openpowerquality/opq/README.md

Welcome to the master repository for OPQ technology. 

For details on OPQ, please see [http://openpowerquality.org](http://openpowerquality.org).
