openpowerquality/opq/box/Software/Readme.md

## Raspberry Pi firmware for opqbox2.
Directory listing:

- Triggering : Main data acquisition and local processing. C++
- kernel : Kernel driver for the OPQBOX2. C
- DSPutill : Utilities for flashing and reseting the DSP. Python
- proto : Google Protobuf implementation of data serialization. Protobuf
- test : Tests for DSP firmware and software. Python/C/C++
