openpowerquality/opq/box/Schematics/v3/README.md

# OPQBox V3

Redesing of OPQBox v2 to utilize CHIP pro SBC designed in KiCAD.
