openpowerquality/opq/uh-metering-bridge/doc/summary.md

### Available meters to features

| Meter | Available Features |
|---|---|
|AG_ENGINEERING_MAIN_MTR|AVG_CURRENT_THD, AVG_VOLTAGE_THD, Amps, AmpsA, AmpsB, AmpsC, Frequency, PHASE_A_CF, PHASE_A_TX_THDF, PHASE_B_CF, PHASE_B_TX_THDF, PHASE_C_CF, PHASE_C_TX_THDF, PowerFactor, VAB, VAN, VBC, VBN, VCA, VCN, kVA, kVARS, kVARh, kVAh, kW, kWh|
|AG_ENGINEERING_MCC_MTR|AVG_CURRENT_THD, AVG_VOLTAGE_THD, Amps, AmpsA, AmpsB, AmpsC, COMM_ALARM, Frequency, PHASE_A_CF, PHASE_A_TX_THDF, PHASE_B_CF, PHASE_B_TX_THDF, PHASE_C_CF, PHASE_C_TX_THDF, PowerFactor, VAB, VAN, VBC, VBN, VCA, VCN, kVA, kVARS, kVARh, kVAh, kW, kWh|
|AGRICULTURAL_ENGINEERING_INST_BLDG_KEY_PERF_IND|WATTS_PER_SQ_FT, kW|
|AGRICULTURAL_SCIENCE_CUP|AG_SCIENCE_CH_1_STATUS, AG_SCIENCE_CH_2_STATUS, CHWP_1_Amps, CHWP_2_Amps, CHWR_Temp, CHWS_Temp, CHW_Flow, CT_1_Amps, CT_2_Amps, CWP_1_Amps, CWP_2_Amps, btu_hr|
|AG_SCIENCE_MCC_MTR|AVG_CURRENT_THD, AVG_VOLTAGE_THD, Amps, AmpsA, AmpsB, AmpsC, COMM_ALARM, Frequency, PHASE_A_CF, PHASE_A_TX_THDF, PHASE_B_CF, PHASE_B_TX_THDF, PHASE_C_CF, PHASE_C_TX_THDF, PowerFactor, VAB, VAN, VBC, VBN, VCA, VCN, kVA, kVARS, kVARh, kVAh, kW, kWh|
|ARCHITECTURE_BLDG_KEY_PERF_IND|WATTS_PER_SQ_FT, kW|
|AGRICULTURAL_SCIENCE_BLDG_KEY_PERF_IND|WATTS_PER_SQ_FT, kW|
|ATHLETICS_COMPLEX_CUP|CHWR_TEMP, CHWS_TEMP, CHW_FLOW, TOTAL_HEAT|
|ARCHITECTURE_MAIN_MTR|AmpsA, AmpsB, AmpsC, CURRENT_A_THD, CURRENT_B_THD, CURRENT_C_THD, Frequency, PowerFactor, SERIAL_NO, VAB, VAN, VBC, VBN, VCA, VCN, VOLAGE_CN_THD, VOLTAGE_AN_THD, VOLTAGE_BN_THD, VOLTAGE_CN_THD, kVA, kVARS, kVARh, kVAh, kW, kWh|
|BACHMAN_HALL_BLDG_KEY_PERF_IND|WATTS_PER_SQ_FT, kW|
|BACHMAN_HALL_MAIN_MTR|AmpsA, AmpsB, AmpsC, CURRENT_A_THD, CURRENT_B_THD, CURRENT_C_THD, Frequency, PowerFactor, VAB, VAN, VBC, VBN, VCA, VCN, VOLAGE_CN_THD, VOLTAGE_AN_THD, VOLTAGE_BN_THD, VOLTAGE_CN_THD, kVA, kVARS, kVARh, kVAh, kW, kWh|
|BILGER_ADD_HALL_CUP|BILGER_ADD_HALL_CHWP_1_STATUS, BILGER_ADD_HALL_CHWP_2_STATUS, BILGER_ADD_HALL_CH_1_STATUS, BILGER_ADD_HALL_CT_1_STATUS, BILGER_ADD_HALL_CT_2_STATUS, BILGER_ADD_HALL_CWP_1_STATUS, BILGER_ADD_HALL_CWP_2_STATUS, CHWR_Temp, CHWS_Temp, CHW_Flow, TOTAL_HEAT|
|BILGER_ADDITION_HALL_BLDG_KEY_PERF_IND|WATTS_PER_SQ_FT, kW|
|BIOMEDICAL_SCIENCE_CUP|CHWR_TEMP, CHWS_TEMP, CHW_FLOW, TOTAL_HEAT|
|BIOMEDICAL_SCIENCE_BLDG_KEY_PERF_IND|WATTS_PER_SQ_FT, kW|
|BIOMEDICAL_SCIENCE_CH_1_MTR|AVG_CURRENT_THD, AVG_VOLTAGE_THD, Amps, AmpsA, AmpsB, AmpsC, Frequency, PHASE_A_CF, PHASE_A_TX_THDF, PHASE_B_CF, PHASE_B_TX_THDF, PHASE_C_CF, PHASE_C_TX_THDF, PowerFactor, VAB, VAN, VBC, VBN, VCA, VCN, kVA, kVARS, kVARh, kVAh, kW, kWh|
|BIOMEDICAL_SCIENCE_CH_2_MTR|AVG_CURRENT_THD, AVG_VOLTAGE_THD, Amps, AmpsA, AmpsB, AmpsC, Frequency, PHASE_A_CF, PHASE_A_TX_THDF, PHASE_B_CF, PHASE_B_TX_THDF, PHASE_C_CF, PHASE_C_TX_THDF, PowerFactor, VAB, VAN, VBC, VBN, VCA, VCN, kVA, kVARS, kVARh, kVAh, kW, kWh|
|BIOMEDICAL_SCIENCE_MAIN_A_MTR|AVG_CURRENT_THD, AVG_VOLTAGE_THD, Amps, AmpsA, AmpsB, AmpsC, Frequency, PHASE_A_CF, PHASE_A_TX_THDF, PHASE_B_CF, PHASE_B_TX_THDF, PHASE_C_CF, PHASE_C_TX_THDF, PowerFactor, VAB, VAN, VBC, VBN, VCA, VCN, kVA, kVARS, kVARh, kVAh, kW, kWh|
|BIOMEDICAL_SCIENCE_MAIN_B_MTR|AVG_CURRENT_THD, AVG_VOLTAGE_THD, Amps, AmpsA, AmpsB, AmpsC, Frequency, PHASE_A_CF, PHASE_A_TX_THDF, PHASE_B_CF, PHASE_B_TX_THDF, PHASE_C_CF, PHASE_C_TX_THDF, PowerFactor, VAB, VAN, VBC, VBN, VCA, VCN, kVA, kVARS, kVARh, kVAh, kW, kWh|
|BIOMEDICAL_SCIENCE_MCC_A_MTR|AVG_CURRENT_THD, AVG_VOLTAGE_THD, Amps, AmpsA, AmpsB, AmpsC, Frequency, PHASE_A_CF, PHASE_A_TX_THDF, PHASE_B_CF, PHASE_B_TX_THDF, PHASE_C_CF, PHASE_C_TX_THDF, PowerFactor, VAB, VAN, VBC, VBN, VCA, VCN, kVA, kVARS, kVARh, kVAh, kW, kWh|
|SHIDLER_COBA_CUP|CHWR_TEMP, CHWS_TEMP, CHW_FLOW, TOTAL_HEAT|
|BUS_AD_SHIDLER_MAIN_MTR|AmpsA, AmpsB, AmpsC, CURRENT_A_THD, CURRENT_B_THD, CURRENT_C_THD, Frequency, PowerFactor, VAB, VAN, VBC, VBN, VCA, VCN, VOLAGE_CN_THD, VOLTAGE_AN_THD, VOLTAGE_BN_THD, kVA, kVARS, kVARh, kVAh, kW, kWh|
|BUSINESS_ADMINISTRATION_BLDG_KEY_PERF_IND|WATTS_PER_SQ_FT, kW|
|CENTER_FOR_KOREAN_STUDIES_BLDG_KEY_PERF_IND|WATTS_PER_SQ_FT, kW|
|KOREAN_STUDIES_MAIN_MTR|AmpsA, AmpsB, AmpsC, CURRENT_A_THD, CURRENT_B_THD, CURRENT_C_THD, Frequency, PowerFactor, VAB, VAN, VBC, VBN, VCA, VCN, VOLTAGE_AN_THD, VOLTAGE_BN_THD, VOLTAGE_CN_THD, kVA, kVARS, kVARh, kVAh, kW, kWh|
|CRAWFORD_LAW_BLDG_KEY_PERF_IND|WATTS_PER_SQ_FT, kW|
|CRAWFORD_HALL_MAIN_MTR|AmpsA, AmpsB, AmpsC, CURRENT_A_THD, CURRENT_B_THD, CURRENT_C_THD, Frequency, PowerFactor, VAB, VAN, VBC, VBN, VCA, VCN, VOLAGE_CN_THD, VOLTAGE_AN_THD, VOLTAGE_BN_THD, VOLTAGE_CN_THD, kVA, kVARS, kVARh, kVAh, kW, kWh|
|DEAN_HALL_BLDG_KEY_PERF_IND|WATTS_PER_SQ_FT, kW|
|DEAN_HALL_MAIN_MTR|AVG_CURRENT_THD, AVG_VOLTAGE_THD, Amps, AmpsA, AmpsB, AmpsC, Frequency, PHASE_A_CF, PHASE_A_TX_THDF, PHASE_B_CF, PHASE_B_TX_THDF, PHASE_C_CF, PHASE_C_TX_THDF, PowerFactor, VAB, VAN, VBC, VBN, VCA, VCN, kVA, kVARS, kVARh, kVAh, kW, kWh|
|DKAC_BLDG_KEY_PERF_IND|WATTS_PER_SQ_FT, kW|
|DKAC_POOL_MAIN_MTR|AmpsA, AmpsB, AmpsC, CURRENT_A_THD, CURRENT_B_THD, CURRENT_C_THD, Frequency, PowerFactor, VAB, VAN, VBC, VBN, VCA, VCN, VOLAGE_CN_THD, VOLTAGE_AN_THD, VOLTAGE_BN_THD, VOLTAGE_CN_THD, kVA, kVARS, kVARh, kVAh, kW, kWh|
|EDMONSON_HALL_CUP|CHWR_TEMP, CHWS_TEMP, CHW_FLOW, TOTAL_HEAT|
|EDMONSON_HALL_BLDG_KEY_PERF_IND|WATTS_PER_SQ_FT, kW|
|ENV_PROTECTION_FACILITY_BLDG_KEY_PERF_IND|WATTS_PER_SQ_FT, kW|
|ENV_PROTECTION_MAIN_MTR|AmpsA, AmpsB, AmpsC, CURRENT_A_THD, CURRENT_B_THD, CURRENT_C_THD, Frequency, PowerFactor, VAB, VAN, VBC, VBN, VCA, VCN, VOLAGE_CN_THD, VOLTAGE_AN_THD, VOLTAGE_BN_THD, VOLTAGE_CN_THD, kVA, kVARS, kVARh, kVAh, kW, kWh|
|EVERLY_HALL_BLDG_KEY_PERF_IND|WATTS_PER_SQ_FT, kW|
|EVERLY_HALL_MAIN_MTR|AVG_CURRENT_THD, AVG_VOLTAGE_THD, Amps, AmpsA, AmpsB, AmpsC, Frequency, PHASE_A_CF, PHASE_A_TX_THDF, PHASE_B_CF, PHASE_B_TX_THDF, PHASE_C_CF, PHASE_C_TX_THDF, PowerFactor, VAB, VAN, VBC, VBN, VCA, VCN, kVA, kVARS, kVARh, kVAh, kW, kWh|
|FROG_1_AHU|DUCT_RETURN_HUMIDITY, DUCT_RETURN_TEMP, DUCT_SUPPLY_HUMIDITY, DUCT_SUPPLY_TEMP, KWH, KW_AVERAGE, kW|
|FROG_1_BLDG_SERVICES|KWH, KW_AVERAGE, kW|
|FROG_1_CEILING_FANS|KWH, KW_AVERAGE, kW|
|FROG_1_CHILLER|KWH, KW_AVERAGE, kW|
|FROG_1_EXTERIOR_LIGHTS|KWH, KW_AVERAGE, kW|
|FROG_1_FIRE_ALARM|KWH, KW_AVERAGE, kW|
|FROG_1_LUTRON_LIGHTS|KWH, KW_AVERAGE, kW|
|FROG_1_SERVICE_LIGHTS|KWH, KW_AVERAGE, kW|
|FROG_1_SOLAR_1|KWH, KW_AVERAGE, kW|
|FROG_1_SOLAR_2|KWH, KW_AVERAGE, kW|
|FROG_1_SPACE_ENVIRONMENT|CO2, WALL_TEMP_1, WALL_TEMP_2, WALL_TEMP_3, ZONE_1_HUMIDITY, ZONE_1_TEMP, ZONE_2_HUMIDITY, ZONE_2_TEMP|
|FROG_1_WHOLE_BLDG|KWH, KW_AVERAGE, kW|
|FROG_1_WINDOW_ACTUATORS|KWH, KW_AVERAGE, kW|
|FROG_1_WEATHER_STATION|BAROMETRIC_PRESSURE, DEWPOINT, HUMIDITY, SOLAR_RADIATION, TEMP_DRY_BULB, WIND_DIRECTION, WIND_SPEED|
|FROG_2_AHU|DUCT_RETURN_HUMIDITY, DUCT_RETURN_TEMP, DUCT_SUPPLY_HUMIDITY, DUCT_SUPPLY_TEMP, KWH, KW_AVERAGE, kW|
|FROG_2_BLDG_SERVICES|KWH, KW_AVERAGE, kW|
|FROG_2_CEILING_FANS|KWH, KW_AVERAGE, kW|
|FROG_2_CHILLER|KWH, KW_AVERAGE, kW|
|FROG_2_EXTERIOR_LIGHTS|KWH, KW_AVERAGE, kW|
|FROG_2_FIRE_ALARM|KWH, KW_AVERAGE, kW|
|FROG_2_LUTRON_LIGHTS|KWH, KW_AVERAGE, kW|
|FROG_2_SERVICE_LIGHTS|KWH, KW_AVERAGE, kW|
|FROG_2_SOLAR_1|KWH, KW_AVERAGE, kW|
|FROG_2_SOLAR_2|KWH, KW_AVERAGE, kW|
|FROG_2_SPACE_ENVIRONMENT|CO2, WALL_TEMP_1, WALL_TEMP_2, WALL_TEMP_3, ZONE_1_HUMIDITY, ZONE_1_TEMP, ZONE_2_HUMIDITY, ZONE_2_TEMP|
|FROG_2_WHOLE_BLDG|KWH, KW_AVERAGE, kW|
|FROG_2_WINDOW_ACTUATORS|KWH, KW_AVERAGE, kW|
|GEORGE_HALL_BLDG_KEY_PERF_IND|WATTS_PER_SQ_FT, kW|
|GEORGE_HALL_MAIN_MTR|AVG_CURRENT_THD, AVG_VOLTAGE_THD, AmpsA, AmpsB, AmpsC, CURRENT_A_THD, CURRENT_B_THD, CURRENT_C_THD, Frequency, PowerFactor, VAB, VAN, VBC, VBN, VCA, VCN, VOLTAGE_AN_THD, VOLTAGE_BN_THD, VOLTAGE_CN_THD, kVA, kVARS, kVARh, kVAh, kW, kWh|
|GILMORE_HALL_CUP|CHWR_Temp, CHWS_Temp, CHW_Flow, GILMORE_HALL_CHWP_1_STATUS, GILMORE_HALL_CHWP_2_STATUS, GILMORE_HALL_CH_1_STATUS, GILMORE_HALL_CH_2_STATUS, GILMORE_HALL_CT_1_STATUS, GILMORE_HALL_CT_2_STATUS, GILMORE_HALL_CWP_1_STATUS, GILMORE_HALL_CWP_2_STATUS, TOTAL_HEAT|
|GILMORE_HALL_BLDG_KEY_PERF_IND|WATTS_PER_SQ_FT, kW|
|GILMORE_HALL_MAIN_A_MTR|AVG_CURRENT_THD, AVG_VOLTAGE_THD, Amps, AmpsA, AmpsB, AmpsC, Frequency, PHASE_A_CF, PHASE_A_TX_THDF, PHASE_B_CF, PHASE_B_TX_THDF, PHASE_C_CF, PHASE_C_TX_THDF, PowerFactor, VAB, VAN, VBC, VBN, VCA, VCN, kVA, kVARS, kVARh, kVAh, kW, kWh|
|GILMORE_HALL_MAIN_B_MTR|AVG_CURRENT_THD, AVG_VOLTAGE_THD, Amps, AmpsA, AmpsB, AmpsC, Frequency, PHASE_A_CF, PHASE_A_TX_THDF, PHASE_B_CF, PHASE_B_TX_THDF, PHASE_C_CF, PHASE_C_TX_THDF, PowerFactor, VAB, VAN, VBC, VBN, VCA, VCN, kVA, kVARS, kVARh, kVAh, kW, kWh|
|GILMORE_HALL_MCC_MTR|AVG_CURRENT_THD, AVG_VOLTAGE_THD, Amps, AmpsA, AmpsB, AmpsC, Frequency, PHASE_A_CF, PHASE_A_TX_THDF, PHASE_B_CF, PHASE_B_TX_THDF, PHASE_C_CF, PHASE_C_TX_THDF, PowerFactor, VAB, VAN, VBC, VBN, VCA, VCN, kVA, kVARS, kVARh, kVAh, kW, kWh|
|HAMILTON_LIBRARY_PH_III_CUP|CHWR_TEMP, CHWS_TEMP, CHW_FLOW, TOTAL_HEAT|
|HAMILTON_LIBRARY_PH_III_BLDG_KEY_PERF_IND|WATTS_PER_SQ_FT, kW|
|HAMILTON_LIB_PH_III_CH_1_MTR|AVG_CURRENT_THD, AVG_VOLTAGE_THD, Amps, AmpsA, AmpsB, AmpsC, Frequency, PHASE_A_CF, PHASE_A_TX_THDF, PHASE_B_CF, PHASE_B_TX_THDF, PHASE_C_CF, PHASE_C_TX_THDF, PowerFactor, VAB, VAN, VBC, VBN, VCA, VCN, kVA, kVARS, kVARh, kVAh, kW, kWh|
|HAMILTON_LIB_PH_III_CH_2_MTR|AVG_CURRENT_THD, AVG_VOLTAGE_THD, Amps, AmpsA, AmpsB, AmpsC, Frequency, PHASE_A_CF, PHASE_A_TX_THDF, PHASE_B_CF, PHASE_B_TX_THDF, PHASE_C_CF, PHASE_C_TX_THDF, PowerFactor, VAB, VAN, VBC, VBN, VCA, VCN, kVA, kVARS, kVARh, kVAh, kW, kWh|
|HAMILTON_LIB_PH_III_CH_3_MTR|AVG_CURRENT_THD, AVG_VOLTAGE_THD, Amps, AmpsA, AmpsB, AmpsC, Frequency, PHASE_A_CF, PHASE_A_TX_THDF, PHASE_B_CF, PHASE_B_TX_THDF, PHASE_C_CF, PHASE_C_TX_THDF, PowerFactor, VAB, VAN, VBC, VBN, VCA, VCN, kVA, kVARS, kVARh, kVAh, kW, kWh|
|HAMILTON_LIB_PH_III_MAIN_1_MTR|AVG_CURRENT_THD, AVG_VOLTAGE_THD, AmpsA, AmpsB, AmpsC, Frequency, PHASE_A_CF, PHASE_A_TX_THDF, PHASE_B_CF, PHASE_B_TX_THDF, PHASE_C_CF, PHASE_C_TX_THDF, PowerFactor, VAB, VAN, VBC, VBN, VCA, VCN, kVA, kVARS, kVARh, kVAh, kW, kWh|
|HAMILTON_LIB_PH_III_MAIN_2_MTR|AVG_CURRENT_THD, AVG_VOLTAGE_THD, Amps, AmpsA, AmpsB, AmpsC, Frequency, PHASE_A_CF, PHASE_A_TX_THDF, PHASE_B_CF, PHASE_B_TX_THDF, PHASE_C_CF, PHASE_C_TX_THDF, PowerFactor, VAB, VAN, VBC, VBN, VCA, VCN, kVA, kVARS, kVARh, kVAh, kW, kWh|
|HAMILTON_LIB_PH_III_MCC_AC1_MTR|AVG_CURRENT_THD, AVG_VOLTAGE_THD, Amps, AmpsA, AmpsB, AmpsC, Frequency, PHASE_A_CF, PHASE_A_TX_THDF, PHASE_B_CF, PHASE_B_TX_THDF, PHASE_C_CF, PHASE_C_TX_THDF, PowerFactor, VAB, VAN, VBC, VBN, VCA, VCN, kVA, kVARS, kVARh, kVAh, kW, kWh|
|HAMILTON_LIB_PH_III_MCC_AC2_MTR|AVG_CURRENT_THD, AVG_VOLTAGE_THD, Amps, AmpsA, AmpsB, AmpsC, Frequency, PHASE_A_CF, PHASE_A_TX_THDF, PHASE_B_CF, PHASE_B_TX_THDF, PHASE_C_CF, PHASE_C_TX_THDF, PowerFactor, VAB, VAN, VBC, VBN, VCA, VCN, kVA, kVARS, kVARh, kVAh, kW, kWh|
|HAWAII_HALL_BLDG_KEY_PERF_IND|WATTS_PER_SQ_FT, kW|
|HAWAII_HALL_MAIN_MTR|AmpsA, AmpsB, AmpsC, CURRENT_A_THD, CURRENT_B_THD, CURRENT_C_THD, Frequency, PowerFactor, VAB, VAN, VBC, VBN, VCA, VCN, VOLAGE_CN_THD, VOLTAGE_AN_THD, VOLTAGE_BN_THD, VOLTAGE_CN_THD, kVA, kVARS, kVARh, kVAh, kW, kWh|
|HIG_BLDG_KEY_PERF_IND|WATTS_PER_SQ_FT, kW|
|HIG_NOAA_MTR|AVG_CURRENT_THD, AVG_VOLTAGE_THD, Amps, AmpsA, AmpsB, AmpsC, Frequency, PHASE_A_CF, PHASE_A_TX_THDF, PHASE_B_CF, PHASE_B_TX_THDF, PHASE_C_CF, PHASE_C_TX_THDF, PowerFactor, VAB, VAN, VBC, VBN, VCA, VCN, kVA, kVARS, kVARh, kVAh, kW, kWh|
|HIG_PANEL_PB_MTR|Amps, AmpsA, AmpsB, AmpsC, Frequency, PHASE_A_CF, PHASE_A_TX_THDF, PHASE_B_CF, PHASE_B_TX_THDF, PHASE_C_CF, PHASE_C_TX_THDF, PowerFactor, VAB, VAN, VBC, VBN, VCA, VCN, kVA, kVARS, kVARh, kVAh, kW, kWh|
|HIG_PANEL_PBA_MTR|Amps, AmpsA, AmpsB, AmpsC, Frequency, PHASE_A_CF, PHASE_A_TX_THDF, PHASE_B_CF, PHASE_B_TX_THDF, PHASE_C_CF, PHASE_C_TX_THDF, PowerFactor, VAB, VAN, VBC, VBN, VCA, VCN, kVA, kVARS, kVARh, kVAh, kW, kWh|
|HIG_SUBSTATION_1_MAIN_MTR|Amps, AmpsA, AmpsB, AmpsC, EVENT_NUMBER, FLAG_1_ALARM_STATUS, FLAG_2_ALARM_STATUS, Frequency, GENERAL_ALARM_STATUS, PHASE_A_CF, PHASE_A_TX_THDF, PHASE_B_CF, PHASE_B_TX_THDF, PHASE_C_CF, PHASE_C_TX_THDF, PowerFactor, VAB, VAN, VBC, VBN, VCA, VCN, kVA, kVARS, kVARh, kVAh, kW, kWh|
|HIG_SUBSTATION_2_MAIN_MTR|Amps, AmpsA, AmpsB, AmpsC, Frequency, PHASE_A_CF, PHASE_A_TX_THDF, PHASE_B_CF, PHASE_B_TX_THDF, PHASE_C_CF, PHASE_C_TX_THDF, PowerFactor, VAB, VAN, VBC, VBN, VCA, VCN, kVA, kVARS, kVARh, kVAh, kW, kWh|
|HIG_SUBSTATION_3_MAIN_MTR|Amps, AmpsA, AmpsB, AmpsC, Frequency, PHASE_A_CF, PHASE_A_TX_THDF, PHASE_B_CF, PHASE_B_TX_THDF, PHASE_C_CF, PHASE_C_TX_THDF, PowerFactor, VAB, VAN, VBC, VBN, VCA, VCN, kVA, kVARS, kVARh, kVAh, kW, kWh|
|HPER_BLDG_KEY_PERF_IND|WATTS_PER_SQ_FT, kW|
|HPER_KLUM_GYM_MTR|AmpsA, AmpsB, AmpsC, CURRENT_A_THD, CURRENT_B_THD, CURRENT_C_THD, Frequency, PowerFactor, VAB, VAN, VBC, VBN, VCA, VCN, VOLTAGE_AN_THD, VOLTAGE_BN_THD, VOLTAGE_CN_THD, kVA, kVARS, kVARh, kVAh, kW, kWh|
|HPER_MAIN_MTR|Amps, AmpsA, AmpsB, AmpsC, CURRENT_A_THD, CURRENT_B_THD, CURRENT_C_THD, Frequency, PowerFactor, VAB, VAN, VBC, VBN, VCA, VCN, VOLTAGE_AN_THD, VOLTAGE_BN_THD, VOLTAGE_CN_THD, kVA, kVARS, kVARh, kVAh, kW, kWh|
|INSTITUTE_FOR_ASTRONOMY_CUP|CHWR_TEMP, CHWS_TEMP, CHW_FLOW, TOTAL_HEAT|
|INSITITUTE_FOR_ASTRONOMY_BLDG_KEY_PERF_IND|WATTS_PER_SQ_FT, kW|
|IT_CENTER_CUP|CHWR_TEMP, CHWS_TEMP, CHW_FLOW, TOTAL_HEAT|
|IT_CENTER_BLDG_KEY_PERF_IND|WATTS_PER_SQ_FT, kW|
|KELLER_HALL_BLDG_KEY_PERF_IND|WATTS_PER_SQ_FT, kW|
|KELLER_HALL_MAIN_MTR|AmpsA, AmpsB, AmpsC, CURRENT_A_THD, CURRENT_B_THD, CURRENT_C_THD, Frequency, PowerFactor, VAB, VAN, VBC, VBN, VCA, VCN, VOLAGE_CN_THD, VOLTAGE_AN_THD, VOLTAGE_BN_THD, VOLTAGE_CN_THD, kVA, kVARS, kVARh, kVAh, kW, kWh|
|PHYSICAL_SCIENCE_KELLER_COMP_MTR|AmpsA, AmpsB, AmpsC, CURRENT_A_THD, CURRENT_B_THD, CURRENT_C_THD, Frequency, PowerFactor, VAB, VAN, VBC, VBN, VCA, VCN, VOLAGE_CN_THD, VOLTAGE_AN_THD, VOLTAGE_BN_THD, VOLTAGE_CN_THD, kVA, kVARS, kVARh, kVAh, kW, kWh|
|KENNEDY_THEATRE_BLDG_KEY_PERF_IND|WATTS_PER_SQ_FT, kW|
|KENNEDY_THEATRE_MAIN_MTR|AmpsA, AmpsB, AmpsC, CURRENT_A_THD, CURRENT_B_THD, CURRENT_C_THD, Frequency, PowerFactor, VAB, VAN, VBC, VBN, VCA, VCN, VOLTAGE_AN_THD, VOLTAGE_BN_THD, VOLTAGE_CN_THD, kVA, kVARS, kVARh, kVAh, kW, kWh|
|KRAUSS_HALL_MAIN_MTR|AmpsA, AmpsB, AmpsC, CURRENT_A_THD, CURRENT_B_THD, CURRENT_C_THD, Frequency, PowerFactor, VAB, VAN, VBC, VBN, VCA, VCN, VOLTAGE_AN_THD, VOLTAGE_BN_THD, VOLTAGE_CN_THD, kVA, kVARS, kVARh, kVAh, kW, kWh|
|KRAUSS_PRI_BLDG_KEY_PERF_IND|WATTS_PER_SQ_FT, kW|
|KUYKENDALL_HALL_CUP|CHWR_TEMP, CHWS_TEMP|
|KUYKENDALL_HALL_BLDG_KEY_PERF_IND|WATTS_PER_SQ_FT, kW|
|LAW_LIB_MAIN_MTR|AmpsA, AmpsB, AmpsC, CURRENT_A_THD, CURRENT_B_THD, CURRENT_C_THD, Frequency, PowerFactor, VAB, VAN, VBC, VBN, VCA, VCN, VOLTAGE_AN_THD, VOLTAGE_BN_THD, VOLTAGE_CN_THD, kVA, kVARS, kVARh, kVAh, kW, kWh|
|LAW_LIBRARY_BLDG_KEY_PERF_IND|WATTS_PER_SQ_FT, kW|
|LAW_SCHOOL_BLDG_KEY_PERF_IND|WATTS_PER_SQ_FT, kW|
|LAW_SCHOOL_MAIN_MTR|AmpsA, AmpsB, AmpsC, CURRENT_A_THD, CURRENT_B_THD, CURRENT_C_THD, Frequency, PowerFactor, VAB, VAN, VBC, VBN, VCA, VCN, VOLTAGE_AN_THD, VOLTAGE_BN_THD, VOLTAGE_CN_THD, kVA, kVARS, kVARh, kVAh, kW, kWh|
|LES_MURAKAMI_STADIUM_BLDG_KEY_PERF_IND|WATTS_PER_SQ_FT, kW|
|LES_MURAKAMI_STADIUM_CONSESS_MTR|AmpsA, AmpsB, AmpsC, CURRENT_A_THD, CURRENT_B_THD, CURRENT_C_THD, Frequency, PowerFactor, VAB, VAN, VBC, VBN, VCA, VCN, VOLTAGE_AN_THD, VOLTAGE_BN_THD, VOLTAGE_CN_THD, kVA, kVARS, kVARh, kVAh, kW, kWh|
|LES_MURAKAMI_STADIUM_MAIN_MTR|AmpsA, AmpsB, AmpsC, CURRENT_A_THD, CURRENT_B_THD, CURRENT_C_THD, Frequency, PowerFactor, VAB, VAN, VBC, VBN, VCA, VCN, VOLTAGE_AN_THD, VOLTAGE_BN_THD, VOLTAGE_CN_THD, kVA, kVARS, kVARh, kVAh, kW, kWh|
|MARINE_SCIENCE_CUP|CHWR_Temp, CHWS_Temp, CHW_Flow, CT_1_Amps, CT_2_Status_Amps, CWP_1_Amps, CWP_2_Amps, MARINE_SCIENCE_CHWP_1_STATUS, MARINE_SCIENCE_CHWP_2_STATUS, MARINE_SCIENCE_CH_1_STATUS, MARINE_SCIENCE_CH_2_STATUS, TOTAL_HEAT|
|MARINE_SCIENCE_BLDG_KEY_PERF_IND|WATTS_PER_SQ_FT, kW|
|MARINE_SCIENCE_MAIN_A_MTR|AVG_CURRENT_THD, AVG_VOLTAGE_THD, Amps, AmpsA, AmpsB, AmpsC, Frequency, PHASE_A_CF, PHASE_A_TX_THDF, PHASE_B_CF, PHASE_B_TX_THDF, PHASE_C_CF, PHASE_C_TX_THDF, PowerFactor, VAB, VAN, VBC, VBN, VCA, VCN, kVA, kVARS, kVARh, kVAh, kW, kWh|
|MARINE_SCIENCE_MAIN_B_MTR|AVG_CURRENT_THD, AVG_VOLTAGE_THD, Amps, AmpsA, AmpsB, AmpsC, Frequency, PHASE_A_CF, PHASE_A_TX_THDF, PHASE_B_CF, PHASE_B_TX_THDF, PHASE_C_CF, PHASE_C_TX_THDF, PowerFactor, VAB, VAN, VBC, VBN, VCA, VCN, kVA, kVARS, kVARh, kVAh, kW, kWh|
|MARINE_SCIENCE_MCC_MTR|AVG_CURRENT_THD, AVG_VOLTAGE_THD, Amps, AmpsA, AmpsB, AmpsC, Frequency, PHASE_A_CF, PHASE_A_TX_THDF, PHASE_B_CF, PHASE_B_TX_THDF, PHASE_C_CF, PHASE_C_TX_THDF, PowerFactor, VAB, VAN, VBC, VBN, VCA, VCN, kVA, kVARS, kVARh, kVAh, kW, kWh|
|MILLER_HALL_BLDG_KEY_PERF_IND|WATTS_PER_SQ_FT, kW|
|MILLER_HALL_MAIN_MTR|AVG_CURRENT_THD, AVG_VOLTAGE_THD, Amps, AmpsA, AmpsB, AmpsC, Frequency, PHASE_A_CF, PHASE_A_TX_THDF, PHASE_B_CF, PHASE_B_TX_THDF, PHASE_C_CF, PHASE_C_TX_THDF, PowerFactor, VAB, VAN, VBC, VBN, VCA, VCN, kVA, kVARS, kVARh, kVAh, kW, kWh|
|MOORE_HALL_CUP|RISER_1_CHWR_TEMP, RISER_1_CHWS_TEMP, RISER_1_CHW_FLOW, RISER_2_CHWR_TEMP, RISER_2_CHWS_TEMP, RISER_2_CHW_FLOW, TOTAL_HEAT|
|MOORE_HALL_BLDG_KEY_PERF_IND|WATTS_PER_SQ_FT, kW|
|MOORE_HALL_MAIN_MTR|AmpsA, AmpsB, AmpsC, CURRENT_A_THD, CURRENT_B_THD, CURRENT_C_THD, Frequency, PowerFactor, VAB, VAN, VBC, VBN, VCA, VCN, VOLTAGE_AN_THD, VOLTAGE_BN_THD, VOLTAGE_CN_THD, kVA, kVARS, kVARh, kVAh, kW, kWh|
|MUSIC_COMPLEX_CUP|CHWR_TEMP, CHWS_TEMP, CHW_FLOW, TOTAL_HEAT|
|MUSIC_COMPLEX_MAIN_MTR|AmpsA, AmpsB, AmpsC, CURRENT_A_THD, CURRENT_B_THD, CURRENT_C_THD, Frequency, PowerFactor, VAB, VAN, VBC, VBN, VCA, VCN, VOLTAGE_AN_THD, VOLTAGE_BN_THD, VOLTAGE_CN_THD, kVA, kVARS, kVARh, kVAh, kW, kWh|
|MUSIC_COMPLEX_PH_I_BLDG_KEY_PERF_IND|WATTS_PER_SQ_FT, kW|
|PBRC_BLDG_KEY_PERF_IND|WATTS_PER_SQ_FT, kW|
|PBRC_MAIN_A_MTR|AmpsA, AmpsB, AmpsC, CURRENT_A_THD, CURRENT_B_THD, CURRENT_C_THD, Frequency, PowerFactor, VAB, VAN, VBC, VBN, VCA, VCN, VOLTAGE_AN_THD, VOLTAGE_BN_THD, VOLTAGE_CN_THD, kVA, kVARS, kVARh, kVAh, kW, kWh|
|PBRC_MAIN_B_MTR|AmpsA, AmpsB, AmpsC, CURRENT_A_THD, CURRENT_B_THD, CURRENT_C_THD, Frequency, PowerFactor, VAB, VAN, VBC, VBN, VCA, VCN, VOLTAGE_AN_THD, VOLTAGE_BN_THD, VOLTAGE_CN_THD, kVA, kVARS, kVARh, kVAh, kW, kWh|
|PBRC_SATCON_GEN_2|KWH, kW|
|PHYSICAL_SCIENCE_BLDG_KEY_PERF_IND|WATTS_PER_SQ_FT, kW|
|PHYSICAL_SCIENCE_MAIN_MTR|AVG_CURRENT_THD, AVG_VOLTAGE_THD, Amps, AmpsA, AmpsB, AmpsC, Frequency, PHASE_A_CF, PHASE_A_TX_THDF, PHASE_B_CF, PHASE_B_TX_THDF, PHASE_C_CF, PHASE_C_TX_THDF, PowerFactor, VAB, VAN, VBC, VBN, VCA, VCN, kVA, kVARS, kVARh, kVAh, kW, kWh|
|POST_CUP|PCHWR_Temp, PCHWS_Temp, POST_CHWP_1_STATUS, POST_CHWP_2_STATUS, POST_CHWP_3_STATUS, POST_CH_1_STATUS, POST_CH_2_STATUS, POST_CT_1_STATUS, POST_CT_2_STATUS, POST_CT_3_STATUS, POST_CWP_1_STATUS, POST_CWP_2_STATUS, POST_CWP_3_STATUS, POST_SCHWP_1_STATUS, POST_SCHWP_2_STATUS, POST_SCHWP_3_STATUS|
|POST_BLDG_KEY_PERF_IND|WATTS_PER_SQ_FT, kW|
|POST_CHILLER_PLANT_MAIN|AVG_CURRENT_THD, AVG_VOLTAGE_THD, Amps, AmpsA, AmpsB, AmpsC, Frequency, PHASE_A_CF, PHASE_A_TX_THDF, PHASE_B_CF, PHASE_B_TX_THDF, PHASE_C_CF, PHASE_C_TX_THDF, PowerFactor, VAB, VAN, VBC, VBN, VCA, VCN, kVA, kVARS, kVARh, kVAh, kW, kWh|
|POST_MAIN_1|AVG_CURRENT_THD, AVG_VOLTAGE_THD, Amps, AmpsA, AmpsB, AmpsC, Frequency, PHASE_A_CF, PHASE_A_TX_THDF, PHASE_B_CF, PHASE_B_TX_THDF, PHASE_C_CF, PHASE_C_TX_THDF, PowerFactor, VAB, VAN, VBC, VBN, VCA, VCN, kVA, kVARS, kVARh, kVAh, kW, kWh|
|POST_MAIN_2|AVG_CURRENT_THD, AVG_VOLTAGE_THD, Amps, AmpsA, AmpsB, AmpsC, Frequency, PHASE_A_CF, PHASE_A_TX_THDF, PHASE_B_CF, PHASE_B_TX_THDF, PHASE_C_CF, PHASE_C_TX_THDF, PowerFactor, VAB, VAN, VBC, VBN, VCA, VCN, kVA, kVARS, kVARh, kVAh, kW, kWh|
|QLC_CUP|CHWR_TEMP, CHWS_TEMP, CHW_FLOW, TOTAL_HEAT|
|QLCSS_BLDG_KEY_PERF_IND|WATTS_PER_SQ_FT, kW|
|QLCSS_MAIN_MTR|AmpsA, AmpsB, AmpsC, CURRENT_A_THD, CURRENT_B_THD, CURRENT_C_THD, Frequency, PowerFactor, VAB, VAN, VBC, VBN, VCA, VCN, VOLTAGE_AN_THD, VOLTAGE_BN_THD, VOLTAGE_CN_THD, kVA, kVARS, kVARh, kVAh, kW, kWh|
|QUAD_CHILLER_PLANT_MAIN_MTR|AVG_CURRENT_THD, AVG_VOLTAGE_THD, Amps, AmpsA, AmpsB, AmpsC, Frequency, PHASE_A_CF, PHASE_A_TX_THDF, PHASE_B_CF, PHASE_B_TX_THDF, PHASE_C_CF, PHASE_C_TX_THDF, PowerFactor, VAB, VAN, VBC, VBN, VCA, VCN, kVA, kVARS, kVARh, kVAh, kW, kWh|
|QUADRANGLE_LOOP_BLDG_KEY_PERF_IND|WATTS_PER_SQ_FT, kW|
|SAKAMAKI_HALL_AC_EQPT_MTR|AVG_CURRENT_THD, AVG_VOLTAGE_THD, Amps, AmpsA, AmpsB, AmpsC, Frequency, PHASE_A_CF, PHASE_A_TX_THDF, PHASE_B_CF, PHASE_B_TX_THDF, PHASE_C_CF, PHASE_C_TX_THDF, PowerFactor, VAB, VAN, VBC, VBN, VCA, VCN, kVA, kVARS, kVARh, kVAh, kW, kWh|
|SAKAMAKI_HALL_BLDG_KEY_PERF_IND|WATTS_PER_SQ_FT, kW|
|SAKAMAKI_HALL_MAIN_MTR|AVG_CURRENT_THD, AVG_VOLTAGE_THD, Amps, AmpsA, AmpsB, AmpsC, Frequency, PHASE_A_CF, PHASE_A_TX_THDF, PHASE_B_CF, PHASE_B_TX_THDF, PHASE_C_CF, PHASE_C_TX_THDF, PowerFactor, VAB, VAN, VBC, VBN, VCA, VCN, kVA, kVARS, kVARh, kVAh, kW, kWh|
|SAUNDERS_HALL_CUP|CHWP_1_AMPS, CHWP_2_AMPS, CHWR_TEMP, CHWS_TEMP, CHW_FLOW, CT_1_AMPS, CT_2_AMPS, CWP_1_AMPS, CWP_2_AMPS, SAUNDERS_HALL_CH_1_STATUS, SAUNDERS_HALL_CH_2_STATUS, TOTAL_HEAT|
|SAUNDERS_HALL_BLDG_KEY_PERF_IND|WATTS_PER_SQ_FT, kW|
|SAUNDERS_HALL_MAIN_A_MTR|AVG_CURRENT_THD, AVG_VOLTAGE_THD, Amps, AmpsA, AmpsB, AmpsC, Frequency, PHASE_A_CF, PHASE_A_TX_THDF, PHASE_B_CF, PHASE_B_TX_THDF, PHASE_C_CF, PHASE_C_TX_THDF, PowerFactor, VAB, VAN, VBC, VBN, VCA, VCN, kVA, kVARS, kVARh, kVAh, kW, kWh|
|SAUNDERS_HALL_MAIN_B_MTR|AVG_CURRENT_THD, AVG_VOLTAGE_THD, Amps, AmpsA, AmpsB, AmpsC, Frequency, PHASE_A_CF, PHASE_A_TX_THDF, PHASE_B_CF, PHASE_B_TX_THDF, PHASE_C_CF, PHASE_C_TX_THDF, PowerFactor, VAB, VAN, VBC, VBN, VCA, VCN, kVA, kVARS, kVARh, kVAh, kW, kWh|
|SHERMAN_LAB_CUP|CHWR_Temp, CHWS_Temp, CHW_Flow_Vel|
|SHERMAN_LAB_BLDG_KEY_PERF_IND|WATTS_PER_SQ_FT, kW|
|SHERMAN_MAIN_1_MTR|AVG_CURRENT_THD, AVG_VOLTAGE_THD, Amps, AmpsA, AmpsB, AmpsC, Frequency, PHASE_A_CF, PHASE_A_TX_THDF, PHASE_B_CF, PHASE_B_TX_THDF, PHASE_C_CF, PHASE_C_TX_THDF, PowerFactor, VAB, VAN, VBC, VBN, VCA, VCN, kVA, kVARS, kVARh, kVAh, kW, kWh|
|SHERMAN_MAIN_2_MTR|AVG_CURRENT_THD, AVG_VOLTAGE_THD, Amps, AmpsA, AmpsB, AmpsC, Frequency, PHASE_A_CF, PHASE_A_TX_THDF, PHASE_B_CF, PHASE_B_TX_THDF, PHASE_C_CF, PHASE_C_TX_THDF, PowerFactor, VAB, VAN, VBC, VBN, VCA, VCN, kVA, kVARS, kVARh, kVAh, kW, kWh|
|SPALDING_HALL_BLDG_KEY_PERF_IND|WATTS_PER_SQ_FT, kW|
|SPALDING_HALL_MAIN_MTR|AmpsA, AmpsB, AmpsC, CURRENT_A_THD, CURRENT_B_THD, CURRENT_C_THD, Frequency, PowerFactor, VAB, VAN, VBC, VBN, VCA, VCN, VOLTAGE_AN_THD, VOLTAGE_BN_THD, VOLTAGE_CN_THD, kVA, kVARS, kVARh, kVAh, kW, kWh|
|ST_JOHN_CUP|CHWR_Temp, CHWS_Temp, CHW_Flow, TOTAL_HEAT|
|ST_JOHN_BLDG_KEY_PERF_IND|WATTS_PER_SQ_FT, kW|
|ST_JOHN_PLANT_SCIENCE_MAIN_MTR|AVG_CURRENT_THD, AVG_VOLTAGE_THD, Amps, AmpsA, AmpsB, AmpsC, Frequency, PHASE_A_CF, PHASE_A_TX_THDF, PHASE_B_CF, PHASE_B_TX_THDF, PHASE_C_CF, PHASE_C_TX_THDF, PowerFactor, VAB, VAN, VBC, VBN, VCA, VCN, kVA, kVARS, kVARh, kVAh, kW, kWh|
|STAN_SHERRIFF_CUP|CHWR_TEMP, CHWS_TEMP, CHW_FLOW, TOTAL_HEAT|
|STAN_SHERIFF_CENTER_BLDG_KEY_PERF_IND|WATTS_PER_SQ_FT, kW|
|STAN_SHERIFF_CTR_MAIN_1_MTR|AVG_CURRENT_THD, AVG_VOLTAGE_THD, Amps, AmpsA, AmpsB, AmpsC, Frequency, PHASE_A_CF, PHASE_A_TX_THDF, PHASE_B_CF, PHASE_B_TX_THDF, PHASE_C_CF, PHASE_C_TX_THDF, PowerFactor, VAB, VAN, VBC, VBN, VCA, VCN, kVA, kVARS, kVARh, kVAh, kW, kWh|
|STAN_SHERIFF_CTR_MAIN_2_MTR|AVG_CURRENT_THD, AVG_VOLTAGE_THD, Amps, AmpsA, AmpsB, AmpsC, Frequency, PHASE_A_CF, PHASE_A_TX_THDF, PHASE_B_CF, PHASE_B_TX_THDF, PHASE_C_CF, PHASE_C_TX_THDF, PowerFactor, VAB, VAN, VBC, VBN, VCA, VCN, kVA, kVARS, kVARh, kVAh, kW, kWh|
|SUBSTATION_L_BLDG_KEY_PERF_IND|KWH, WATTS_PER_SQ_FT, kW|
|SUBSTATION_L_Q1_MTR|COMM_ALARM, KWH|
|SUBSTATION_L_Q2_MTR|COMM_ALARM, KWH|
|SUBSTATION_L_Q3_MTR|COMM_ALARM, KWH|
|MULTIPURPOSE_BLDG_MAIN_MTR|AmpsA, AmpsB, AmpsC, CURRENT_A_THD, CURRENT_B_THD, CURRENT_C_THD, Frequency, PowerFactor, VAB, VAN, VBC, VBN, VCA, VCN, VOLTAGE_AN_THD, VOLTAGE_BN_THD, VOLTAGE_CN_THD, kVA, kVARS, kVARh, kVAh, kW, kWh|
|UNIV_LAB_SCHOOL_MULTIPURPOSE_BLDG_KEY_PERF_IND|WATTS_PER_SQ_FT, kW|
|WARRIOR_CENTER_BLDG_KEY_PERF_IND|WATTS_PER_SQ_FT, kW|
|WARRIOR_CENTER_INV0|AC_CURRENT, AC_VOLTS, Frequency, KWH, kW|
|WARRIOR_CENTER_INV1|AC_CURRENT, AC_VOLTS, Frequency, KWH, kW|
|WARRIOR_CENTER_INV2|AC_CURRENT, AC_VOLTS, KWH, kW|
|WARRIOR_CENTER_INV3|AC_CURRENT, AC_VOLTS, KWH, kW|
|WEBSTER_HALL_BLDG_KEY_PERF_IND|WATTS_PER_SQ_FT, kW|
|WEBSTER_HALL_MAIN_MTR|AVG_CURRENT_THD, AVG_VOLTAGE_THD, Amps, AmpsA, AmpsB, AmpsC, Frequency, PHASE_A_CF, PHASE_A_TX_THDF, PHASE_B_CF, PHASE_B_TX_THDF, PHASE_C_CF, PHASE_C_TX_THDF, PowerFactor, VAB, VAN, VBC, VBN, VCA, VCN, kVA, kVARS, kVARh, kVAh, kW, kWh|
|WIST_HALL_EVERLY_HALL_CUP|CHWR_TEMP, CHWS_TEMP, EVERLY_HALL_FLOW, TOTAL_HEAT, WIST_HALL_EVERLY_HALL_CHWP_1_STATUS, WIST_HALL_EVERLY_HALL_CHWP_2_STATUS, WIST_HALL_EVERLY_HALL_CH_1_STATUS, WIST_HALL_EVERLY_HALL_CH_2_STATUS, WIST_HALL_EVERLY_HALL_CT_1_STATUS, WIST_HALL_EVERLY_HALL_CT_2_STATUS, WIST_HALL_EVERLY_HALL_CWP_1_STATUS, WIST_HALL_EVERLY_HALL_CWP_2_STATUS, WIST_HALL_FLOW|
|WIST_HALL_BLDG_KEY_PERF_IND|WATTS_PER_SQ_FT, kW|
|WIST_HALL_MAIN_MTR|AVG_CURRENT_THD, AVG_VOLTAGE_THD, Amps, AmpsA, AmpsB, AmpsC, Frequency, PHASE_A_CF, PHASE_A_TX_THDF, PHASE_B_CF, PHASE_B_TX_THDF, PHASE_C_CF, PHASE_C_TX_THDF, PowerFactor, VAB, VAN, VBC, VBN, VCA, VCN, kVA, kVARS, kVARh, kVAh, kW, kWh|

### Available features to meters
| Feature | Available Meters |
|---|---|
|AC_CURRENT|WARRIOR_CENTER_INV0, WARRIOR_CENTER_INV1, WARRIOR_CENTER_INV2, WARRIOR_CENTER_INV3|
|AC_VOLTS|WARRIOR_CENTER_INV0, WARRIOR_CENTER_INV1, WARRIOR_CENTER_INV2, WARRIOR_CENTER_INV3|
|AG_SCIENCE_CH_1_STATUS|AGRICULTURAL_SCIENCE_CUP|
|AG_SCIENCE_CH_2_STATUS|AGRICULTURAL_SCIENCE_CUP|
|AVG_CURRENT_THD|AG_ENGINEERING_MAIN_MTR, AG_ENGINEERING_MCC_MTR, AG_SCIENCE_MCC_MTR, BIOMEDICAL_SCIENCE_CH_1_MTR, BIOMEDICAL_SCIENCE_CH_2_MTR, BIOMEDICAL_SCIENCE_MAIN_A_MTR, BIOMEDICAL_SCIENCE_MAIN_B_MTR, BIOMEDICAL_SCIENCE_MCC_A_MTR, DEAN_HALL_MAIN_MTR, EVERLY_HALL_MAIN_MTR, GEORGE_HALL_MAIN_MTR, GILMORE_HALL_MAIN_A_MTR, GILMORE_HALL_MAIN_B_MTR, GILMORE_HALL_MCC_MTR, HAMILTON_LIB_PH_III_CH_1_MTR, HAMILTON_LIB_PH_III_CH_2_MTR, HAMILTON_LIB_PH_III_CH_3_MTR, HAMILTON_LIB_PH_III_MAIN_1_MTR, HAMILTON_LIB_PH_III_MAIN_2_MTR, HAMILTON_LIB_PH_III_MCC_AC1_MTR, HAMILTON_LIB_PH_III_MCC_AC2_MTR, HIG_NOAA_MTR, MARINE_SCIENCE_MAIN_A_MTR, MARINE_SCIENCE_MAIN_B_MTR, MARINE_SCIENCE_MCC_MTR, MILLER_HALL_MAIN_MTR, PHYSICAL_SCIENCE_MAIN_MTR, POST_CHILLER_PLANT_MAIN, POST_MAIN_1, POST_MAIN_2, QUAD_CHILLER_PLANT_MAIN_MTR, SAKAMAKI_HALL_AC_EQPT_MTR, SAKAMAKI_HALL_MAIN_MTR, SAUNDERS_HALL_MAIN_A_MTR, SAUNDERS_HALL_MAIN_B_MTR, SHERMAN_MAIN_1_MTR, SHERMAN_MAIN_2_MTR, ST_JOHN_PLANT_SCIENCE_MAIN_MTR, STAN_SHERIFF_CTR_MAIN_1_MTR, STAN_SHERIFF_CTR_MAIN_2_MTR, WEBSTER_HALL_MAIN_MTR, WIST_HALL_MAIN_MTR|
|AVG_VOLTAGE_THD|AG_ENGINEERING_MAIN_MTR, AG_ENGINEERING_MCC_MTR, AG_SCIENCE_MCC_MTR, BIOMEDICAL_SCIENCE_CH_1_MTR, BIOMEDICAL_SCIENCE_CH_2_MTR, BIOMEDICAL_SCIENCE_MAIN_A_MTR, BIOMEDICAL_SCIENCE_MAIN_B_MTR, BIOMEDICAL_SCIENCE_MCC_A_MTR, DEAN_HALL_MAIN_MTR, EVERLY_HALL_MAIN_MTR, GEORGE_HALL_MAIN_MTR, GILMORE_HALL_MAIN_A_MTR, GILMORE_HALL_MAIN_B_MTR, GILMORE_HALL_MCC_MTR, HAMILTON_LIB_PH_III_CH_1_MTR, HAMILTON_LIB_PH_III_CH_2_MTR, HAMILTON_LIB_PH_III_CH_3_MTR, HAMILTON_LIB_PH_III_MAIN_1_MTR, HAMILTON_LIB_PH_III_MAIN_2_MTR, HAMILTON_LIB_PH_III_MCC_AC1_MTR, HAMILTON_LIB_PH_III_MCC_AC2_MTR, HIG_NOAA_MTR, MARINE_SCIENCE_MAIN_A_MTR, MARINE_SCIENCE_MAIN_B_MTR, MARINE_SCIENCE_MCC_MTR, MILLER_HALL_MAIN_MTR, PHYSICAL_SCIENCE_MAIN_MTR, POST_CHILLER_PLANT_MAIN, POST_MAIN_1, POST_MAIN_2, QUAD_CHILLER_PLANT_MAIN_MTR, SAKAMAKI_HALL_AC_EQPT_MTR, SAKAMAKI_HALL_MAIN_MTR, SAUNDERS_HALL_MAIN_A_MTR, SAUNDERS_HALL_MAIN_B_MTR, SHERMAN_MAIN_1_MTR, SHERMAN_MAIN_2_MTR, ST_JOHN_PLANT_SCIENCE_MAIN_MTR, STAN_SHERIFF_CTR_MAIN_1_MTR, STAN_SHERIFF_CTR_MAIN_2_MTR, WEBSTER_HALL_MAIN_MTR, WIST_HALL_MAIN_MTR|
|Amps|AG_ENGINEERING_MAIN_MTR, AG_ENGINEERING_MCC_MTR, AG_SCIENCE_MCC_MTR, BIOMEDICAL_SCIENCE_CH_1_MTR, BIOMEDICAL_SCIENCE_CH_2_MTR, BIOMEDICAL_SCIENCE_MAIN_A_MTR, BIOMEDICAL_SCIENCE_MAIN_B_MTR, BIOMEDICAL_SCIENCE_MCC_A_MTR, DEAN_HALL_MAIN_MTR, EVERLY_HALL_MAIN_MTR, GILMORE_HALL_MAIN_A_MTR, GILMORE_HALL_MAIN_B_MTR, GILMORE_HALL_MCC_MTR, HAMILTON_LIB_PH_III_CH_1_MTR, HAMILTON_LIB_PH_III_CH_2_MTR, HAMILTON_LIB_PH_III_CH_3_MTR, HAMILTON_LIB_PH_III_MAIN_2_MTR, HAMILTON_LIB_PH_III_MCC_AC1_MTR, HAMILTON_LIB_PH_III_MCC_AC2_MTR, HIG_NOAA_MTR, HIG_PANEL_PB_MTR, HIG_PANEL_PBA_MTR, HIG_SUBSTATION_1_MAIN_MTR, HIG_SUBSTATION_2_MAIN_MTR, HIG_SUBSTATION_3_MAIN_MTR, HPER_MAIN_MTR, MARINE_SCIENCE_MAIN_A_MTR, MARINE_SCIENCE_MAIN_B_MTR, MARINE_SCIENCE_MCC_MTR, MILLER_HALL_MAIN_MTR, PHYSICAL_SCIENCE_MAIN_MTR, POST_CHILLER_PLANT_MAIN, POST_MAIN_1, POST_MAIN_2, QUAD_CHILLER_PLANT_MAIN_MTR, SAKAMAKI_HALL_AC_EQPT_MTR, SAKAMAKI_HALL_MAIN_MTR, SAUNDERS_HALL_MAIN_A_MTR, SAUNDERS_HALL_MAIN_B_MTR, SHERMAN_MAIN_1_MTR, SHERMAN_MAIN_2_MTR, ST_JOHN_PLANT_SCIENCE_MAIN_MTR, STAN_SHERIFF_CTR_MAIN_1_MTR, STAN_SHERIFF_CTR_MAIN_2_MTR, WEBSTER_HALL_MAIN_MTR, WIST_HALL_MAIN_MTR|
|AmpsA|AG_ENGINEERING_MAIN_MTR, AG_ENGINEERING_MCC_MTR, AG_SCIENCE_MCC_MTR, ARCHITECTURE_MAIN_MTR, BACHMAN_HALL_MAIN_MTR, BIOMEDICAL_SCIENCE_CH_1_MTR, BIOMEDICAL_SCIENCE_CH_2_MTR, BIOMEDICAL_SCIENCE_MAIN_A_MTR, BIOMEDICAL_SCIENCE_MAIN_B_MTR, BIOMEDICAL_SCIENCE_MCC_A_MTR, BUS_AD_SHIDLER_MAIN_MTR, KOREAN_STUDIES_MAIN_MTR, CRAWFORD_HALL_MAIN_MTR, DEAN_HALL_MAIN_MTR, DKAC_POOL_MAIN_MTR, ENV_PROTECTION_MAIN_MTR, EVERLY_HALL_MAIN_MTR, GEORGE_HALL_MAIN_MTR, GILMORE_HALL_MAIN_A_MTR, GILMORE_HALL_MAIN_B_MTR, GILMORE_HALL_MCC_MTR, HAMILTON_LIB_PH_III_CH_1_MTR, HAMILTON_LIB_PH_III_CH_2_MTR, HAMILTON_LIB_PH_III_CH_3_MTR, HAMILTON_LIB_PH_III_MAIN_1_MTR, HAMILTON_LIB_PH_III_MAIN_2_MTR, HAMILTON_LIB_PH_III_MCC_AC1_MTR, HAMILTON_LIB_PH_III_MCC_AC2_MTR, HAWAII_HALL_MAIN_MTR, HIG_NOAA_MTR, HIG_PANEL_PB_MTR, HIG_PANEL_PBA_MTR, HIG_SUBSTATION_1_MAIN_MTR, HIG_SUBSTATION_2_MAIN_MTR, HIG_SUBSTATION_3_MAIN_MTR, HPER_KLUM_GYM_MTR, HPER_MAIN_MTR, KELLER_HALL_MAIN_MTR, PHYSICAL_SCIENCE_KELLER_COMP_MTR, KENNEDY_THEATRE_MAIN_MTR, KRAUSS_HALL_MAIN_MTR, LAW_LIB_MAIN_MTR, LAW_SCHOOL_MAIN_MTR, LES_MURAKAMI_STADIUM_CONSESS_MTR, LES_MURAKAMI_STADIUM_MAIN_MTR, MARINE_SCIENCE_MAIN_A_MTR, MARINE_SCIENCE_MAIN_B_MTR, MARINE_SCIENCE_MCC_MTR, MILLER_HALL_MAIN_MTR, MOORE_HALL_MAIN_MTR, MUSIC_COMPLEX_MAIN_MTR, PBRC_MAIN_A_MTR, PBRC_MAIN_B_MTR, PHYSICAL_SCIENCE_MAIN_MTR, POST_CHILLER_PLANT_MAIN, POST_MAIN_1, POST_MAIN_2, QLCSS_MAIN_MTR, QUAD_CHILLER_PLANT_MAIN_MTR, SAKAMAKI_HALL_AC_EQPT_MTR, SAKAMAKI_HALL_MAIN_MTR, SAUNDERS_HALL_MAIN_A_MTR, SAUNDERS_HALL_MAIN_B_MTR, SHERMAN_MAIN_1_MTR, SHERMAN_MAIN_2_MTR, SPALDING_HALL_MAIN_MTR, ST_JOHN_PLANT_SCIENCE_MAIN_MTR, STAN_SHERIFF_CTR_MAIN_1_MTR, STAN_SHERIFF_CTR_MAIN_2_MTR, MULTIPURPOSE_BLDG_MAIN_MTR, WEBSTER_HALL_MAIN_MTR, WIST_HALL_MAIN_MTR|
|AmpsB|AG_ENGINEERING_MAIN_MTR, AG_ENGINEERING_MCC_MTR, AG_SCIENCE_MCC_MTR, ARCHITECTURE_MAIN_MTR, BACHMAN_HALL_MAIN_MTR, BIOMEDICAL_SCIENCE_CH_1_MTR, BIOMEDICAL_SCIENCE_CH_2_MTR, BIOMEDICAL_SCIENCE_MAIN_A_MTR, BIOMEDICAL_SCIENCE_MAIN_B_MTR, BIOMEDICAL_SCIENCE_MCC_A_MTR, BUS_AD_SHIDLER_MAIN_MTR, KOREAN_STUDIES_MAIN_MTR, CRAWFORD_HALL_MAIN_MTR, DEAN_HALL_MAIN_MTR, DKAC_POOL_MAIN_MTR, ENV_PROTECTION_MAIN_MTR, EVERLY_HALL_MAIN_MTR, GEORGE_HALL_MAIN_MTR, GILMORE_HALL_MAIN_A_MTR, GILMORE_HALL_MAIN_B_MTR, GILMORE_HALL_MCC_MTR, HAMILTON_LIB_PH_III_CH_1_MTR, HAMILTON_LIB_PH_III_CH_2_MTR, HAMILTON_LIB_PH_III_CH_3_MTR, HAMILTON_LIB_PH_III_MAIN_1_MTR, HAMILTON_LIB_PH_III_MAIN_2_MTR, HAMILTON_LIB_PH_III_MCC_AC1_MTR, HAMILTON_LIB_PH_III_MCC_AC2_MTR, HAWAII_HALL_MAIN_MTR, HIG_NOAA_MTR, HIG_PANEL_PB_MTR, HIG_PANEL_PBA_MTR, HIG_SUBSTATION_1_MAIN_MTR, HIG_SUBSTATION_2_MAIN_MTR, HIG_SUBSTATION_3_MAIN_MTR, HPER_KLUM_GYM_MTR, HPER_MAIN_MTR, KELLER_HALL_MAIN_MTR, PHYSICAL_SCIENCE_KELLER_COMP_MTR, KENNEDY_THEATRE_MAIN_MTR, KRAUSS_HALL_MAIN_MTR, LAW_LIB_MAIN_MTR, LAW_SCHOOL_MAIN_MTR, LES_MURAKAMI_STADIUM_CONSESS_MTR, LES_MURAKAMI_STADIUM_MAIN_MTR, MARINE_SCIENCE_MAIN_A_MTR, MARINE_SCIENCE_MAIN_B_MTR, MARINE_SCIENCE_MCC_MTR, MILLER_HALL_MAIN_MTR, MOORE_HALL_MAIN_MTR, MUSIC_COMPLEX_MAIN_MTR, PBRC_MAIN_A_MTR, PBRC_MAIN_B_MTR, PHYSICAL_SCIENCE_MAIN_MTR, POST_CHILLER_PLANT_MAIN, POST_MAIN_1, POST_MAIN_2, QLCSS_MAIN_MTR, QUAD_CHILLER_PLANT_MAIN_MTR, SAKAMAKI_HALL_AC_EQPT_MTR, SAKAMAKI_HALL_MAIN_MTR, SAUNDERS_HALL_MAIN_A_MTR, SAUNDERS_HALL_MAIN_B_MTR, SHERMAN_MAIN_1_MTR, SHERMAN_MAIN_2_MTR, SPALDING_HALL_MAIN_MTR, ST_JOHN_PLANT_SCIENCE_MAIN_MTR, STAN_SHERIFF_CTR_MAIN_1_MTR, STAN_SHERIFF_CTR_MAIN_2_MTR, MULTIPURPOSE_BLDG_MAIN_MTR, WEBSTER_HALL_MAIN_MTR, WIST_HALL_MAIN_MTR|
|AmpsC|AG_ENGINEERING_MAIN_MTR, AG_ENGINEERING_MCC_MTR, AG_SCIENCE_MCC_MTR, ARCHITECTURE_MAIN_MTR, BACHMAN_HALL_MAIN_MTR, BIOMEDICAL_SCIENCE_CH_1_MTR, BIOMEDICAL_SCIENCE_CH_2_MTR, BIOMEDICAL_SCIENCE_MAIN_A_MTR, BIOMEDICAL_SCIENCE_MAIN_B_MTR, BIOMEDICAL_SCIENCE_MCC_A_MTR, BUS_AD_SHIDLER_MAIN_MTR, KOREAN_STUDIES_MAIN_MTR, CRAWFORD_HALL_MAIN_MTR, DEAN_HALL_MAIN_MTR, DKAC_POOL_MAIN_MTR, ENV_PROTECTION_MAIN_MTR, EVERLY_HALL_MAIN_MTR, GEORGE_HALL_MAIN_MTR, GILMORE_HALL_MAIN_A_MTR, GILMORE_HALL_MAIN_B_MTR, GILMORE_HALL_MCC_MTR, HAMILTON_LIB_PH_III_CH_1_MTR, HAMILTON_LIB_PH_III_CH_2_MTR, HAMILTON_LIB_PH_III_CH_3_MTR, HAMILTON_LIB_PH_III_MAIN_1_MTR, HAMILTON_LIB_PH_III_MAIN_2_MTR, HAMILTON_LIB_PH_III_MCC_AC1_MTR, HAMILTON_LIB_PH_III_MCC_AC2_MTR, HAWAII_HALL_MAIN_MTR, HIG_NOAA_MTR, HIG_PANEL_PB_MTR, HIG_PANEL_PBA_MTR, HIG_SUBSTATION_1_MAIN_MTR, HIG_SUBSTATION_2_MAIN_MTR, HIG_SUBSTATION_3_MAIN_MTR, HPER_KLUM_GYM_MTR, HPER_MAIN_MTR, KELLER_HALL_MAIN_MTR, PHYSICAL_SCIENCE_KELLER_COMP_MTR, KENNEDY_THEATRE_MAIN_MTR, KRAUSS_HALL_MAIN_MTR, LAW_LIB_MAIN_MTR, LAW_SCHOOL_MAIN_MTR, LES_MURAKAMI_STADIUM_CONSESS_MTR, LES_MURAKAMI_STADIUM_MAIN_MTR, MARINE_SCIENCE_MAIN_A_MTR, MARINE_SCIENCE_MAIN_B_MTR, MARINE_SCIENCE_MCC_MTR, MILLER_HALL_MAIN_MTR, MOORE_HALL_MAIN_MTR, MUSIC_COMPLEX_MAIN_MTR, PBRC_MAIN_A_MTR, PBRC_MAIN_B_MTR, PHYSICAL_SCIENCE_MAIN_MTR, POST_CHILLER_PLANT_MAIN, POST_MAIN_1, POST_MAIN_2, QLCSS_MAIN_MTR, QUAD_CHILLER_PLANT_MAIN_MTR, SAKAMAKI_HALL_AC_EQPT_MTR, SAKAMAKI_HALL_MAIN_MTR, SAUNDERS_HALL_MAIN_A_MTR, SAUNDERS_HALL_MAIN_B_MTR, SHERMAN_MAIN_1_MTR, SHERMAN_MAIN_2_MTR, SPALDING_HALL_MAIN_MTR, ST_JOHN_PLANT_SCIENCE_MAIN_MTR, STAN_SHERIFF_CTR_MAIN_1_MTR, STAN_SHERIFF_CTR_MAIN_2_MTR, MULTIPURPOSE_BLDG_MAIN_MTR, WEBSTER_HALL_MAIN_MTR, WIST_HALL_MAIN_MTR|
|BAROMETRIC_PRESSURE|FROG_1_WEATHER_STATION|
|BILGER_ADD_HALL_CHWP_1_STATUS|BILGER_ADD_HALL_CUP|
|BILGER_ADD_HALL_CHWP_2_STATUS|BILGER_ADD_HALL_CUP|
|BILGER_ADD_HALL_CH_1_STATUS|BILGER_ADD_HALL_CUP|
|BILGER_ADD_HALL_CT_1_STATUS|BILGER_ADD_HALL_CUP|
|BILGER_ADD_HALL_CT_2_STATUS|BILGER_ADD_HALL_CUP|
|BILGER_ADD_HALL_CWP_1_STATUS|BILGER_ADD_HALL_CUP|
|BILGER_ADD_HALL_CWP_2_STATUS|BILGER_ADD_HALL_CUP|
|CHWP_1_AMPS|SAUNDERS_HALL_CUP|
|CHWP_1_Amps|AGRICULTURAL_SCIENCE_CUP|
|CHWP_2_AMPS|SAUNDERS_HALL_CUP|
|CHWP_2_Amps|AGRICULTURAL_SCIENCE_CUP|
|CHWR_TEMP|ATHLETICS_COMPLEX_CUP, BIOMEDICAL_SCIENCE_CUP, SHIDLER_COBA_CUP, EDMONSON_HALL_CUP, HAMILTON_LIBRARY_PH_III_CUP, INSTITUTE_FOR_ASTRONOMY_CUP, IT_CENTER_CUP, KUYKENDALL_HALL_CUP, MUSIC_COMPLEX_CUP, QLC_CUP, SAUNDERS_HALL_CUP, STAN_SHERRIFF_CUP, WIST_HALL_EVERLY_HALL_CUP|
|CHWR_Temp|AGRICULTURAL_SCIENCE_CUP, BILGER_ADD_HALL_CUP, GILMORE_HALL_CUP, MARINE_SCIENCE_CUP, SHERMAN_LAB_CUP, ST_JOHN_CUP|
|CHWS_TEMP|ATHLETICS_COMPLEX_CUP, BIOMEDICAL_SCIENCE_CUP, SHIDLER_COBA_CUP, EDMONSON_HALL_CUP, HAMILTON_LIBRARY_PH_III_CUP, INSTITUTE_FOR_ASTRONOMY_CUP, IT_CENTER_CUP, KUYKENDALL_HALL_CUP, MUSIC_COMPLEX_CUP, QLC_CUP, SAUNDERS_HALL_CUP, STAN_SHERRIFF_CUP, WIST_HALL_EVERLY_HALL_CUP|
|CHWS_Temp|AGRICULTURAL_SCIENCE_CUP, BILGER_ADD_HALL_CUP, GILMORE_HALL_CUP, MARINE_SCIENCE_CUP, SHERMAN_LAB_CUP, ST_JOHN_CUP|
|CHW_FLOW|ATHLETICS_COMPLEX_CUP, BIOMEDICAL_SCIENCE_CUP, SHIDLER_COBA_CUP, EDMONSON_HALL_CUP, HAMILTON_LIBRARY_PH_III_CUP, INSTITUTE_FOR_ASTRONOMY_CUP, IT_CENTER_CUP, MUSIC_COMPLEX_CUP, QLC_CUP, SAUNDERS_HALL_CUP, STAN_SHERRIFF_CUP|
|CHW_Flow|AGRICULTURAL_SCIENCE_CUP, BILGER_ADD_HALL_CUP, GILMORE_HALL_CUP, MARINE_SCIENCE_CUP, ST_JOHN_CUP|
|CHW_Flow_Vel|SHERMAN_LAB_CUP|
|CO2|FROG_1_SPACE_ENVIRONMENT, FROG_2_SPACE_ENVIRONMENT|
|COMM_ALARM|AG_ENGINEERING_MCC_MTR, AG_SCIENCE_MCC_MTR, SUBSTATION_L_Q1_MTR, SUBSTATION_L_Q2_MTR, SUBSTATION_L_Q3_MTR|
|CT_1_AMPS|SAUNDERS_HALL_CUP|
|CT_1_Amps|AGRICULTURAL_SCIENCE_CUP, MARINE_SCIENCE_CUP|
|CT_2_AMPS|SAUNDERS_HALL_CUP|
|CT_2_Amps|AGRICULTURAL_SCIENCE_CUP|
|CT_2_Status_Amps|MARINE_SCIENCE_CUP|
|CURRENT_A_THD|ARCHITECTURE_MAIN_MTR, BACHMAN_HALL_MAIN_MTR, BUS_AD_SHIDLER_MAIN_MTR, KOREAN_STUDIES_MAIN_MTR, CRAWFORD_HALL_MAIN_MTR, DKAC_POOL_MAIN_MTR, ENV_PROTECTION_MAIN_MTR, GEORGE_HALL_MAIN_MTR, HAWAII_HALL_MAIN_MTR, HPER_KLUM_GYM_MTR, HPER_MAIN_MTR, KELLER_HALL_MAIN_MTR, PHYSICAL_SCIENCE_KELLER_COMP_MTR, KENNEDY_THEATRE_MAIN_MTR, KRAUSS_HALL_MAIN_MTR, LAW_LIB_MAIN_MTR, LAW_SCHOOL_MAIN_MTR, LES_MURAKAMI_STADIUM_CONSESS_MTR, LES_MURAKAMI_STADIUM_MAIN_MTR, MOORE_HALL_MAIN_MTR, MUSIC_COMPLEX_MAIN_MTR, PBRC_MAIN_A_MTR, PBRC_MAIN_B_MTR, QLCSS_MAIN_MTR, SPALDING_HALL_MAIN_MTR, MULTIPURPOSE_BLDG_MAIN_MTR|
|CURRENT_B_THD|ARCHITECTURE_MAIN_MTR, BACHMAN_HALL_MAIN_MTR, BUS_AD_SHIDLER_MAIN_MTR, KOREAN_STUDIES_MAIN_MTR, CRAWFORD_HALL_MAIN_MTR, DKAC_POOL_MAIN_MTR, ENV_PROTECTION_MAIN_MTR, GEORGE_HALL_MAIN_MTR, HAWAII_HALL_MAIN_MTR, HPER_KLUM_GYM_MTR, HPER_MAIN_MTR, KELLER_HALL_MAIN_MTR, PHYSICAL_SCIENCE_KELLER_COMP_MTR, KENNEDY_THEATRE_MAIN_MTR, KRAUSS_HALL_MAIN_MTR, LAW_LIB_MAIN_MTR, LAW_SCHOOL_MAIN_MTR, LES_MURAKAMI_STADIUM_CONSESS_MTR, LES_MURAKAMI_STADIUM_MAIN_MTR, MOORE_HALL_MAIN_MTR, MUSIC_COMPLEX_MAIN_MTR, PBRC_MAIN_A_MTR, PBRC_MAIN_B_MTR, QLCSS_MAIN_MTR, SPALDING_HALL_MAIN_MTR, MULTIPURPOSE_BLDG_MAIN_MTR|
|CURRENT_C_THD|ARCHITECTURE_MAIN_MTR, BACHMAN_HALL_MAIN_MTR, BUS_AD_SHIDLER_MAIN_MTR, KOREAN_STUDIES_MAIN_MTR, CRAWFORD_HALL_MAIN_MTR, DKAC_POOL_MAIN_MTR, ENV_PROTECTION_MAIN_MTR, GEORGE_HALL_MAIN_MTR, HAWAII_HALL_MAIN_MTR, HPER_KLUM_GYM_MTR, HPER_MAIN_MTR, KELLER_HALL_MAIN_MTR, PHYSICAL_SCIENCE_KELLER_COMP_MTR, KENNEDY_THEATRE_MAIN_MTR, KRAUSS_HALL_MAIN_MTR, LAW_LIB_MAIN_MTR, LAW_SCHOOL_MAIN_MTR, LES_MURAKAMI_STADIUM_CONSESS_MTR, LES_MURAKAMI_STADIUM_MAIN_MTR, MOORE_HALL_MAIN_MTR, MUSIC_COMPLEX_MAIN_MTR, PBRC_MAIN_A_MTR, PBRC_MAIN_B_MTR, QLCSS_MAIN_MTR, SPALDING_HALL_MAIN_MTR, MULTIPURPOSE_BLDG_MAIN_MTR|
|CWP_1_AMPS|SAUNDERS_HALL_CUP|
|CWP_1_Amps|AGRICULTURAL_SCIENCE_CUP, MARINE_SCIENCE_CUP|
|CWP_2_AMPS|SAUNDERS_HALL_CUP|
|CWP_2_Amps|AGRICULTURAL_SCIENCE_CUP, MARINE_SCIENCE_CUP|
|DEWPOINT|FROG_1_WEATHER_STATION|
|DUCT_RETURN_HUMIDITY|FROG_1_AHU, FROG_2_AHU|
|DUCT_RETURN_TEMP|FROG_1_AHU, FROG_2_AHU|
|DUCT_SUPPLY_HUMIDITY|FROG_1_AHU, FROG_2_AHU|
|DUCT_SUPPLY_TEMP|FROG_1_AHU, FROG_2_AHU|
|EVENT_NUMBER|HIG_SUBSTATION_1_MAIN_MTR|
|EVERLY_HALL_FLOW|WIST_HALL_EVERLY_HALL_CUP|
|FLAG_1_ALARM_STATUS|HIG_SUBSTATION_1_MAIN_MTR|
|FLAG_2_ALARM_STATUS|HIG_SUBSTATION_1_MAIN_MTR|
|Frequency|AG_ENGINEERING_MAIN_MTR, AG_ENGINEERING_MCC_MTR, AG_SCIENCE_MCC_MTR, ARCHITECTURE_MAIN_MTR, BACHMAN_HALL_MAIN_MTR, BIOMEDICAL_SCIENCE_CH_1_MTR, BIOMEDICAL_SCIENCE_CH_2_MTR, BIOMEDICAL_SCIENCE_MAIN_A_MTR, BIOMEDICAL_SCIENCE_MAIN_B_MTR, BIOMEDICAL_SCIENCE_MCC_A_MTR, BUS_AD_SHIDLER_MAIN_MTR, KOREAN_STUDIES_MAIN_MTR, CRAWFORD_HALL_MAIN_MTR, DEAN_HALL_MAIN_MTR, DKAC_POOL_MAIN_MTR, ENV_PROTECTION_MAIN_MTR, EVERLY_HALL_MAIN_MTR, GEORGE_HALL_MAIN_MTR, GILMORE_HALL_MAIN_A_MTR, GILMORE_HALL_MAIN_B_MTR, GILMORE_HALL_MCC_MTR, HAMILTON_LIB_PH_III_CH_1_MTR, HAMILTON_LIB_PH_III_CH_2_MTR, HAMILTON_LIB_PH_III_CH_3_MTR, HAMILTON_LIB_PH_III_MAIN_1_MTR, HAMILTON_LIB_PH_III_MAIN_2_MTR, HAMILTON_LIB_PH_III_MCC_AC1_MTR, HAMILTON_LIB_PH_III_MCC_AC2_MTR, HAWAII_HALL_MAIN_MTR, HIG_NOAA_MTR, HIG_PANEL_PB_MTR, HIG_PANEL_PBA_MTR, HIG_SUBSTATION_1_MAIN_MTR, HIG_SUBSTATION_2_MAIN_MTR, HIG_SUBSTATION_3_MAIN_MTR, HPER_KLUM_GYM_MTR, HPER_MAIN_MTR, KELLER_HALL_MAIN_MTR, PHYSICAL_SCIENCE_KELLER_COMP_MTR, KENNEDY_THEATRE_MAIN_MTR, KRAUSS_HALL_MAIN_MTR, LAW_LIB_MAIN_MTR, LAW_SCHOOL_MAIN_MTR, LES_MURAKAMI_STADIUM_CONSESS_MTR, LES_MURAKAMI_STADIUM_MAIN_MTR, MARINE_SCIENCE_MAIN_A_MTR, MARINE_SCIENCE_MAIN_B_MTR, MARINE_SCIENCE_MCC_MTR, MILLER_HALL_MAIN_MTR, MOORE_HALL_MAIN_MTR, MUSIC_COMPLEX_MAIN_MTR, PBRC_MAIN_A_MTR, PBRC_MAIN_B_MTR, PHYSICAL_SCIENCE_MAIN_MTR, POST_CHILLER_PLANT_MAIN, POST_MAIN_1, POST_MAIN_2, QLCSS_MAIN_MTR, QUAD_CHILLER_PLANT_MAIN_MTR, SAKAMAKI_HALL_AC_EQPT_MTR, SAKAMAKI_HALL_MAIN_MTR, SAUNDERS_HALL_MAIN_A_MTR, SAUNDERS_HALL_MAIN_B_MTR, SHERMAN_MAIN_1_MTR, SHERMAN_MAIN_2_MTR, SPALDING_HALL_MAIN_MTR, ST_JOHN_PLANT_SCIENCE_MAIN_MTR, STAN_SHERIFF_CTR_MAIN_1_MTR, STAN_SHERIFF_CTR_MAIN_2_MTR, MULTIPURPOSE_BLDG_MAIN_MTR, WARRIOR_CENTER_INV0, WARRIOR_CENTER_INV1, WEBSTER_HALL_MAIN_MTR, WIST_HALL_MAIN_MTR|
|GENERAL_ALARM_STATUS|HIG_SUBSTATION_1_MAIN_MTR|
|GILMORE_HALL_CHWP_1_STATUS|GILMORE_HALL_CUP|
|GILMORE_HALL_CHWP_2_STATUS|GILMORE_HALL_CUP|
|GILMORE_HALL_CH_1_STATUS|GILMORE_HALL_CUP|
|GILMORE_HALL_CH_2_STATUS|GILMORE_HALL_CUP|
|GILMORE_HALL_CT_1_STATUS|GILMORE_HALL_CUP|
|GILMORE_HALL_CT_2_STATUS|GILMORE_HALL_CUP|
|GILMORE_HALL_CWP_1_STATUS|GILMORE_HALL_CUP|
|GILMORE_HALL_CWP_2_STATUS|GILMORE_HALL_CUP|
|HUMIDITY|FROG_1_WEATHER_STATION|
|KWH|FROG_1_AHU, FROG_1_BLDG_SERVICES, FROG_1_CEILING_FANS, FROG_1_CHILLER, FROG_1_EXTERIOR_LIGHTS, FROG_1_FIRE_ALARM, FROG_1_LUTRON_LIGHTS, FROG_1_SERVICE_LIGHTS, FROG_1_SOLAR_1, FROG_1_SOLAR_2, FROG_1_WHOLE_BLDG, FROG_1_WINDOW_ACTUATORS, FROG_2_AHU, FROG_2_BLDG_SERVICES, FROG_2_CEILING_FANS, FROG_2_CHILLER, FROG_2_EXTERIOR_LIGHTS, FROG_2_FIRE_ALARM, FROG_2_LUTRON_LIGHTS, FROG_2_SERVICE_LIGHTS, FROG_2_SOLAR_1, FROG_2_SOLAR_2, FROG_2_WHOLE_BLDG, FROG_2_WINDOW_ACTUATORS, PBRC_SATCON_GEN_2, SUBSTATION_L_BLDG_KEY_PERF_IND, SUBSTATION_L_Q1_MTR, SUBSTATION_L_Q2_MTR, SUBSTATION_L_Q3_MTR, WARRIOR_CENTER_INV0, WARRIOR_CENTER_INV1, WARRIOR_CENTER_INV2, WARRIOR_CENTER_INV3|
|KW_AVERAGE|FROG_1_AHU, FROG_1_BLDG_SERVICES, FROG_1_CEILING_FANS, FROG_1_CHILLER, FROG_1_EXTERIOR_LIGHTS, FROG_1_FIRE_ALARM, FROG_1_LUTRON_LIGHTS, FROG_1_SERVICE_LIGHTS, FROG_1_SOLAR_1, FROG_1_SOLAR_2, FROG_1_WHOLE_BLDG, FROG_1_WINDOW_ACTUATORS, FROG_2_AHU, FROG_2_BLDG_SERVICES, FROG_2_CEILING_FANS, FROG_2_CHILLER, FROG_2_EXTERIOR_LIGHTS, FROG_2_FIRE_ALARM, FROG_2_LUTRON_LIGHTS, FROG_2_SERVICE_LIGHTS, FROG_2_SOLAR_1, FROG_2_SOLAR_2, FROG_2_WHOLE_BLDG, FROG_2_WINDOW_ACTUATORS|
|MARINE_SCIENCE_CHWP_1_STATUS|MARINE_SCIENCE_CUP|
|MARINE_SCIENCE_CHWP_2_STATUS|MARINE_SCIENCE_CUP|
|MARINE_SCIENCE_CH_1_STATUS|MARINE_SCIENCE_CUP|
|MARINE_SCIENCE_CH_2_STATUS|MARINE_SCIENCE_CUP|
|PCHWR_Temp|POST_CUP|
|PCHWS_Temp|POST_CUP|
|PHASE_A_CF|AG_ENGINEERING_MAIN_MTR, AG_ENGINEERING_MCC_MTR, AG_SCIENCE_MCC_MTR, BIOMEDICAL_SCIENCE_CH_1_MTR, BIOMEDICAL_SCIENCE_CH_2_MTR, BIOMEDICAL_SCIENCE_MAIN_A_MTR, BIOMEDICAL_SCIENCE_MAIN_B_MTR, BIOMEDICAL_SCIENCE_MCC_A_MTR, DEAN_HALL_MAIN_MTR, EVERLY_HALL_MAIN_MTR, GILMORE_HALL_MAIN_A_MTR, GILMORE_HALL_MAIN_B_MTR, GILMORE_HALL_MCC_MTR, HAMILTON_LIB_PH_III_CH_1_MTR, HAMILTON_LIB_PH_III_CH_2_MTR, HAMILTON_LIB_PH_III_CH_3_MTR, HAMILTON_LIB_PH_III_MAIN_1_MTR, HAMILTON_LIB_PH_III_MAIN_2_MTR, HAMILTON_LIB_PH_III_MCC_AC1_MTR, HAMILTON_LIB_PH_III_MCC_AC2_MTR, HIG_NOAA_MTR, HIG_PANEL_PB_MTR, HIG_PANEL_PBA_MTR, HIG_SUBSTATION_1_MAIN_MTR, HIG_SUBSTATION_2_MAIN_MTR, HIG_SUBSTATION_3_MAIN_MTR, MARINE_SCIENCE_MAIN_A_MTR, MARINE_SCIENCE_MAIN_B_MTR, MARINE_SCIENCE_MCC_MTR, MILLER_HALL_MAIN_MTR, PHYSICAL_SCIENCE_MAIN_MTR, POST_CHILLER_PLANT_MAIN, POST_MAIN_1, POST_MAIN_2, QUAD_CHILLER_PLANT_MAIN_MTR, SAKAMAKI_HALL_AC_EQPT_MTR, SAKAMAKI_HALL_MAIN_MTR, SAUNDERS_HALL_MAIN_A_MTR, SAUNDERS_HALL_MAIN_B_MTR, SHERMAN_MAIN_1_MTR, SHERMAN_MAIN_2_MTR, ST_JOHN_PLANT_SCIENCE_MAIN_MTR, STAN_SHERIFF_CTR_MAIN_1_MTR, STAN_SHERIFF_CTR_MAIN_2_MTR, WEBSTER_HALL_MAIN_MTR, WIST_HALL_MAIN_MTR|
|PHASE_A_TX_THDF|AG_ENGINEERING_MAIN_MTR, AG_ENGINEERING_MCC_MTR, AG_SCIENCE_MCC_MTR, BIOMEDICAL_SCIENCE_CH_1_MTR, BIOMEDICAL_SCIENCE_CH_2_MTR, BIOMEDICAL_SCIENCE_MAIN_A_MTR, BIOMEDICAL_SCIENCE_MAIN_B_MTR, BIOMEDICAL_SCIENCE_MCC_A_MTR, DEAN_HALL_MAIN_MTR, EVERLY_HALL_MAIN_MTR, GILMORE_HALL_MAIN_A_MTR, GILMORE_HALL_MAIN_B_MTR, GILMORE_HALL_MCC_MTR, HAMILTON_LIB_PH_III_CH_1_MTR, HAMILTON_LIB_PH_III_CH_2_MTR, HAMILTON_LIB_PH_III_CH_3_MTR, HAMILTON_LIB_PH_III_MAIN_1_MTR, HAMILTON_LIB_PH_III_MAIN_2_MTR, HAMILTON_LIB_PH_III_MCC_AC1_MTR, HAMILTON_LIB_PH_III_MCC_AC2_MTR, HIG_NOAA_MTR, HIG_PANEL_PB_MTR, HIG_PANEL_PBA_MTR, HIG_SUBSTATION_1_MAIN_MTR, HIG_SUBSTATION_2_MAIN_MTR, HIG_SUBSTATION_3_MAIN_MTR, MARINE_SCIENCE_MAIN_A_MTR, MARINE_SCIENCE_MAIN_B_MTR, MARINE_SCIENCE_MCC_MTR, MILLER_HALL_MAIN_MTR, PHYSICAL_SCIENCE_MAIN_MTR, POST_CHILLER_PLANT_MAIN, POST_MAIN_1, POST_MAIN_2, QUAD_CHILLER_PLANT_MAIN_MTR, SAKAMAKI_HALL_AC_EQPT_MTR, SAKAMAKI_HALL_MAIN_MTR, SAUNDERS_HALL_MAIN_A_MTR, SAUNDERS_HALL_MAIN_B_MTR, SHERMAN_MAIN_1_MTR, SHERMAN_MAIN_2_MTR, ST_JOHN_PLANT_SCIENCE_MAIN_MTR, STAN_SHERIFF_CTR_MAIN_1_MTR, STAN_SHERIFF_CTR_MAIN_2_MTR, WEBSTER_HALL_MAIN_MTR, WIST_HALL_MAIN_MTR|
|PHASE_B_CF|AG_ENGINEERING_MAIN_MTR, AG_ENGINEERING_MCC_MTR, AG_SCIENCE_MCC_MTR, BIOMEDICAL_SCIENCE_CH_1_MTR, BIOMEDICAL_SCIENCE_CH_2_MTR, BIOMEDICAL_SCIENCE_MAIN_A_MTR, BIOMEDICAL_SCIENCE_MAIN_B_MTR, BIOMEDICAL_SCIENCE_MCC_A_MTR, DEAN_HALL_MAIN_MTR, EVERLY_HALL_MAIN_MTR, GILMORE_HALL_MAIN_A_MTR, GILMORE_HALL_MAIN_B_MTR, GILMORE_HALL_MCC_MTR, HAMILTON_LIB_PH_III_CH_1_MTR, HAMILTON_LIB_PH_III_CH_2_MTR, HAMILTON_LIB_PH_III_CH_3_MTR, HAMILTON_LIB_PH_III_MAIN_1_MTR, HAMILTON_LIB_PH_III_MAIN_2_MTR, HAMILTON_LIB_PH_III_MCC_AC1_MTR, HAMILTON_LIB_PH_III_MCC_AC2_MTR, HIG_NOAA_MTR, HIG_PANEL_PB_MTR, HIG_PANEL_PBA_MTR, HIG_SUBSTATION_1_MAIN_MTR, HIG_SUBSTATION_2_MAIN_MTR, HIG_SUBSTATION_3_MAIN_MTR, MARINE_SCIENCE_MAIN_A_MTR, MARINE_SCIENCE_MAIN_B_MTR, MARINE_SCIENCE_MCC_MTR, MILLER_HALL_MAIN_MTR, PHYSICAL_SCIENCE_MAIN_MTR, POST_CHILLER_PLANT_MAIN, POST_MAIN_1, POST_MAIN_2, QUAD_CHILLER_PLANT_MAIN_MTR, SAKAMAKI_HALL_AC_EQPT_MTR, SAKAMAKI_HALL_MAIN_MTR, SAUNDERS_HALL_MAIN_A_MTR, SAUNDERS_HALL_MAIN_B_MTR, SHERMAN_MAIN_1_MTR, SHERMAN_MAIN_2_MTR, ST_JOHN_PLANT_SCIENCE_MAIN_MTR, STAN_SHERIFF_CTR_MAIN_1_MTR, STAN_SHERIFF_CTR_MAIN_2_MTR, WEBSTER_HALL_MAIN_MTR, WIST_HALL_MAIN_MTR|
|PHASE_B_TX_THDF|AG_ENGINEERING_MAIN_MTR, AG_ENGINEERING_MCC_MTR, AG_SCIENCE_MCC_MTR, BIOMEDICAL_SCIENCE_CH_1_MTR, BIOMEDICAL_SCIENCE_CH_2_MTR, BIOMEDICAL_SCIENCE_MAIN_A_MTR, BIOMEDICAL_SCIENCE_MAIN_B_MTR, BIOMEDICAL_SCIENCE_MCC_A_MTR, DEAN_HALL_MAIN_MTR, EVERLY_HALL_MAIN_MTR, GILMORE_HALL_MAIN_A_MTR, GILMORE_HALL_MAIN_B_MTR, GILMORE_HALL_MCC_MTR, HAMILTON_LIB_PH_III_CH_1_MTR, HAMILTON_LIB_PH_III_CH_2_MTR, HAMILTON_LIB_PH_III_CH_3_MTR, HAMILTON_LIB_PH_III_MAIN_1_MTR, HAMILTON_LIB_PH_III_MAIN_2_MTR, HAMILTON_LIB_PH_III_MCC_AC1_MTR, HAMILTON_LIB_PH_III_MCC_AC2_MTR, HIG_NOAA_MTR, HIG_PANEL_PB_MTR, HIG_PANEL_PBA_MTR, HIG_SUBSTATION_1_MAIN_MTR, HIG_SUBSTATION_2_MAIN_MTR, HIG_SUBSTATION_3_MAIN_MTR, MARINE_SCIENCE_MAIN_A_MTR, MARINE_SCIENCE_MAIN_B_MTR, MARINE_SCIENCE_MCC_MTR, MILLER_HALL_MAIN_MTR, PHYSICAL_SCIENCE_MAIN_MTR, POST_CHILLER_PLANT_MAIN, POST_MAIN_1, POST_MAIN_2, QUAD_CHILLER_PLANT_MAIN_MTR, SAKAMAKI_HALL_AC_EQPT_MTR, SAKAMAKI_HALL_MAIN_MTR, SAUNDERS_HALL_MAIN_A_MTR, SAUNDERS_HALL_MAIN_B_MTR, SHERMAN_MAIN_1_MTR, SHERMAN_MAIN_2_MTR, ST_JOHN_PLANT_SCIENCE_MAIN_MTR, STAN_SHERIFF_CTR_MAIN_1_MTR, STAN_SHERIFF_CTR_MAIN_2_MTR, WEBSTER_HALL_MAIN_MTR, WIST_HALL_MAIN_MTR|
|PHASE_C_CF|AG_ENGINEERING_MAIN_MTR, AG_ENGINEERING_MCC_MTR, AG_SCIENCE_MCC_MTR, BIOMEDICAL_SCIENCE_CH_1_MTR, BIOMEDICAL_SCIENCE_CH_2_MTR, BIOMEDICAL_SCIENCE_MAIN_A_MTR, BIOMEDICAL_SCIENCE_MAIN_B_MTR, BIOMEDICAL_SCIENCE_MCC_A_MTR, DEAN_HALL_MAIN_MTR, EVERLY_HALL_MAIN_MTR, GILMORE_HALL_MAIN_A_MTR, GILMORE_HALL_MAIN_B_MTR, GILMORE_HALL_MCC_MTR, HAMILTON_LIB_PH_III_CH_1_MTR, HAMILTON_LIB_PH_III_CH_2_MTR, HAMILTON_LIB_PH_III_CH_3_MTR, HAMILTON_LIB_PH_III_MAIN_1_MTR, HAMILTON_LIB_PH_III_MAIN_2_MTR, HAMILTON_LIB_PH_III_MCC_AC1_MTR, HAMILTON_LIB_PH_III_MCC_AC2_MTR, HIG_NOAA_MTR, HIG_PANEL_PB_MTR, HIG_PANEL_PBA_MTR, HIG_SUBSTATION_1_MAIN_MTR, HIG_SUBSTATION_2_MAIN_MTR, HIG_SUBSTATION_3_MAIN_MTR, MARINE_SCIENCE_MAIN_A_MTR, MARINE_SCIENCE_MAIN_B_MTR, MARINE_SCIENCE_MCC_MTR, MILLER_HALL_MAIN_MTR, PHYSICAL_SCIENCE_MAIN_MTR, POST_CHILLER_PLANT_MAIN, POST_MAIN_1, POST_MAIN_2, QUAD_CHILLER_PLANT_MAIN_MTR, SAKAMAKI_HALL_AC_EQPT_MTR, SAKAMAKI_HALL_MAIN_MTR, SAUNDERS_HALL_MAIN_A_MTR, SAUNDERS_HALL_MAIN_B_MTR, SHERMAN_MAIN_1_MTR, SHERMAN_MAIN_2_MTR, ST_JOHN_PLANT_SCIENCE_MAIN_MTR, STAN_SHERIFF_CTR_MAIN_1_MTR, STAN_SHERIFF_CTR_MAIN_2_MTR, WEBSTER_HALL_MAIN_MTR, WIST_HALL_MAIN_MTR|
|PHASE_C_TX_THDF|AG_ENGINEERING_MAIN_MTR, AG_ENGINEERING_MCC_MTR, AG_SCIENCE_MCC_MTR, BIOMEDICAL_SCIENCE_CH_1_MTR, BIOMEDICAL_SCIENCE_CH_2_MTR, BIOMEDICAL_SCIENCE_MAIN_A_MTR, BIOMEDICAL_SCIENCE_MAIN_B_MTR, BIOMEDICAL_SCIENCE_MCC_A_MTR, DEAN_HALL_MAIN_MTR, EVERLY_HALL_MAIN_MTR, GILMORE_HALL_MAIN_A_MTR, GILMORE_HALL_MAIN_B_MTR, GILMORE_HALL_MCC_MTR, HAMILTON_LIB_PH_III_CH_1_MTR, HAMILTON_LIB_PH_III_CH_2_MTR, HAMILTON_LIB_PH_III_CH_3_MTR, HAMILTON_LIB_PH_III_MAIN_1_MTR, HAMILTON_LIB_PH_III_MAIN_2_MTR, HAMILTON_LIB_PH_III_MCC_AC1_MTR, HAMILTON_LIB_PH_III_MCC_AC2_MTR, HIG_NOAA_MTR, HIG_PANEL_PB_MTR, HIG_PANEL_PBA_MTR, HIG_SUBSTATION_1_MAIN_MTR, HIG_SUBSTATION_2_MAIN_MTR, HIG_SUBSTATION_3_MAIN_MTR, MARINE_SCIENCE_MAIN_A_MTR, MARINE_SCIENCE_MAIN_B_MTR, MARINE_SCIENCE_MCC_MTR, MILLER_HALL_MAIN_MTR, PHYSICAL_SCIENCE_MAIN_MTR, POST_CHILLER_PLANT_MAIN, POST_MAIN_1, POST_MAIN_2, QUAD_CHILLER_PLANT_MAIN_MTR, SAKAMAKI_HALL_AC_EQPT_MTR, SAKAMAKI_HALL_MAIN_MTR, SAUNDERS_HALL_MAIN_A_MTR, SAUNDERS_HALL_MAIN_B_MTR, SHERMAN_MAIN_1_MTR, SHERMAN_MAIN_2_MTR, ST_JOHN_PLANT_SCIENCE_MAIN_MTR, STAN_SHERIFF_CTR_MAIN_1_MTR, STAN_SHERIFF_CTR_MAIN_2_MTR, WEBSTER_HALL_MAIN_MTR, WIST_HALL_MAIN_MTR|
|POST_CHWP_1_STATUS|POST_CUP|
|POST_CHWP_2_STATUS|POST_CUP|
|POST_CHWP_3_STATUS|POST_CUP|
|POST_CH_1_STATUS|POST_CUP|
|POST_CH_2_STATUS|POST_CUP|
|POST_CT_1_STATUS|POST_CUP|
|POST_CT_2_STATUS|POST_CUP|
|POST_CT_3_STATUS|POST_CUP|
|POST_CWP_1_STATUS|POST_CUP|
|POST_CWP_2_STATUS|POST_CUP|
|POST_CWP_3_STATUS|POST_CUP|
|POST_SCHWP_1_STATUS|POST_CUP|
|POST_SCHWP_2_STATUS|POST_CUP|
|POST_SCHWP_3_STATUS|POST_CUP|
|PowerFactor|AG_ENGINEERING_MAIN_MTR, AG_ENGINEERING_MCC_MTR, AG_SCIENCE_MCC_MTR, ARCHITECTURE_MAIN_MTR, BACHMAN_HALL_MAIN_MTR, BIOMEDICAL_SCIENCE_CH_1_MTR, BIOMEDICAL_SCIENCE_CH_2_MTR, BIOMEDICAL_SCIENCE_MAIN_A_MTR, BIOMEDICAL_SCIENCE_MAIN_B_MTR, BIOMEDICAL_SCIENCE_MCC_A_MTR, BUS_AD_SHIDLER_MAIN_MTR, KOREAN_STUDIES_MAIN_MTR, CRAWFORD_HALL_MAIN_MTR, DEAN_HALL_MAIN_MTR, DKAC_POOL_MAIN_MTR, ENV_PROTECTION_MAIN_MTR, EVERLY_HALL_MAIN_MTR, GEORGE_HALL_MAIN_MTR, GILMORE_HALL_MAIN_A_MTR, GILMORE_HALL_MAIN_B_MTR, GILMORE_HALL_MCC_MTR, HAMILTON_LIB_PH_III_CH_1_MTR, HAMILTON_LIB_PH_III_CH_2_MTR, HAMILTON_LIB_PH_III_CH_3_MTR, HAMILTON_LIB_PH_III_MAIN_1_MTR, HAMILTON_LIB_PH_III_MAIN_2_MTR, HAMILTON_LIB_PH_III_MCC_AC1_MTR, HAMILTON_LIB_PH_III_MCC_AC2_MTR, HAWAII_HALL_MAIN_MTR, HIG_NOAA_MTR, HIG_PANEL_PB_MTR, HIG_PANEL_PBA_MTR, HIG_SUBSTATION_1_MAIN_MTR, HIG_SUBSTATION_2_MAIN_MTR, HIG_SUBSTATION_3_MAIN_MTR, HPER_KLUM_GYM_MTR, HPER_MAIN_MTR, KELLER_HALL_MAIN_MTR, PHYSICAL_SCIENCE_KELLER_COMP_MTR, KENNEDY_THEATRE_MAIN_MTR, KRAUSS_HALL_MAIN_MTR, LAW_LIB_MAIN_MTR, LAW_SCHOOL_MAIN_MTR, LES_MURAKAMI_STADIUM_CONSESS_MTR, LES_MURAKAMI_STADIUM_MAIN_MTR, MARINE_SCIENCE_MAIN_A_MTR, MARINE_SCIENCE_MAIN_B_MTR, MARINE_SCIENCE_MCC_MTR, MILLER_HALL_MAIN_MTR, MOORE_HALL_MAIN_MTR, MUSIC_COMPLEX_MAIN_MTR, PBRC_MAIN_A_MTR, PBRC_MAIN_B_MTR, PHYSICAL_SCIENCE_MAIN_MTR, POST_CHILLER_PLANT_MAIN, POST_MAIN_1, POST_MAIN_2, QLCSS_MAIN_MTR, QUAD_CHILLER_PLANT_MAIN_MTR, SAKAMAKI_HALL_AC_EQPT_MTR, SAKAMAKI_HALL_MAIN_MTR, SAUNDERS_HALL_MAIN_A_MTR, SAUNDERS_HALL_MAIN_B_MTR, SHERMAN_MAIN_1_MTR, SHERMAN_MAIN_2_MTR, SPALDING_HALL_MAIN_MTR, ST_JOHN_PLANT_SCIENCE_MAIN_MTR, STAN_SHERIFF_CTR_MAIN_1_MTR, STAN_SHERIFF_CTR_MAIN_2_MTR, MULTIPURPOSE_BLDG_MAIN_MTR, WEBSTER_HALL_MAIN_MTR, WIST_HALL_MAIN_MTR|
|RISER_1_CHWR_TEMP|MOORE_HALL_CUP|
|RISER_1_CHWS_TEMP|MOORE_HALL_CUP|
|RISER_1_CHW_FLOW|MOORE_HALL_CUP|
|RISER_2_CHWR_TEMP|MOORE_HALL_CUP|
|RISER_2_CHWS_TEMP|MOORE_HALL_CUP|
|RISER_2_CHW_FLOW|MOORE_HALL_CUP|
|SAUNDERS_HALL_CH_1_STATUS|SAUNDERS_HALL_CUP|
|SAUNDERS_HALL_CH_2_STATUS|SAUNDERS_HALL_CUP|
|SERIAL_NO|ARCHITECTURE_MAIN_MTR|
|SOLAR_RADIATION|FROG_1_WEATHER_STATION|
|TEMP_DRY_BULB|FROG_1_WEATHER_STATION|
|TOTAL_HEAT|ATHLETICS_COMPLEX_CUP, BILGER_ADD_HALL_CUP, BIOMEDICAL_SCIENCE_CUP, SHIDLER_COBA_CUP, EDMONSON_HALL_CUP, GILMORE_HALL_CUP, HAMILTON_LIBRARY_PH_III_CUP, INSTITUTE_FOR_ASTRONOMY_CUP, IT_CENTER_CUP, MARINE_SCIENCE_CUP, MOORE_HALL_CUP, MUSIC_COMPLEX_CUP, QLC_CUP, SAUNDERS_HALL_CUP, ST_JOHN_CUP, STAN_SHERRIFF_CUP, WIST_HALL_EVERLY_HALL_CUP|
|VAB|AG_ENGINEERING_MAIN_MTR, AG_ENGINEERING_MCC_MTR, AG_SCIENCE_MCC_MTR, ARCHITECTURE_MAIN_MTR, BACHMAN_HALL_MAIN_MTR, BIOMEDICAL_SCIENCE_CH_1_MTR, BIOMEDICAL_SCIENCE_CH_2_MTR, BIOMEDICAL_SCIENCE_MAIN_A_MTR, BIOMEDICAL_SCIENCE_MAIN_B_MTR, BIOMEDICAL_SCIENCE_MCC_A_MTR, BUS_AD_SHIDLER_MAIN_MTR, KOREAN_STUDIES_MAIN_MTR, CRAWFORD_HALL_MAIN_MTR, DEAN_HALL_MAIN_MTR, DKAC_POOL_MAIN_MTR, ENV_PROTECTION_MAIN_MTR, EVERLY_HALL_MAIN_MTR, GEORGE_HALL_MAIN_MTR, GILMORE_HALL_MAIN_A_MTR, GILMORE_HALL_MAIN_B_MTR, GILMORE_HALL_MCC_MTR, HAMILTON_LIB_PH_III_CH_1_MTR, HAMILTON_LIB_PH_III_CH_2_MTR, HAMILTON_LIB_PH_III_CH_3_MTR, HAMILTON_LIB_PH_III_MAIN_1_MTR, HAMILTON_LIB_PH_III_MAIN_2_MTR, HAMILTON_LIB_PH_III_MCC_AC1_MTR, HAMILTON_LIB_PH_III_MCC_AC2_MTR, HAWAII_HALL_MAIN_MTR, HIG_NOAA_MTR, HIG_PANEL_PB_MTR, HIG_PANEL_PBA_MTR, HIG_SUBSTATION_1_MAIN_MTR, HIG_SUBSTATION_2_MAIN_MTR, HIG_SUBSTATION_3_MAIN_MTR, HPER_KLUM_GYM_MTR, HPER_MAIN_MTR, KELLER_HALL_MAIN_MTR, PHYSICAL_SCIENCE_KELLER_COMP_MTR, KENNEDY_THEATRE_MAIN_MTR, KRAUSS_HALL_MAIN_MTR, LAW_LIB_MAIN_MTR, LAW_SCHOOL_MAIN_MTR, LES_MURAKAMI_STADIUM_CONSESS_MTR, LES_MURAKAMI_STADIUM_MAIN_MTR, MARINE_SCIENCE_MAIN_A_MTR, MARINE_SCIENCE_MAIN_B_MTR, MARINE_SCIENCE_MCC_MTR, MILLER_HALL_MAIN_MTR, MOORE_HALL_MAIN_MTR, MUSIC_COMPLEX_MAIN_MTR, PBRC_MAIN_A_MTR, PBRC_MAIN_B_MTR, PHYSICAL_SCIENCE_MAIN_MTR, POST_CHILLER_PLANT_MAIN, POST_MAIN_1, POST_MAIN_2, QLCSS_MAIN_MTR, QUAD_CHILLER_PLANT_MAIN_MTR, SAKAMAKI_HALL_AC_EQPT_MTR, SAKAMAKI_HALL_MAIN_MTR, SAUNDERS_HALL_MAIN_A_MTR, SAUNDERS_HALL_MAIN_B_MTR, SHERMAN_MAIN_1_MTR, SHERMAN_MAIN_2_MTR, SPALDING_HALL_MAIN_MTR, ST_JOHN_PLANT_SCIENCE_MAIN_MTR, STAN_SHERIFF_CTR_MAIN_1_MTR, STAN_SHERIFF_CTR_MAIN_2_MTR, MULTIPURPOSE_BLDG_MAIN_MTR, WEBSTER_HALL_MAIN_MTR, WIST_HALL_MAIN_MTR|
|VAN|AG_ENGINEERING_MAIN_MTR, AG_ENGINEERING_MCC_MTR, AG_SCIENCE_MCC_MTR, ARCHITECTURE_MAIN_MTR, BACHMAN_HALL_MAIN_MTR, BIOMEDICAL_SCIENCE_CH_1_MTR, BIOMEDICAL_SCIENCE_CH_2_MTR, BIOMEDICAL_SCIENCE_MAIN_A_MTR, BIOMEDICAL_SCIENCE_MAIN_B_MTR, BIOMEDICAL_SCIENCE_MCC_A_MTR, BUS_AD_SHIDLER_MAIN_MTR, KOREAN_STUDIES_MAIN_MTR, CRAWFORD_HALL_MAIN_MTR, DEAN_HALL_MAIN_MTR, DKAC_POOL_MAIN_MTR, ENV_PROTECTION_MAIN_MTR, EVERLY_HALL_MAIN_MTR, GEORGE_HALL_MAIN_MTR, GILMORE_HALL_MAIN_A_MTR, GILMORE_HALL_MAIN_B_MTR, GILMORE_HALL_MCC_MTR, HAMILTON_LIB_PH_III_CH_1_MTR, HAMILTON_LIB_PH_III_CH_2_MTR, HAMILTON_LIB_PH_III_CH_3_MTR, HAMILTON_LIB_PH_III_MAIN_1_MTR, HAMILTON_LIB_PH_III_MAIN_2_MTR, HAMILTON_LIB_PH_III_MCC_AC1_MTR, HAMILTON_LIB_PH_III_MCC_AC2_MTR, HAWAII_HALL_MAIN_MTR, HIG_NOAA_MTR, HIG_PANEL_PB_MTR, HIG_PANEL_PBA_MTR, HIG_SUBSTATION_1_MAIN_MTR, HIG_SUBSTATION_2_MAIN_MTR, HIG_SUBSTATION_3_MAIN_MTR, HPER_KLUM_GYM_MTR, HPER_MAIN_MTR, KELLER_HALL_MAIN_MTR, PHYSICAL_SCIENCE_KELLER_COMP_MTR, KENNEDY_THEATRE_MAIN_MTR, KRAUSS_HALL_MAIN_MTR, LAW_LIB_MAIN_MTR, LAW_SCHOOL_MAIN_MTR, LES_MURAKAMI_STADIUM_CONSESS_MTR, LES_MURAKAMI_STADIUM_MAIN_MTR, MARINE_SCIENCE_MAIN_A_MTR, MARINE_SCIENCE_MAIN_B_MTR, MARINE_SCIENCE_MCC_MTR, MILLER_HALL_MAIN_MTR, MOORE_HALL_MAIN_MTR, MUSIC_COMPLEX_MAIN_MTR, PBRC_MAIN_A_MTR, PBRC_MAIN_B_MTR, PHYSICAL_SCIENCE_MAIN_MTR, POST_CHILLER_PLANT_MAIN, POST_MAIN_1, POST_MAIN_2, QLCSS_MAIN_MTR, QUAD_CHILLER_PLANT_MAIN_MTR, SAKAMAKI_HALL_AC_EQPT_MTR, SAKAMAKI_HALL_MAIN_MTR, SAUNDERS_HALL_MAIN_A_MTR, SAUNDERS_HALL_MAIN_B_MTR, SHERMAN_MAIN_1_MTR, SHERMAN_MAIN_2_MTR, SPALDING_HALL_MAIN_MTR, ST_JOHN_PLANT_SCIENCE_MAIN_MTR, STAN_SHERIFF_CTR_MAIN_1_MTR, STAN_SHERIFF_CTR_MAIN_2_MTR, MULTIPURPOSE_BLDG_MAIN_MTR, WEBSTER_HALL_MAIN_MTR, WIST_HALL_MAIN_MTR|
|VBC|AG_ENGINEERING_MAIN_MTR, AG_ENGINEERING_MCC_MTR, AG_SCIENCE_MCC_MTR, ARCHITECTURE_MAIN_MTR, BACHMAN_HALL_MAIN_MTR, BIOMEDICAL_SCIENCE_CH_1_MTR, BIOMEDICAL_SCIENCE_CH_2_MTR, BIOMEDICAL_SCIENCE_MAIN_A_MTR, BIOMEDICAL_SCIENCE_MAIN_B_MTR, BIOMEDICAL_SCIENCE_MCC_A_MTR, BUS_AD_SHIDLER_MAIN_MTR, KOREAN_STUDIES_MAIN_MTR, CRAWFORD_HALL_MAIN_MTR, DEAN_HALL_MAIN_MTR, DKAC_POOL_MAIN_MTR, ENV_PROTECTION_MAIN_MTR, EVERLY_HALL_MAIN_MTR, GEORGE_HALL_MAIN_MTR, GILMORE_HALL_MAIN_A_MTR, GILMORE_HALL_MAIN_B_MTR, GILMORE_HALL_MCC_MTR, HAMILTON_LIB_PH_III_CH_1_MTR, HAMILTON_LIB_PH_III_CH_2_MTR, HAMILTON_LIB_PH_III_CH_3_MTR, HAMILTON_LIB_PH_III_MAIN_1_MTR, HAMILTON_LIB_PH_III_MAIN_2_MTR, HAMILTON_LIB_PH_III_MCC_AC1_MTR, HAMILTON_LIB_PH_III_MCC_AC2_MTR, HAWAII_HALL_MAIN_MTR, HIG_NOAA_MTR, HIG_PANEL_PB_MTR, HIG_PANEL_PBA_MTR, HIG_SUBSTATION_1_MAIN_MTR, HIG_SUBSTATION_2_MAIN_MTR, HIG_SUBSTATION_3_MAIN_MTR, HPER_KLUM_GYM_MTR, HPER_MAIN_MTR, KELLER_HALL_MAIN_MTR, PHYSICAL_SCIENCE_KELLER_COMP_MTR, KENNEDY_THEATRE_MAIN_MTR, KRAUSS_HALL_MAIN_MTR, LAW_LIB_MAIN_MTR, LAW_SCHOOL_MAIN_MTR, LES_MURAKAMI_STADIUM_CONSESS_MTR, LES_MURAKAMI_STADIUM_MAIN_MTR, MARINE_SCIENCE_MAIN_A_MTR, MARINE_SCIENCE_MAIN_B_MTR, MARINE_SCIENCE_MCC_MTR, MILLER_HALL_MAIN_MTR, MOORE_HALL_MAIN_MTR, MUSIC_COMPLEX_MAIN_MTR, PBRC_MAIN_A_MTR, PBRC_MAIN_B_MTR, PHYSICAL_SCIENCE_MAIN_MTR, POST_CHILLER_PLANT_MAIN, POST_MAIN_1, POST_MAIN_2, QLCSS_MAIN_MTR, QUAD_CHILLER_PLANT_MAIN_MTR, SAKAMAKI_HALL_AC_EQPT_MTR, SAKAMAKI_HALL_MAIN_MTR, SAUNDERS_HALL_MAIN_A_MTR, SAUNDERS_HALL_MAIN_B_MTR, SHERMAN_MAIN_1_MTR, SHERMAN_MAIN_2_MTR, SPALDING_HALL_MAIN_MTR, ST_JOHN_PLANT_SCIENCE_MAIN_MTR, STAN_SHERIFF_CTR_MAIN_1_MTR, STAN_SHERIFF_CTR_MAIN_2_MTR, MULTIPURPOSE_BLDG_MAIN_MTR, WEBSTER_HALL_MAIN_MTR, WIST_HALL_MAIN_MTR|
|VBN|AG_ENGINEERING_MAIN_MTR, AG_ENGINEERING_MCC_MTR, AG_SCIENCE_MCC_MTR, ARCHITECTURE_MAIN_MTR, BACHMAN_HALL_MAIN_MTR, BIOMEDICAL_SCIENCE_CH_1_MTR, BIOMEDICAL_SCIENCE_CH_2_MTR, BIOMEDICAL_SCIENCE_MAIN_A_MTR, BIOMEDICAL_SCIENCE_MAIN_B_MTR, BIOMEDICAL_SCIENCE_MCC_A_MTR, BUS_AD_SHIDLER_MAIN_MTR, KOREAN_STUDIES_MAIN_MTR, CRAWFORD_HALL_MAIN_MTR, DEAN_HALL_MAIN_MTR, DKAC_POOL_MAIN_MTR, ENV_PROTECTION_MAIN_MTR, EVERLY_HALL_MAIN_MTR, GEORGE_HALL_MAIN_MTR, GILMORE_HALL_MAIN_A_MTR, GILMORE_HALL_MAIN_B_MTR, GILMORE_HALL_MCC_MTR, HAMILTON_LIB_PH_III_CH_1_MTR, HAMILTON_LIB_PH_III_CH_2_MTR, HAMILTON_LIB_PH_III_CH_3_MTR, HAMILTON_LIB_PH_III_MAIN_1_MTR, HAMILTON_LIB_PH_III_MAIN_2_MTR, HAMILTON_LIB_PH_III_MCC_AC1_MTR, HAMILTON_LIB_PH_III_MCC_AC2_MTR, HAWAII_HALL_MAIN_MTR, HIG_NOAA_MTR, HIG_PANEL_PB_MTR, HIG_PANEL_PBA_MTR, HIG_SUBSTATION_1_MAIN_MTR, HIG_SUBSTATION_2_MAIN_MTR, HIG_SUBSTATION_3_MAIN_MTR, HPER_KLUM_GYM_MTR, HPER_MAIN_MTR, KELLER_HALL_MAIN_MTR, PHYSICAL_SCIENCE_KELLER_COMP_MTR, KENNEDY_THEATRE_MAIN_MTR, KRAUSS_HALL_MAIN_MTR, LAW_LIB_MAIN_MTR, LAW_SCHOOL_MAIN_MTR, LES_MURAKAMI_STADIUM_CONSESS_MTR, LES_MURAKAMI_STADIUM_MAIN_MTR, MARINE_SCIENCE_MAIN_A_MTR, MARINE_SCIENCE_MAIN_B_MTR, MARINE_SCIENCE_MCC_MTR, MILLER_HALL_MAIN_MTR, MOORE_HALL_MAIN_MTR, MUSIC_COMPLEX_MAIN_MTR, PBRC_MAIN_A_MTR, PBRC_MAIN_B_MTR, PHYSICAL_SCIENCE_MAIN_MTR, POST_CHILLER_PLANT_MAIN, POST_MAIN_1, POST_MAIN_2, QLCSS_MAIN_MTR, QUAD_CHILLER_PLANT_MAIN_MTR, SAKAMAKI_HALL_AC_EQPT_MTR, SAKAMAKI_HALL_MAIN_MTR, SAUNDERS_HALL_MAIN_A_MTR, SAUNDERS_HALL_MAIN_B_MTR, SHERMAN_MAIN_1_MTR, SHERMAN_MAIN_2_MTR, SPALDING_HALL_MAIN_MTR, ST_JOHN_PLANT_SCIENCE_MAIN_MTR, STAN_SHERIFF_CTR_MAIN_1_MTR, STAN_SHERIFF_CTR_MAIN_2_MTR, MULTIPURPOSE_BLDG_MAIN_MTR, WEBSTER_HALL_MAIN_MTR, WIST_HALL_MAIN_MTR|
|VCA|AG_ENGINEERING_MAIN_MTR, AG_ENGINEERING_MCC_MTR, AG_SCIENCE_MCC_MTR, ARCHITECTURE_MAIN_MTR, BACHMAN_HALL_MAIN_MTR, BIOMEDICAL_SCIENCE_CH_1_MTR, BIOMEDICAL_SCIENCE_CH_2_MTR, BIOMEDICAL_SCIENCE_MAIN_A_MTR, BIOMEDICAL_SCIENCE_MAIN_B_MTR, BIOMEDICAL_SCIENCE_MCC_A_MTR, BUS_AD_SHIDLER_MAIN_MTR, KOREAN_STUDIES_MAIN_MTR, CRAWFORD_HALL_MAIN_MTR, DEAN_HALL_MAIN_MTR, DKAC_POOL_MAIN_MTR, ENV_PROTECTION_MAIN_MTR, EVERLY_HALL_MAIN_MTR, GEORGE_HALL_MAIN_MTR, GILMORE_HALL_MAIN_A_MTR, GILMORE_HALL_MAIN_B_MTR, GILMORE_HALL_MCC_MTR, HAMILTON_LIB_PH_III_CH_1_MTR, HAMILTON_LIB_PH_III_CH_2_MTR, HAMILTON_LIB_PH_III_CH_3_MTR, HAMILTON_LIB_PH_III_MAIN_1_MTR, HAMILTON_LIB_PH_III_MAIN_2_MTR, HAMILTON_LIB_PH_III_MCC_AC1_MTR, HAMILTON_LIB_PH_III_MCC_AC2_MTR, HAWAII_HALL_MAIN_MTR, HIG_NOAA_MTR, HIG_PANEL_PB_MTR, HIG_PANEL_PBA_MTR, HIG_SUBSTATION_1_MAIN_MTR, HIG_SUBSTATION_2_MAIN_MTR, HIG_SUBSTATION_3_MAIN_MTR, HPER_KLUM_GYM_MTR, HPER_MAIN_MTR, KELLER_HALL_MAIN_MTR, PHYSICAL_SCIENCE_KELLER_COMP_MTR, KENNEDY_THEATRE_MAIN_MTR, KRAUSS_HALL_MAIN_MTR, LAW_LIB_MAIN_MTR, LAW_SCHOOL_MAIN_MTR, LES_MURAKAMI_STADIUM_CONSESS_MTR, LES_MURAKAMI_STADIUM_MAIN_MTR, MARINE_SCIENCE_MAIN_A_MTR, MARINE_SCIENCE_MAIN_B_MTR, MARINE_SCIENCE_MCC_MTR, MILLER_HALL_MAIN_MTR, MOORE_HALL_MAIN_MTR, MUSIC_COMPLEX_MAIN_MTR, PBRC_MAIN_A_MTR, PBRC_MAIN_B_MTR, PHYSICAL_SCIENCE_MAIN_MTR, POST_CHILLER_PLANT_MAIN, POST_MAIN_1, POST_MAIN_2, QLCSS_MAIN_MTR, QUAD_CHILLER_PLANT_MAIN_MTR, SAKAMAKI_HALL_AC_EQPT_MTR, SAKAMAKI_HALL_MAIN_MTR, SAUNDERS_HALL_MAIN_A_MTR, SAUNDERS_HALL_MAIN_B_MTR, SHERMAN_MAIN_1_MTR, SHERMAN_MAIN_2_MTR, SPALDING_HALL_MAIN_MTR, ST_JOHN_PLANT_SCIENCE_MAIN_MTR, STAN_SHERIFF_CTR_MAIN_1_MTR, STAN_SHERIFF_CTR_MAIN_2_MTR, MULTIPURPOSE_BLDG_MAIN_MTR, WEBSTER_HALL_MAIN_MTR, WIST_HALL_MAIN_MTR|
|VCN|AG_ENGINEERING_MAIN_MTR, AG_ENGINEERING_MCC_MTR, AG_SCIENCE_MCC_MTR, ARCHITECTURE_MAIN_MTR, BACHMAN_HALL_MAIN_MTR, BIOMEDICAL_SCIENCE_CH_1_MTR, BIOMEDICAL_SCIENCE_CH_2_MTR, BIOMEDICAL_SCIENCE_MAIN_A_MTR, BIOMEDICAL_SCIENCE_MAIN_B_MTR, BIOMEDICAL_SCIENCE_MCC_A_MTR, BUS_AD_SHIDLER_MAIN_MTR, KOREAN_STUDIES_MAIN_MTR, CRAWFORD_HALL_MAIN_MTR, DEAN_HALL_MAIN_MTR, DKAC_POOL_MAIN_MTR, ENV_PROTECTION_MAIN_MTR, EVERLY_HALL_MAIN_MTR, GEORGE_HALL_MAIN_MTR, GILMORE_HALL_MAIN_A_MTR, GILMORE_HALL_MAIN_B_MTR, GILMORE_HALL_MCC_MTR, HAMILTON_LIB_PH_III_CH_1_MTR, HAMILTON_LIB_PH_III_CH_2_MTR, HAMILTON_LIB_PH_III_CH_3_MTR, HAMILTON_LIB_PH_III_MAIN_1_MTR, HAMILTON_LIB_PH_III_MAIN_2_MTR, HAMILTON_LIB_PH_III_MCC_AC1_MTR, HAMILTON_LIB_PH_III_MCC_AC2_MTR, HAWAII_HALL_MAIN_MTR, HIG_NOAA_MTR, HIG_PANEL_PB_MTR, HIG_PANEL_PBA_MTR, HIG_SUBSTATION_1_MAIN_MTR, HIG_SUBSTATION_2_MAIN_MTR, HIG_SUBSTATION_3_MAIN_MTR, HPER_KLUM_GYM_MTR, HPER_MAIN_MTR, KELLER_HALL_MAIN_MTR, PHYSICAL_SCIENCE_KELLER_COMP_MTR, KENNEDY_THEATRE_MAIN_MTR, KRAUSS_HALL_MAIN_MTR, LAW_LIB_MAIN_MTR, LAW_SCHOOL_MAIN_MTR, LES_MURAKAMI_STADIUM_CONSESS_MTR, LES_MURAKAMI_STADIUM_MAIN_MTR, MARINE_SCIENCE_MAIN_A_MTR, MARINE_SCIENCE_MAIN_B_MTR, MARINE_SCIENCE_MCC_MTR, MILLER_HALL_MAIN_MTR, MOORE_HALL_MAIN_MTR, MUSIC_COMPLEX_MAIN_MTR, PBRC_MAIN_A_MTR, PBRC_MAIN_B_MTR, PHYSICAL_SCIENCE_MAIN_MTR, POST_CHILLER_PLANT_MAIN, POST_MAIN_1, POST_MAIN_2, QLCSS_MAIN_MTR, QUAD_CHILLER_PLANT_MAIN_MTR, SAKAMAKI_HALL_AC_EQPT_MTR, SAKAMAKI_HALL_MAIN_MTR, SAUNDERS_HALL_MAIN_A_MTR, SAUNDERS_HALL_MAIN_B_MTR, SHERMAN_MAIN_1_MTR, SHERMAN_MAIN_2_MTR, SPALDING_HALL_MAIN_MTR, ST_JOHN_PLANT_SCIENCE_MAIN_MTR, STAN_SHERIFF_CTR_MAIN_1_MTR, STAN_SHERIFF_CTR_MAIN_2_MTR, MULTIPURPOSE_BLDG_MAIN_MTR, WEBSTER_HALL_MAIN_MTR, WIST_HALL_MAIN_MTR|
|VOLAGE_CN_THD|ARCHITECTURE_MAIN_MTR, BACHMAN_HALL_MAIN_MTR, BUS_AD_SHIDLER_MAIN_MTR, CRAWFORD_HALL_MAIN_MTR, DKAC_POOL_MAIN_MTR, ENV_PROTECTION_MAIN_MTR, HAWAII_HALL_MAIN_MTR, KELLER_HALL_MAIN_MTR, PHYSICAL_SCIENCE_KELLER_COMP_MTR|
|VOLTAGE_AN_THD|ARCHITECTURE_MAIN_MTR, BACHMAN_HALL_MAIN_MTR, BUS_AD_SHIDLER_MAIN_MTR, KOREAN_STUDIES_MAIN_MTR, CRAWFORD_HALL_MAIN_MTR, DKAC_POOL_MAIN_MTR, ENV_PROTECTION_MAIN_MTR, GEORGE_HALL_MAIN_MTR, HAWAII_HALL_MAIN_MTR, HPER_KLUM_GYM_MTR, HPER_MAIN_MTR, KELLER_HALL_MAIN_MTR, PHYSICAL_SCIENCE_KELLER_COMP_MTR, KENNEDY_THEATRE_MAIN_MTR, KRAUSS_HALL_MAIN_MTR, LAW_LIB_MAIN_MTR, LAW_SCHOOL_MAIN_MTR, LES_MURAKAMI_STADIUM_CONSESS_MTR, LES_MURAKAMI_STADIUM_MAIN_MTR, MOORE_HALL_MAIN_MTR, MUSIC_COMPLEX_MAIN_MTR, PBRC_MAIN_A_MTR, PBRC_MAIN_B_MTR, QLCSS_MAIN_MTR, SPALDING_HALL_MAIN_MTR, MULTIPURPOSE_BLDG_MAIN_MTR|
|VOLTAGE_BN_THD|ARCHITECTURE_MAIN_MTR, BACHMAN_HALL_MAIN_MTR, BUS_AD_SHIDLER_MAIN_MTR, KOREAN_STUDIES_MAIN_MTR, CRAWFORD_HALL_MAIN_MTR, DKAC_POOL_MAIN_MTR, ENV_PROTECTION_MAIN_MTR, GEORGE_HALL_MAIN_MTR, HAWAII_HALL_MAIN_MTR, HPER_KLUM_GYM_MTR, HPER_MAIN_MTR, KELLER_HALL_MAIN_MTR, PHYSICAL_SCIENCE_KELLER_COMP_MTR, KENNEDY_THEATRE_MAIN_MTR, KRAUSS_HALL_MAIN_MTR, LAW_LIB_MAIN_MTR, LAW_SCHOOL_MAIN_MTR, LES_MURAKAMI_STADIUM_CONSESS_MTR, LES_MURAKAMI_STADIUM_MAIN_MTR, MOORE_HALL_MAIN_MTR, MUSIC_COMPLEX_MAIN_MTR, PBRC_MAIN_A_MTR, PBRC_MAIN_B_MTR, QLCSS_MAIN_MTR, SPALDING_HALL_MAIN_MTR, MULTIPURPOSE_BLDG_MAIN_MTR|
|VOLTAGE_CN_THD|ARCHITECTURE_MAIN_MTR, BACHMAN_HALL_MAIN_MTR, KOREAN_STUDIES_MAIN_MTR, CRAWFORD_HALL_MAIN_MTR, DKAC_POOL_MAIN_MTR, ENV_PROTECTION_MAIN_MTR, GEORGE_HALL_MAIN_MTR, HAWAII_HALL_MAIN_MTR, HPER_KLUM_GYM_MTR, HPER_MAIN_MTR, KELLER_HALL_MAIN_MTR, PHYSICAL_SCIENCE_KELLER_COMP_MTR, KENNEDY_THEATRE_MAIN_MTR, KRAUSS_HALL_MAIN_MTR, LAW_LIB_MAIN_MTR, LAW_SCHOOL_MAIN_MTR, LES_MURAKAMI_STADIUM_CONSESS_MTR, LES_MURAKAMI_STADIUM_MAIN_MTR, MOORE_HALL_MAIN_MTR, MUSIC_COMPLEX_MAIN_MTR, PBRC_MAIN_A_MTR, PBRC_MAIN_B_MTR, QLCSS_MAIN_MTR, SPALDING_HALL_MAIN_MTR, MULTIPURPOSE_BLDG_MAIN_MTR|
|WALL_TEMP_1|FROG_1_SPACE_ENVIRONMENT, FROG_2_SPACE_ENVIRONMENT|
|WALL_TEMP_2|FROG_1_SPACE_ENVIRONMENT, FROG_2_SPACE_ENVIRONMENT|
|WALL_TEMP_3|FROG_1_SPACE_ENVIRONMENT, FROG_2_SPACE_ENVIRONMENT|
|WATTS_PER_SQ_FT|AGRICULTURAL_ENGINEERING_INST_BLDG_KEY_PERF_IND, ARCHITECTURE_BLDG_KEY_PERF_IND, AGRICULTURAL_SCIENCE_BLDG_KEY_PERF_IND, BACHMAN_HALL_BLDG_KEY_PERF_IND, BILGER_ADDITION_HALL_BLDG_KEY_PERF_IND, BIOMEDICAL_SCIENCE_BLDG_KEY_PERF_IND, BUSINESS_ADMINISTRATION_BLDG_KEY_PERF_IND, CENTER_FOR_KOREAN_STUDIES_BLDG_KEY_PERF_IND, CRAWFORD_LAW_BLDG_KEY_PERF_IND, DEAN_HALL_BLDG_KEY_PERF_IND, DKAC_BLDG_KEY_PERF_IND, EDMONSON_HALL_BLDG_KEY_PERF_IND, ENV_PROTECTION_FACILITY_BLDG_KEY_PERF_IND, EVERLY_HALL_BLDG_KEY_PERF_IND, GEORGE_HALL_BLDG_KEY_PERF_IND, GILMORE_HALL_BLDG_KEY_PERF_IND, HAMILTON_LIBRARY_PH_III_BLDG_KEY_PERF_IND, HAWAII_HALL_BLDG_KEY_PERF_IND, HIG_BLDG_KEY_PERF_IND, HPER_BLDG_KEY_PERF_IND, INSITITUTE_FOR_ASTRONOMY_BLDG_KEY_PERF_IND, IT_CENTER_BLDG_KEY_PERF_IND, KELLER_HALL_BLDG_KEY_PERF_IND, KENNEDY_THEATRE_BLDG_KEY_PERF_IND, KRAUSS_PRI_BLDG_KEY_PERF_IND, KUYKENDALL_HALL_BLDG_KEY_PERF_IND, LAW_LIBRARY_BLDG_KEY_PERF_IND, LAW_SCHOOL_BLDG_KEY_PERF_IND, LES_MURAKAMI_STADIUM_BLDG_KEY_PERF_IND, MARINE_SCIENCE_BLDG_KEY_PERF_IND, MILLER_HALL_BLDG_KEY_PERF_IND, MOORE_HALL_BLDG_KEY_PERF_IND, MUSIC_COMPLEX_PH_I_BLDG_KEY_PERF_IND, PBRC_BLDG_KEY_PERF_IND, PHYSICAL_SCIENCE_BLDG_KEY_PERF_IND, POST_BLDG_KEY_PERF_IND, QLCSS_BLDG_KEY_PERF_IND, QUADRANGLE_LOOP_BLDG_KEY_PERF_IND, SAKAMAKI_HALL_BLDG_KEY_PERF_IND, SAUNDERS_HALL_BLDG_KEY_PERF_IND, SHERMAN_LAB_BLDG_KEY_PERF_IND, SPALDING_HALL_BLDG_KEY_PERF_IND, ST_JOHN_BLDG_KEY_PERF_IND, STAN_SHERIFF_CENTER_BLDG_KEY_PERF_IND, SUBSTATION_L_BLDG_KEY_PERF_IND, UNIV_LAB_SCHOOL_MULTIPURPOSE_BLDG_KEY_PERF_IND, WARRIOR_CENTER_BLDG_KEY_PERF_IND, WEBSTER_HALL_BLDG_KEY_PERF_IND, WIST_HALL_BLDG_KEY_PERF_IND|
|WIND_DIRECTION|FROG_1_WEATHER_STATION|
|WIND_SPEED|FROG_1_WEATHER_STATION|
|WIST_HALL_EVERLY_HALL_CHWP_1_STATUS|WIST_HALL_EVERLY_HALL_CUP|
|WIST_HALL_EVERLY_HALL_CHWP_2_STATUS|WIST_HALL_EVERLY_HALL_CUP|
|WIST_HALL_EVERLY_HALL_CH_1_STATUS|WIST_HALL_EVERLY_HALL_CUP|
|WIST_HALL_EVERLY_HALL_CH_2_STATUS|WIST_HALL_EVERLY_HALL_CUP|
|WIST_HALL_EVERLY_HALL_CT_1_STATUS|WIST_HALL_EVERLY_HALL_CUP|
|WIST_HALL_EVERLY_HALL_CT_2_STATUS|WIST_HALL_EVERLY_HALL_CUP|
|WIST_HALL_EVERLY_HALL_CWP_1_STATUS|WIST_HALL_EVERLY_HALL_CUP|
|WIST_HALL_EVERLY_HALL_CWP_2_STATUS|WIST_HALL_EVERLY_HALL_CUP|
|WIST_HALL_FLOW|WIST_HALL_EVERLY_HALL_CUP|
|ZONE_1_HUMIDITY|FROG_1_SPACE_ENVIRONMENT, FROG_2_SPACE_ENVIRONMENT|
|ZONE_1_TEMP|FROG_1_SPACE_ENVIRONMENT, FROG_2_SPACE_ENVIRONMENT|
|ZONE_2_HUMIDITY|FROG_1_SPACE_ENVIRONMENT, FROG_2_SPACE_ENVIRONMENT|
|ZONE_2_TEMP|FROG_1_SPACE_ENVIRONMENT, FROG_2_SPACE_ENVIRONMENT|
|btu_hr|AGRICULTURAL_SCIENCE_CUP|
|kVA|AG_ENGINEERING_MAIN_MTR, AG_ENGINEERING_MCC_MTR, AG_SCIENCE_MCC_MTR, ARCHITECTURE_MAIN_MTR, BACHMAN_HALL_MAIN_MTR, BIOMEDICAL_SCIENCE_CH_1_MTR, BIOMEDICAL_SCIENCE_CH_2_MTR, BIOMEDICAL_SCIENCE_MAIN_A_MTR, BIOMEDICAL_SCIENCE_MAIN_B_MTR, BIOMEDICAL_SCIENCE_MCC_A_MTR, BUS_AD_SHIDLER_MAIN_MTR, KOREAN_STUDIES_MAIN_MTR, CRAWFORD_HALL_MAIN_MTR, DEAN_HALL_MAIN_MTR, DKAC_POOL_MAIN_MTR, ENV_PROTECTION_MAIN_MTR, EVERLY_HALL_MAIN_MTR, GEORGE_HALL_MAIN_MTR, GILMORE_HALL_MAIN_A_MTR, GILMORE_HALL_MAIN_B_MTR, GILMORE_HALL_MCC_MTR, HAMILTON_LIB_PH_III_CH_1_MTR, HAMILTON_LIB_PH_III_CH_2_MTR, HAMILTON_LIB_PH_III_CH_3_MTR, HAMILTON_LIB_PH_III_MAIN_1_MTR, HAMILTON_LIB_PH_III_MAIN_2_MTR, HAMILTON_LIB_PH_III_MCC_AC1_MTR, HAMILTON_LIB_PH_III_MCC_AC2_MTR, HAWAII_HALL_MAIN_MTR, HIG_NOAA_MTR, HIG_PANEL_PB_MTR, HIG_PANEL_PBA_MTR, HIG_SUBSTATION_1_MAIN_MTR, HIG_SUBSTATION_2_MAIN_MTR, HIG_SUBSTATION_3_MAIN_MTR, HPER_KLUM_GYM_MTR, HPER_MAIN_MTR, KELLER_HALL_MAIN_MTR, PHYSICAL_SCIENCE_KELLER_COMP_MTR, KENNEDY_THEATRE_MAIN_MTR, KRAUSS_HALL_MAIN_MTR, LAW_LIB_MAIN_MTR, LAW_SCHOOL_MAIN_MTR, LES_MURAKAMI_STADIUM_CONSESS_MTR, LES_MURAKAMI_STADIUM_MAIN_MTR, MARINE_SCIENCE_MAIN_A_MTR, MARINE_SCIENCE_MAIN_B_MTR, MARINE_SCIENCE_MCC_MTR, MILLER_HALL_MAIN_MTR, MOORE_HALL_MAIN_MTR, MUSIC_COMPLEX_MAIN_MTR, PBRC_MAIN_A_MTR, PBRC_MAIN_B_MTR, PHYSICAL_SCIENCE_MAIN_MTR, POST_CHILLER_PLANT_MAIN, POST_MAIN_1, POST_MAIN_2, QLCSS_MAIN_MTR, QUAD_CHILLER_PLANT_MAIN_MTR, SAKAMAKI_HALL_AC_EQPT_MTR, SAKAMAKI_HALL_MAIN_MTR, SAUNDERS_HALL_MAIN_A_MTR, SAUNDERS_HALL_MAIN_B_MTR, SHERMAN_MAIN_1_MTR, SHERMAN_MAIN_2_MTR, SPALDING_HALL_MAIN_MTR, ST_JOHN_PLANT_SCIENCE_MAIN_MTR, STAN_SHERIFF_CTR_MAIN_1_MTR, STAN_SHERIFF_CTR_MAIN_2_MTR, MULTIPURPOSE_BLDG_MAIN_MTR, WEBSTER_HALL_MAIN_MTR, WIST_HALL_MAIN_MTR|
|kVARS|AG_ENGINEERING_MAIN_MTR, AG_ENGINEERING_MCC_MTR, AG_SCIENCE_MCC_MTR, ARCHITECTURE_MAIN_MTR, BACHMAN_HALL_MAIN_MTR, BIOMEDICAL_SCIENCE_CH_1_MTR, BIOMEDICAL_SCIENCE_CH_2_MTR, BIOMEDICAL_SCIENCE_MAIN_A_MTR, BIOMEDICAL_SCIENCE_MAIN_B_MTR, BIOMEDICAL_SCIENCE_MCC_A_MTR, BUS_AD_SHIDLER_MAIN_MTR, KOREAN_STUDIES_MAIN_MTR, CRAWFORD_HALL_MAIN_MTR, DEAN_HALL_MAIN_MTR, DKAC_POOL_MAIN_MTR, ENV_PROTECTION_MAIN_MTR, EVERLY_HALL_MAIN_MTR, GEORGE_HALL_MAIN_MTR, GILMORE_HALL_MAIN_A_MTR, GILMORE_HALL_MAIN_B_MTR, GILMORE_HALL_MCC_MTR, HAMILTON_LIB_PH_III_CH_1_MTR, HAMILTON_LIB_PH_III_CH_2_MTR, HAMILTON_LIB_PH_III_CH_3_MTR, HAMILTON_LIB_PH_III_MAIN_1_MTR, HAMILTON_LIB_PH_III_MAIN_2_MTR, HAMILTON_LIB_PH_III_MCC_AC1_MTR, HAMILTON_LIB_PH_III_MCC_AC2_MTR, HAWAII_HALL_MAIN_MTR, HIG_NOAA_MTR, HIG_PANEL_PB_MTR, HIG_PANEL_PBA_MTR, HIG_SUBSTATION_1_MAIN_MTR, HIG_SUBSTATION_2_MAIN_MTR, HIG_SUBSTATION_3_MAIN_MTR, HPER_KLUM_GYM_MTR, HPER_MAIN_MTR, KELLER_HALL_MAIN_MTR, PHYSICAL_SCIENCE_KELLER_COMP_MTR, KENNEDY_THEATRE_MAIN_MTR, KRAUSS_HALL_MAIN_MTR, LAW_LIB_MAIN_MTR, LAW_SCHOOL_MAIN_MTR, LES_MURAKAMI_STADIUM_CONSESS_MTR, LES_MURAKAMI_STADIUM_MAIN_MTR, MARINE_SCIENCE_MAIN_A_MTR, MARINE_SCIENCE_MAIN_B_MTR, MARINE_SCIENCE_MCC_MTR, MILLER_HALL_MAIN_MTR, MOORE_HALL_MAIN_MTR, MUSIC_COMPLEX_MAIN_MTR, PBRC_MAIN_A_MTR, PBRC_MAIN_B_MTR, PHYSICAL_SCIENCE_MAIN_MTR, POST_CHILLER_PLANT_MAIN, POST_MAIN_1, POST_MAIN_2, QLCSS_MAIN_MTR, QUAD_CHILLER_PLANT_MAIN_MTR, SAKAMAKI_HALL_AC_EQPT_MTR, SAKAMAKI_HALL_MAIN_MTR, SAUNDERS_HALL_MAIN_A_MTR, SAUNDERS_HALL_MAIN_B_MTR, SHERMAN_MAIN_1_MTR, SHERMAN_MAIN_2_MTR, SPALDING_HALL_MAIN_MTR, ST_JOHN_PLANT_SCIENCE_MAIN_MTR, STAN_SHERIFF_CTR_MAIN_1_MTR, STAN_SHERIFF_CTR_MAIN_2_MTR, MULTIPURPOSE_BLDG_MAIN_MTR, WEBSTER_HALL_MAIN_MTR, WIST_HALL_MAIN_MTR|
|kVARh|AG_ENGINEERING_MAIN_MTR, AG_ENGINEERING_MCC_MTR, AG_SCIENCE_MCC_MTR, ARCHITECTURE_MAIN_MTR, BACHMAN_HALL_MAIN_MTR, BIOMEDICAL_SCIENCE_CH_1_MTR, BIOMEDICAL_SCIENCE_CH_2_MTR, BIOMEDICAL_SCIENCE_MAIN_A_MTR, BIOMEDICAL_SCIENCE_MAIN_B_MTR, BIOMEDICAL_SCIENCE_MCC_A_MTR, BUS_AD_SHIDLER_MAIN_MTR, KOREAN_STUDIES_MAIN_MTR, CRAWFORD_HALL_MAIN_MTR, DEAN_HALL_MAIN_MTR, DKAC_POOL_MAIN_MTR, ENV_PROTECTION_MAIN_MTR, EVERLY_HALL_MAIN_MTR, GEORGE_HALL_MAIN_MTR, GILMORE_HALL_MAIN_A_MTR, GILMORE_HALL_MAIN_B_MTR, GILMORE_HALL_MCC_MTR, HAMILTON_LIB_PH_III_CH_1_MTR, HAMILTON_LIB_PH_III_CH_2_MTR, HAMILTON_LIB_PH_III_CH_3_MTR, HAMILTON_LIB_PH_III_MAIN_1_MTR, HAMILTON_LIB_PH_III_MAIN_2_MTR, HAMILTON_LIB_PH_III_MCC_AC1_MTR, HAMILTON_LIB_PH_III_MCC_AC2_MTR, HAWAII_HALL_MAIN_MTR, HIG_NOAA_MTR, HIG_PANEL_PB_MTR, HIG_PANEL_PBA_MTR, HIG_SUBSTATION_1_MAIN_MTR, HIG_SUBSTATION_2_MAIN_MTR, HIG_SUBSTATION_3_MAIN_MTR, HPER_KLUM_GYM_MTR, HPER_MAIN_MTR, KELLER_HALL_MAIN_MTR, PHYSICAL_SCIENCE_KELLER_COMP_MTR, KENNEDY_THEATRE_MAIN_MTR, KRAUSS_HALL_MAIN_MTR, LAW_LIB_MAIN_MTR, LAW_SCHOOL_MAIN_MTR, LES_MURAKAMI_STADIUM_CONSESS_MTR, LES_MURAKAMI_STADIUM_MAIN_MTR, MARINE_SCIENCE_MAIN_A_MTR, MARINE_SCIENCE_MAIN_B_MTR, MARINE_SCIENCE_MCC_MTR, MILLER_HALL_MAIN_MTR, MOORE_HALL_MAIN_MTR, MUSIC_COMPLEX_MAIN_MTR, PBRC_MAIN_A_MTR, PBRC_MAIN_B_MTR, PHYSICAL_SCIENCE_MAIN_MTR, POST_CHILLER_PLANT_MAIN, POST_MAIN_1, POST_MAIN_2, QLCSS_MAIN_MTR, QUAD_CHILLER_PLANT_MAIN_MTR, SAKAMAKI_HALL_AC_EQPT_MTR, SAKAMAKI_HALL_MAIN_MTR, SAUNDERS_HALL_MAIN_A_MTR, SAUNDERS_HALL_MAIN_B_MTR, SHERMAN_MAIN_1_MTR, SHERMAN_MAIN_2_MTR, SPALDING_HALL_MAIN_MTR, ST_JOHN_PLANT_SCIENCE_MAIN_MTR, STAN_SHERIFF_CTR_MAIN_1_MTR, STAN_SHERIFF_CTR_MAIN_2_MTR, MULTIPURPOSE_BLDG_MAIN_MTR, WEBSTER_HALL_MAIN_MTR, WIST_HALL_MAIN_MTR|
|kVAh|AG_ENGINEERING_MAIN_MTR, AG_ENGINEERING_MCC_MTR, AG_SCIENCE_MCC_MTR, ARCHITECTURE_MAIN_MTR, BACHMAN_HALL_MAIN_MTR, BIOMEDICAL_SCIENCE_CH_1_MTR, BIOMEDICAL_SCIENCE_CH_2_MTR, BIOMEDICAL_SCIENCE_MAIN_A_MTR, BIOMEDICAL_SCIENCE_MAIN_B_MTR, BIOMEDICAL_SCIENCE_MCC_A_MTR, BUS_AD_SHIDLER_MAIN_MTR, KOREAN_STUDIES_MAIN_MTR, CRAWFORD_HALL_MAIN_MTR, DEAN_HALL_MAIN_MTR, DKAC_POOL_MAIN_MTR, ENV_PROTECTION_MAIN_MTR, EVERLY_HALL_MAIN_MTR, GEORGE_HALL_MAIN_MTR, GILMORE_HALL_MAIN_A_MTR, GILMORE_HALL_MAIN_B_MTR, GILMORE_HALL_MCC_MTR, HAMILTON_LIB_PH_III_CH_1_MTR, HAMILTON_LIB_PH_III_CH_2_MTR, HAMILTON_LIB_PH_III_CH_3_MTR, HAMILTON_LIB_PH_III_MAIN_1_MTR, HAMILTON_LIB_PH_III_MAIN_2_MTR, HAMILTON_LIB_PH_III_MCC_AC1_MTR, HAMILTON_LIB_PH_III_MCC_AC2_MTR, HAWAII_HALL_MAIN_MTR, HIG_NOAA_MTR, HIG_PANEL_PB_MTR, HIG_PANEL_PBA_MTR, HIG_SUBSTATION_1_MAIN_MTR, HIG_SUBSTATION_2_MAIN_MTR, HIG_SUBSTATION_3_MAIN_MTR, HPER_KLUM_GYM_MTR, HPER_MAIN_MTR, KELLER_HALL_MAIN_MTR, PHYSICAL_SCIENCE_KELLER_COMP_MTR, KENNEDY_THEATRE_MAIN_MTR, KRAUSS_HALL_MAIN_MTR, LAW_LIB_MAIN_MTR, LAW_SCHOOL_MAIN_MTR, LES_MURAKAMI_STADIUM_CONSESS_MTR, LES_MURAKAMI_STADIUM_MAIN_MTR, MARINE_SCIENCE_MAIN_A_MTR, MARINE_SCIENCE_MAIN_B_MTR, MARINE_SCIENCE_MCC_MTR, MILLER_HALL_MAIN_MTR, MOORE_HALL_MAIN_MTR, MUSIC_COMPLEX_MAIN_MTR, PBRC_MAIN_A_MTR, PBRC_MAIN_B_MTR, PHYSICAL_SCIENCE_MAIN_MTR, POST_CHILLER_PLANT_MAIN, POST_MAIN_1, POST_MAIN_2, QLCSS_MAIN_MTR, QUAD_CHILLER_PLANT_MAIN_MTR, SAKAMAKI_HALL_AC_EQPT_MTR, SAKAMAKI_HALL_MAIN_MTR, SAUNDERS_HALL_MAIN_A_MTR, SAUNDERS_HALL_MAIN_B_MTR, SHERMAN_MAIN_1_MTR, SHERMAN_MAIN_2_MTR, SPALDING_HALL_MAIN_MTR, ST_JOHN_PLANT_SCIENCE_MAIN_MTR, STAN_SHERIFF_CTR_MAIN_1_MTR, STAN_SHERIFF_CTR_MAIN_2_MTR, MULTIPURPOSE_BLDG_MAIN_MTR, WEBSTER_HALL_MAIN_MTR, WIST_HALL_MAIN_MTR|
|kW|AG_ENGINEERING_MAIN_MTR, AG_ENGINEERING_MCC_MTR, AGRICULTURAL_ENGINEERING_INST_BLDG_KEY_PERF_IND, AG_SCIENCE_MCC_MTR, ARCHITECTURE_BLDG_KEY_PERF_IND, AGRICULTURAL_SCIENCE_BLDG_KEY_PERF_IND, ARCHITECTURE_MAIN_MTR, BACHMAN_HALL_BLDG_KEY_PERF_IND, BACHMAN_HALL_MAIN_MTR, BILGER_ADDITION_HALL_BLDG_KEY_PERF_IND, BIOMEDICAL_SCIENCE_BLDG_KEY_PERF_IND, BIOMEDICAL_SCIENCE_CH_1_MTR, BIOMEDICAL_SCIENCE_CH_2_MTR, BIOMEDICAL_SCIENCE_MAIN_A_MTR, BIOMEDICAL_SCIENCE_MAIN_B_MTR, BIOMEDICAL_SCIENCE_MCC_A_MTR, BUS_AD_SHIDLER_MAIN_MTR, BUSINESS_ADMINISTRATION_BLDG_KEY_PERF_IND, CENTER_FOR_KOREAN_STUDIES_BLDG_KEY_PERF_IND, KOREAN_STUDIES_MAIN_MTR, CRAWFORD_LAW_BLDG_KEY_PERF_IND, CRAWFORD_HALL_MAIN_MTR, DEAN_HALL_BLDG_KEY_PERF_IND, DEAN_HALL_MAIN_MTR, DKAC_BLDG_KEY_PERF_IND, DKAC_POOL_MAIN_MTR, EDMONSON_HALL_BLDG_KEY_PERF_IND, ENV_PROTECTION_FACILITY_BLDG_KEY_PERF_IND, ENV_PROTECTION_MAIN_MTR, EVERLY_HALL_BLDG_KEY_PERF_IND, EVERLY_HALL_MAIN_MTR, FROG_1_AHU, FROG_1_BLDG_SERVICES, FROG_1_CEILING_FANS, FROG_1_CHILLER, FROG_1_EXTERIOR_LIGHTS, FROG_1_FIRE_ALARM, FROG_1_LUTRON_LIGHTS, FROG_1_SERVICE_LIGHTS, FROG_1_SOLAR_1, FROG_1_SOLAR_2, FROG_1_WHOLE_BLDG, FROG_1_WINDOW_ACTUATORS, FROG_2_AHU, FROG_2_BLDG_SERVICES, FROG_2_CEILING_FANS, FROG_2_CHILLER, FROG_2_EXTERIOR_LIGHTS, FROG_2_FIRE_ALARM, FROG_2_LUTRON_LIGHTS, FROG_2_SERVICE_LIGHTS, FROG_2_SOLAR_1, FROG_2_SOLAR_2, FROG_2_WHOLE_BLDG, FROG_2_WINDOW_ACTUATORS, GEORGE_HALL_BLDG_KEY_PERF_IND, GEORGE_HALL_MAIN_MTR, GILMORE_HALL_BLDG_KEY_PERF_IND, GILMORE_HALL_MAIN_A_MTR, GILMORE_HALL_MAIN_B_MTR, GILMORE_HALL_MCC_MTR, HAMILTON_LIBRARY_PH_III_BLDG_KEY_PERF_IND, HAMILTON_LIB_PH_III_CH_1_MTR, HAMILTON_LIB_PH_III_CH_2_MTR, HAMILTON_LIB_PH_III_CH_3_MTR, HAMILTON_LIB_PH_III_MAIN_1_MTR, HAMILTON_LIB_PH_III_MAIN_2_MTR, HAMILTON_LIB_PH_III_MCC_AC1_MTR, HAMILTON_LIB_PH_III_MCC_AC2_MTR, HAWAII_HALL_BLDG_KEY_PERF_IND, HAWAII_HALL_MAIN_MTR, HIG_BLDG_KEY_PERF_IND, HIG_NOAA_MTR, HIG_PANEL_PB_MTR, HIG_PANEL_PBA_MTR, HIG_SUBSTATION_1_MAIN_MTR, HIG_SUBSTATION_2_MAIN_MTR, HIG_SUBSTATION_3_MAIN_MTR, HPER_BLDG_KEY_PERF_IND, HPER_KLUM_GYM_MTR, HPER_MAIN_MTR, INSITITUTE_FOR_ASTRONOMY_BLDG_KEY_PERF_IND, IT_CENTER_BLDG_KEY_PERF_IND, KELLER_HALL_BLDG_KEY_PERF_IND, KELLER_HALL_MAIN_MTR, PHYSICAL_SCIENCE_KELLER_COMP_MTR, KENNEDY_THEATRE_BLDG_KEY_PERF_IND, KENNEDY_THEATRE_MAIN_MTR, KRAUSS_HALL_MAIN_MTR, KRAUSS_PRI_BLDG_KEY_PERF_IND, KUYKENDALL_HALL_BLDG_KEY_PERF_IND, LAW_LIB_MAIN_MTR, LAW_LIBRARY_BLDG_KEY_PERF_IND, LAW_SCHOOL_BLDG_KEY_PERF_IND, LAW_SCHOOL_MAIN_MTR, LES_MURAKAMI_STADIUM_BLDG_KEY_PERF_IND, LES_MURAKAMI_STADIUM_CONSESS_MTR, LES_MURAKAMI_STADIUM_MAIN_MTR, MARINE_SCIENCE_BLDG_KEY_PERF_IND, MARINE_SCIENCE_MAIN_A_MTR, MARINE_SCIENCE_MAIN_B_MTR, MARINE_SCIENCE_MCC_MTR, MILLER_HALL_BLDG_KEY_PERF_IND, MILLER_HALL_MAIN_MTR, MOORE_HALL_BLDG_KEY_PERF_IND, MOORE_HALL_MAIN_MTR, MUSIC_COMPLEX_MAIN_MTR, MUSIC_COMPLEX_PH_I_BLDG_KEY_PERF_IND, PBRC_BLDG_KEY_PERF_IND, PBRC_MAIN_A_MTR, PBRC_MAIN_B_MTR, PBRC_SATCON_GEN_2, PHYSICAL_SCIENCE_BLDG_KEY_PERF_IND, PHYSICAL_SCIENCE_MAIN_MTR, POST_BLDG_KEY_PERF_IND, POST_CHILLER_PLANT_MAIN, POST_MAIN_1, POST_MAIN_2, QLCSS_BLDG_KEY_PERF_IND, QLCSS_MAIN_MTR, QUAD_CHILLER_PLANT_MAIN_MTR, QUADRANGLE_LOOP_BLDG_KEY_PERF_IND, SAKAMAKI_HALL_AC_EQPT_MTR, SAKAMAKI_HALL_BLDG_KEY_PERF_IND, SAKAMAKI_HALL_MAIN_MTR, SAUNDERS_HALL_BLDG_KEY_PERF_IND, SAUNDERS_HALL_MAIN_A_MTR, SAUNDERS_HALL_MAIN_B_MTR, SHERMAN_LAB_BLDG_KEY_PERF_IND, SHERMAN_MAIN_1_MTR, SHERMAN_MAIN_2_MTR, SPALDING_HALL_BLDG_KEY_PERF_IND, SPALDING_HALL_MAIN_MTR, ST_JOHN_BLDG_KEY_PERF_IND, ST_JOHN_PLANT_SCIENCE_MAIN_MTR, STAN_SHERIFF_CENTER_BLDG_KEY_PERF_IND, STAN_SHERIFF_CTR_MAIN_1_MTR, STAN_SHERIFF_CTR_MAIN_2_MTR, SUBSTATION_L_BLDG_KEY_PERF_IND, MULTIPURPOSE_BLDG_MAIN_MTR, UNIV_LAB_SCHOOL_MULTIPURPOSE_BLDG_KEY_PERF_IND, WARRIOR_CENTER_BLDG_KEY_PERF_IND, WARRIOR_CENTER_INV0, WARRIOR_CENTER_INV1, WARRIOR_CENTER_INV2, WARRIOR_CENTER_INV3, WEBSTER_HALL_BLDG_KEY_PERF_IND, WEBSTER_HALL_MAIN_MTR, WIST_HALL_BLDG_KEY_PERF_IND, WIST_HALL_MAIN_MTR|
|kWh|AG_ENGINEERING_MAIN_MTR, AG_ENGINEERING_MCC_MTR, AG_SCIENCE_MCC_MTR, ARCHITECTURE_MAIN_MTR, BACHMAN_HALL_MAIN_MTR, BIOMEDICAL_SCIENCE_CH_1_MTR, BIOMEDICAL_SCIENCE_CH_2_MTR, BIOMEDICAL_SCIENCE_MAIN_A_MTR, BIOMEDICAL_SCIENCE_MAIN_B_MTR, BIOMEDICAL_SCIENCE_MCC_A_MTR, BUS_AD_SHIDLER_MAIN_MTR, KOREAN_STUDIES_MAIN_MTR, CRAWFORD_HALL_MAIN_MTR, DEAN_HALL_MAIN_MTR, DKAC_POOL_MAIN_MTR, ENV_PROTECTION_MAIN_MTR, EVERLY_HALL_MAIN_MTR, GEORGE_HALL_MAIN_MTR, GILMORE_HALL_MAIN_A_MTR, GILMORE_HALL_MAIN_B_MTR, GILMORE_HALL_MCC_MTR, HAMILTON_LIB_PH_III_CH_1_MTR, HAMILTON_LIB_PH_III_CH_2_MTR, HAMILTON_LIB_PH_III_CH_3_MTR, HAMILTON_LIB_PH_III_MAIN_1_MTR, HAMILTON_LIB_PH_III_MAIN_2_MTR, HAMILTON_LIB_PH_III_MCC_AC1_MTR, HAMILTON_LIB_PH_III_MCC_AC2_MTR, HAWAII_HALL_MAIN_MTR, HIG_NOAA_MTR, HIG_PANEL_PB_MTR, HIG_PANEL_PBA_MTR, HIG_SUBSTATION_1_MAIN_MTR, HIG_SUBSTATION_2_MAIN_MTR, HIG_SUBSTATION_3_MAIN_MTR, HPER_KLUM_GYM_MTR, HPER_MAIN_MTR, KELLER_HALL_MAIN_MTR, PHYSICAL_SCIENCE_KELLER_COMP_MTR, KENNEDY_THEATRE_MAIN_MTR, KRAUSS_HALL_MAIN_MTR, LAW_LIB_MAIN_MTR, LAW_SCHOOL_MAIN_MTR, LES_MURAKAMI_STADIUM_CONSESS_MTR, LES_MURAKAMI_STADIUM_MAIN_MTR, MARINE_SCIENCE_MAIN_A_MTR, MARINE_SCIENCE_MAIN_B_MTR, MARINE_SCIENCE_MCC_MTR, MILLER_HALL_MAIN_MTR, MOORE_HALL_MAIN_MTR, MUSIC_COMPLEX_MAIN_MTR, PBRC_MAIN_A_MTR, PBRC_MAIN_B_MTR, PHYSICAL_SCIENCE_MAIN_MTR, POST_CHILLER_PLANT_MAIN, POST_MAIN_1, POST_MAIN_2, QLCSS_MAIN_MTR, QUAD_CHILLER_PLANT_MAIN_MTR, SAKAMAKI_HALL_AC_EQPT_MTR, SAKAMAKI_HALL_MAIN_MTR, SAUNDERS_HALL_MAIN_A_MTR, SAUNDERS_HALL_MAIN_B_MTR, SHERMAN_MAIN_1_MTR, SHERMAN_MAIN_2_MTR, SPALDING_HALL_MAIN_MTR, ST_JOHN_PLANT_SCIENCE_MAIN_MTR, STAN_SHERIFF_CTR_MAIN_1_MTR, STAN_SHERIFF_CTR_MAIN_2_MTR, MULTIPURPOSE_BLDG_MAIN_MTR, WEBSTER_HALL_MAIN_MTR, WIST_HALL_MAIN_MTR|
