openpowerquality/opq/box/Schematics/v2/README.md

OPQBox 2 PCB design files
=========

Schematics and layout for OPQBox2.

**File List:**
- opqbox2.sch:  Mentor graphics PADS schematic of OPQBOX2.
- opqbox2.sch:  Mentor graphics PADS layout of OPQBOX2.
- opqbox2_schematic.pdf:  OPQBOX2 pdf schematic.
- opqbox2_library.pdf:  OPQBOX2 pdf layout.
- Gerbers: Manufacturing files.(gerbers, drill, pastemask)
- Library: PADS library
- BOM.txt: Bill of Materials
