openpowerquality/opq/box/images/OPQ2.6Power.png

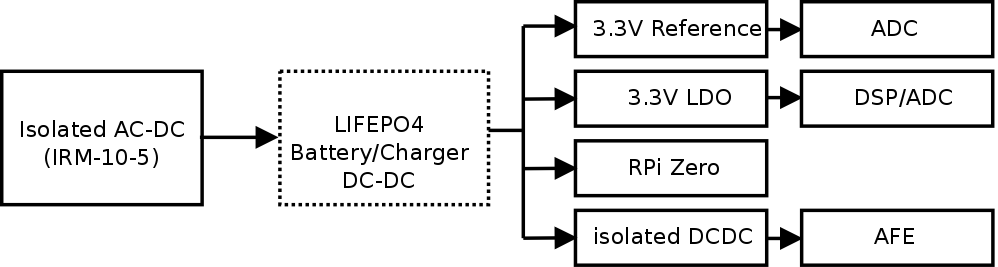
box/images/OPQ2.6Power.png
