openpowerquality/opq/box/Schematics/v3/opqbox3.png

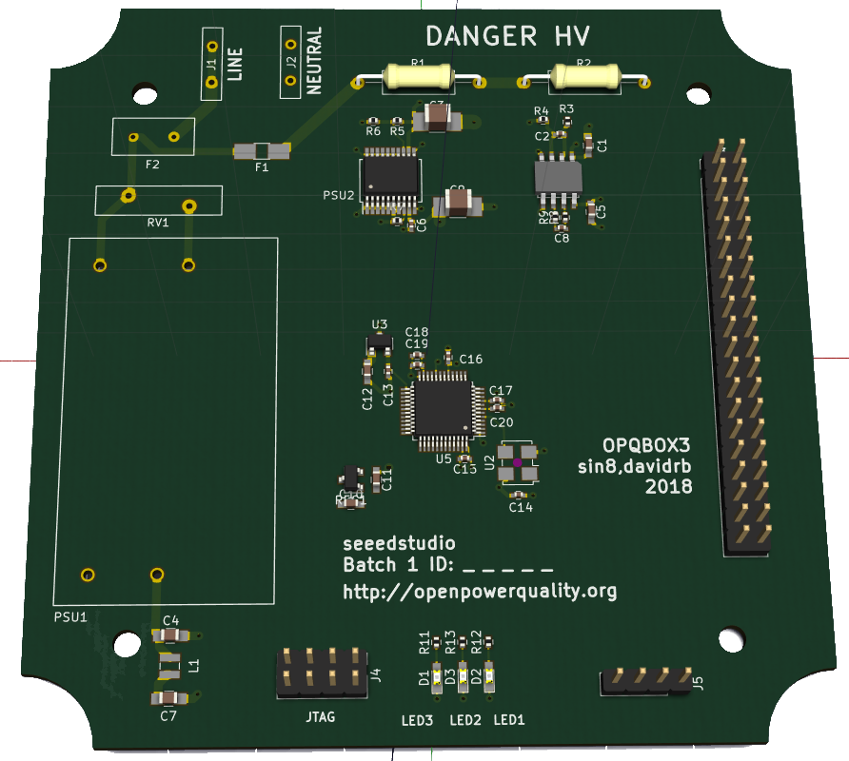
box/Schematics/v3/opqbox3.png
