openpowerquality/opq/makai/makai.png

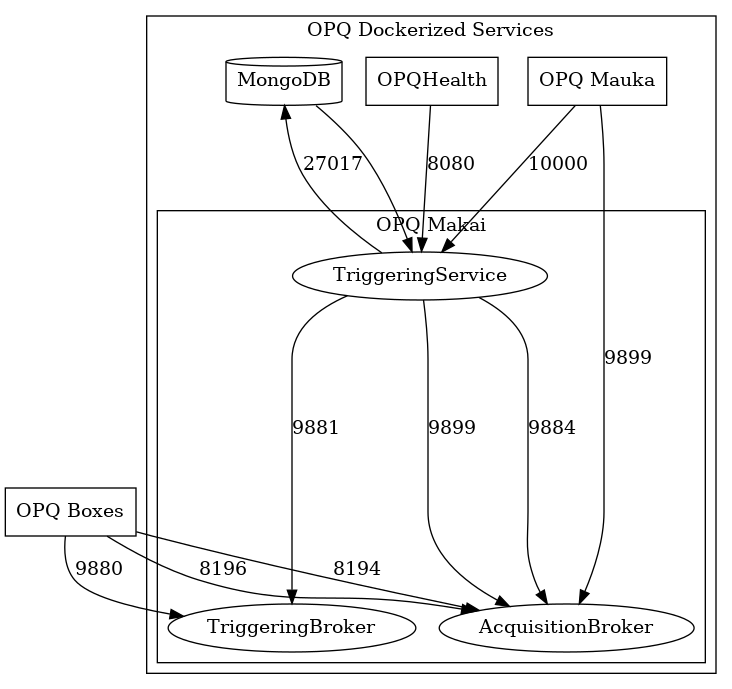
makai/makai.png
