openpowerquality/opq/util/reporting/opq_deployment.jpg

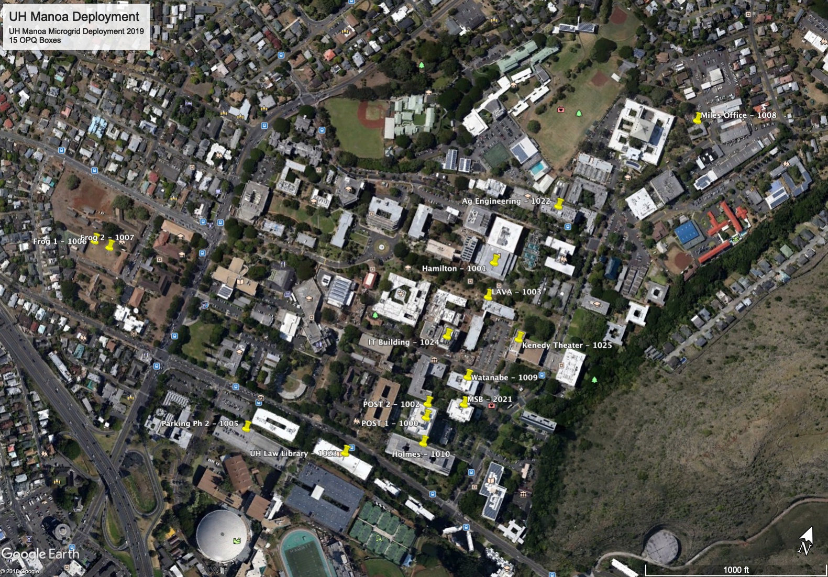
util/reporting/opq_deployment.jpg
