openpowerquality/opq/util/reporting/OPQ_Deployment_2019.png

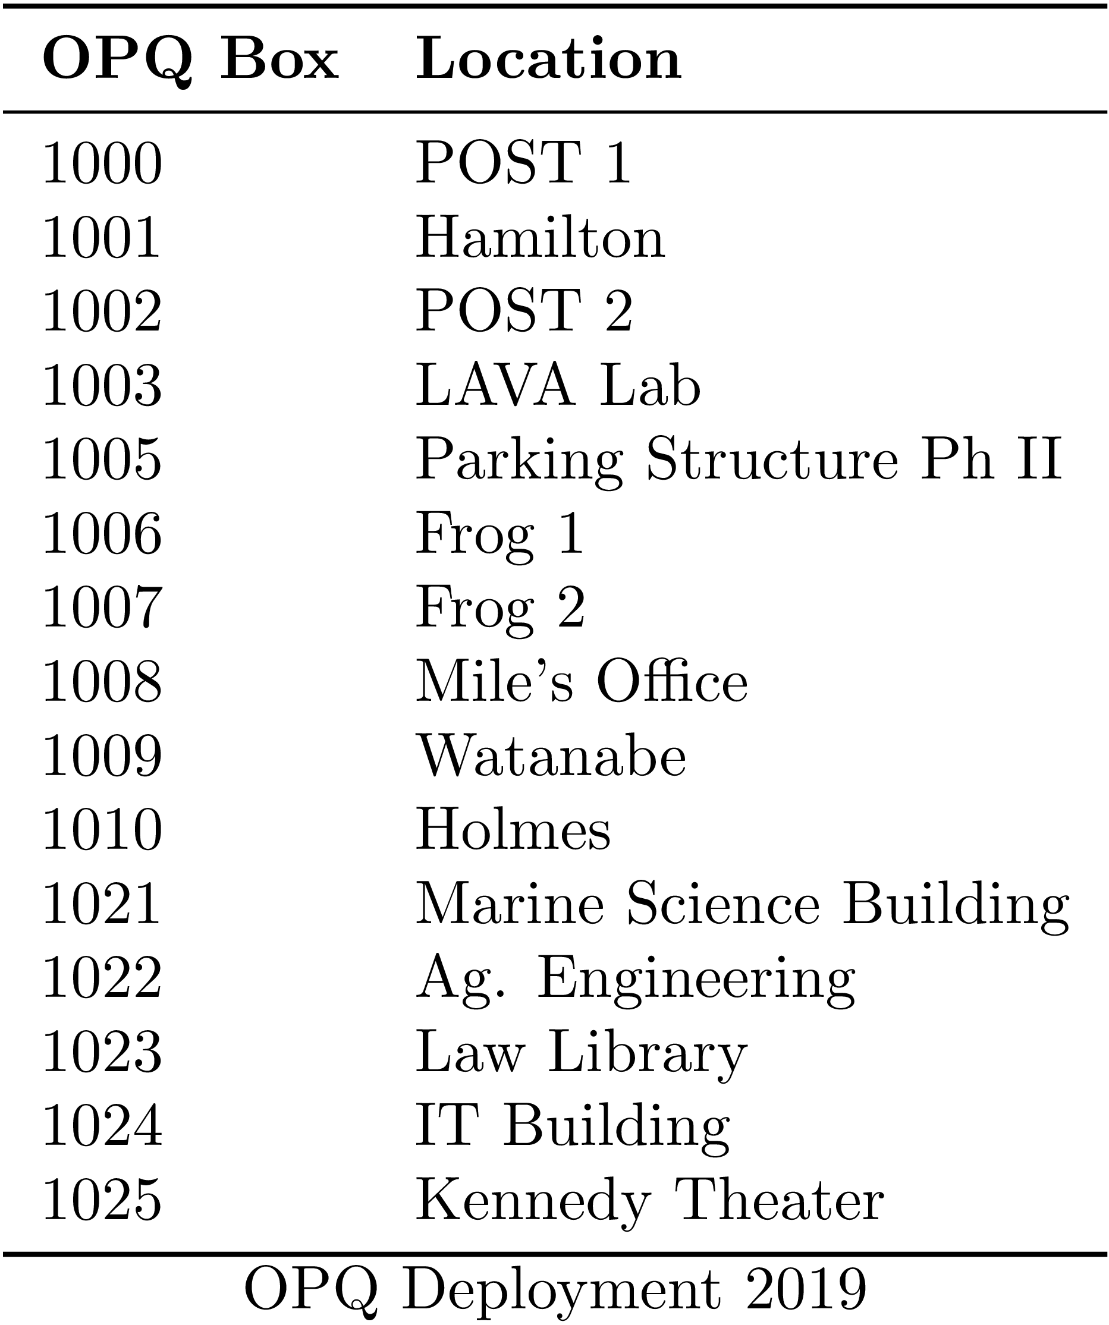
util/reporting/OPQ_Deployment_2019.png
