openpowerquality/opq/box/Mechanical/opqbox_box.dxf

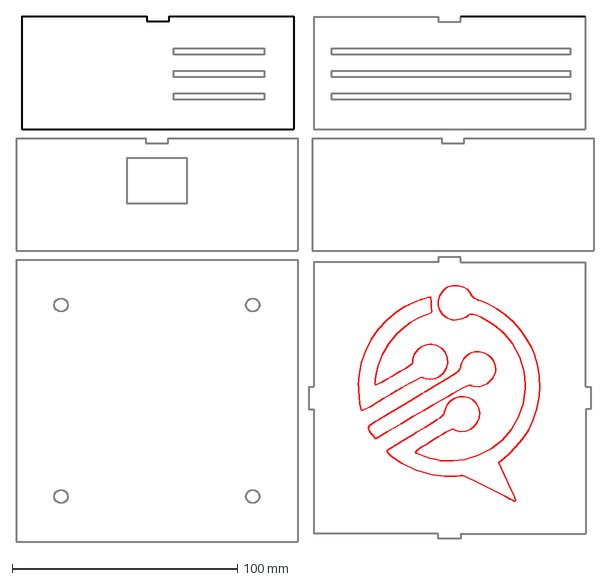
[picture p11: CAD file, 2017-09-06]
box/Mechanical/opqbox_box.dxf
256.4 x 233.1 mm
