openpowerquality/opq/(threads)

Thread 2 (2017-09-02):

Refactor user accounts model

aghalarp, 2017-09-02:
Please do work for this task in a branch called issue-2.

Basic authentication has already been implemented into OPQView using Meteor's built-in [Accounts package](https://docs.meteor.com/api/accounts.html). Custom login and signup templates have already been built using [Semantic-UI](https://semantic-ui.com/). Further discussion is needed to ascertain what the Users model will look like. Aside from basic user information (name, email, password, etc.), device ownership data should be stored here as well. However, it might make more sense to store actual device information in a separate Devices collection.

A quick note on Meteor's Account package and our usage of it:
The Accounts package provides a basic user authentication system, storing user data in a collection called Users. Our current implementation opts to not actually tamper directly with this Users collection - instead, we created a Persons collection (feel free to suggest a better model name) which stores all the relevant application-level user information. This allows us to more easily maintain a clear schema on the Persons collection, as the Accounts package (and subsequently the Users collection) is Meteor developed and prone to changes. With this approach, we can simply focus on maintaining our own custom user collection and let Meteor worry about the Accounts package.

Closed 2017-10-20.

Thread 3 (2017-09-02):

Implement DeviceRegistration Component

aghalarp, 2017-09-02:
Please do work for this task in a branch called issue-3.

Implement a device registration system that fulfills the following use case:

1. The user, having received a new OPQBox, goes to the device registration page where they must enter their device's serial number.

2. If the serial number is already associated with an account, then an error message is displayed.

3. If the serial number is not yet associated with an account, and it is a valid serial number, then the system requests an email address from the visitor.

4. Once an email address is supplied, the system generates an email to that address with a link that enables the user to register themselves as the owner of that device. Clicking the link enables them to specify a password.

5. They can then login with their email address and password.

philipmjohnson, 2017-12-19:
Single person "ownership" is complex to implement, because (a) you need to define an additional "viewer" role so that more than one person can see the same box, and (b) you need to define a way to change ownership.

I suggest that you replace the idea of single person "owners" with multi-person "viewers"; anyone with the serial number can become a viewer.

Along with this, instead of serial numbers being easily guessable small integers (5), we might want to start making them a somewhat longer string ("356-AB-23").

anthonyjchriste, 2017-12-19:
We currently publicly advertise the device id. I'm concerned that if all it takes is a serial number to subscribe  to the box, then it will be impossible to have secure boxes (assuming there is a use case for wanting to hide certain boxes).

We may want to differentiate between "box id" and "box serial number" if the box id is going to be displayed publicly.

philipmjohnson, 2017-12-19:
We don't have to publicly advertise the device ID with the following changes:

*  The Box entity has a "name", "location" and "description" field, that are user-configurable. The name field must be unique.
* When a box initially connects, OPQView assigns a default name based upon the timestamp of the first measurement, ie "Box-2017-12-16T16:32:32Z-10:00". This makes it possible for a new user to identify their box in the public listing of boxes.
* When the user connects to OPQView, they can enter the serial number to manage the name, location, and description fields. In particular, they could rename the box from the default name to something more description (yet still unique), i.e. "PJ-Kailua".

With this approach, we don't have to differentiate between box_id and box serial number.

aghalarp, 2017-12-20:
I've updated the [data model](https://open-power-quality.gitbooks.io/open-power-quality-manual/content/datamodel/description.html#opq_boxes) to reflect these ideas, mainly:

- box_id is now a string (previously integer)
- Added a "name", "description", and "location" field (an object with a "zipcode" sub-field) to the Box entity

Just to clarify (for myself) this entire process of hooking up a new box:

- A user receives a new box, which has an internal box_id that we've assigned to it. This box_id is no longer a simple integer but a more complex string.
- The user hooks the box up to their router, and Makai/Mauka starts receiving data from it (which includes its box_id)
- Makai/Mauka queries the "opq_boxes" collection and does not find an existing box with that box_id - therefore it creates a new box document and assigns it the default name as described above.
- The user logs on to OPQView, sees a public listing of boxes (by their "name" field), selects the box they are interested in and enters its box_id as if it were a kind of password. If the "password" is correct, we can then mark that user as having permission to access/view that box (see the "boxes" array in the "users" collection).
- The user is then redirected to some kind of device administration page in OPQView, where they can change its name, add a description, etc.

philipmjohnson, 2017-12-20:
Yes, that's how I see it as well.

philipmjohnson, 2018-03-08:
I am closing this issue because the current strategy is to use the MAC Address on the box as the "secret" used to authenticate a user as an owner.

Closed 2018-03-08.

Thread 4 (2017-09-02):

Implement device management interface

aghalarp, 2017-09-02:
Please do work for this task in a branch called issue-4.

A user initially registers their device using a separate device registration interface (See Issue #6 ).

A different user interface will be required for device management, allowing users to:
- View existing devices tied to their account
- Register new devices on their account
- Manage individual device information
  - Device label (so user doesn't have to keep track of serial numbers)
  - Device location  (zip code, so we have an approximate location on each device, while still providing a degree of privacy)
  - Device permissions
- View basic device statistics (device uptime, most recent heartbeat)

Use [Meteor-Roles](https://github.com/alanning/meteor-roles) package to manage device permissions.

philipmjohnson, 2018-02-21:
Will redo this issue.

Closed 2018-02-21.

Thread 8 (2017-09-18):

Rename Box ID key in events collection

aghalarp, 2017-09-18:
Please do work for this task in a branch called issue-8.

The data collection has a key named "Box ID" (with a space). We should rename this to boxId. As a convention, let's append any key that holds a Mongo id value with an "_id", and any key that holds a non-mongo id value with just "Id" using camelcase.

philipmjohnson, 2017-09-18:
I agree that you don't want spaces in field names.

I do not recommend that you distinguish between mongo IDs and other IDs using the case of the letter "I".  That is a recipe for endless mistakes!

Instead, if there are multiple kinds of IDs, make the naming scheme obvious by adding the system name.

So, instead of "Box ID", use boxMongoID or box_mongo_id or something similar.

sergey-negrashov, 2017-09-20:
As of 9531e6aac783874ddcc659ac127da22f542bb688 Box ID is now mongo_box_id.

aghalarp, 2017-09-21:
The "Box ID" field in question here is a non-mongo id (just an integer value we assign to our devices). Sorry for the confusion in my original post - I was just taking the opportunity to clarify naming conventions between mongo id fields and non-mongo id fields.

So let's just rename this to "box_id", indicating a non-mongo id field.

And to finalize our naming conventions:
Non-mongo id --> append field name with "_id"
Mongo id --> append field name with "_mongo_id"

aghalarp, 2017-09-21:
There is also another minor typo in the "events" collection.
"boxes_recieved" --> "boxes_received"

sergey-negrashov, 2017-09-21:
Fixed in commit 9531e6a.

Closed 2017-09-21.

Thread 17 (2017-10-21):

View: Synchronize event waveform data

aghalarp, 2017-10-21:
Please do work for this task in a branch called issue-17.

Event waveforms should be synchronized with one another to allow for more useful comparisons and analysis. In order to implement this, we must use each box's event start timestamp (stored in the data collection as data.event_start), as well as the box sample rate (1/12000s per sample).

Closed 2017-10-23.

Thread 26 (2017-12-06):

Implement landing page

philipmjohnson, 2017-12-06:
Please do work for this task in a branch called issue-026.

Here is a proposal for the contents of the landing page, which will consist of a set of "panes". You can use different background colors to distinguish different panes. See https://radgrad.ics.hawaii.edu for an example.

The top pane should indicate that you're at an OPQView instance with some configurable description of this instance (i.e. this is the instance maintained by the Open Power Quality group). This is a string that should be managed via a "config" collection accessed via admin mode. This pane also includes a login button.

The second pane provides locations of OPQBoxes registered to this system via a map. The default zoom level and center point for this map should also be managed via an admin config collection. OPQBox locations are not indicated by dropped pins, as they represent an exact location. Instead, locations should be indicated by circles about 500 meters in diameter, where the actual location of the OPQBox is randomly located within that circle. That should provide some level of privacy to owners.  The circles can be colored green (if the OPQBox heartbeat indicates a connection), yellow (if no heartbeat has been received recently), or red (if no heartbeat has been received for a long time).  The time thresholds for green, yellow, and red are managed in the admin config collection.

Adjacent to the map in this pane could be some descriptive statistics, including:
Total number of OPQBoxes registered to this server.
Total number of events.
Total number of registered users

The third pane provides information on events.  I think the best representation for this is some sort of zoomable timeline.  There are plenty of javascript timeline packages; make sure to find one that is currently maintained and under active development. We need to be able to characterize events as local or global, their intensity, their duration, and their importance.  And what is actionable about them.

The fourth pane provides information on synchronization. We want to know in near-real time how synchonized the various boxes are with each other. Not sure how to best indicate this.

The fifth pane provides information on conversations and annotations to PQ events. (Or perhaps this will be integrated into another pane.)

The final pane provides information on how to get involved with the project as a individual owner of an OPQBox, as a software or hardware developer, or as an institution.

philipmjohnson, 2018-02-21:
Divided up into individual tasks.

Closed 2018-02-21.

Thread 31 (2017-12-07):

Localization Plugin

anthonyjchriste, 2017-12-07:
Please do work for this task in a branch called issue-31.

Write a Mauka plugin that examines events with data and determines how local the event is.

Locality is defined as local which only a single sensors sees an event, semi-local which sensors within a neighborhood record an event, and global, in which multiple sensors outside of neighborhood see the same event.

We are currently looking at statistical methods for determining locality such a correlation and frequency binning.

Thread 35 (2017-12-13):

Test performance of Wavelet libraries on Raspberry PI

sergey-negrashov, 2017-12-13:
Please do work for this task in a branch called issue-XXX.

Thread 36 (2017-12-13):

Box Updater Code Review

anthonyjchriste, 2017-12-13:
Please do work for this task in a branch called issue-036.

- [x] Documentation on gitbook
- [x] print statements to log statements
- [x] Package name should be pulled from server, currently in json config
- [x] Setup script should install config file to /etc/opq/updater.json
- [x] Setup script should install deps and create a cron job
- [x] Rename config file to updater_config.json
- [x] Logging doesn't redirect to file properly (use &>> for crontab command)

Closed 2018-02-01.

Thread 38 (2017-12-18):

Migrate collected data to new data model

anthonyjchriste, 2017-12-18:
Please do work for this task in a branch called issue-038.

Migrate current OPQ data to new standardized data model. This will likely be performed offline on a copy of the OPQ DB to ensure no data is lost and that performance isn't negatively affected on the production server.

- [x] Backup data
- [x] Move backed up data to separate machine
- [x] Perform data migration
- [x] Move new collections back to production
- [x] Verify
- [x] Remove old data from production

sergey-negrashov, 2017-12-19:
Could you elaborate on where I can contribute here.

anthonyjchriste, 2017-12-19:
This is specifically for migrating the database to the new data models. If you want to help, you can see the steps outlined above in the issue. It's probably easier to perform this task locally though since the database export is going to be quite sizeable.

I would recommend creating a few issues for updating the box to the new data format first before we worry about migrating the old data.

Here's a link to David's updated data model . https://open-power-quality.gitbooks.io/open-power-quality-manual/content/datamodel/description.html

Closed 2018-01-18.

Thread 39 (2017-12-18):

Include THD as event type

anthonyjchriste, 2017-12-18:
Please do work for this task in a branch called issue-039.

Currently mauka only recognized voltage and frequency events even though it can classify THD events. Update mauka so that is also recognized THD events and stores those events in the DB correctly.

Closed 2018-01-18.

Thread 40 (2017-12-18):

Update API collections to match new OPQ data model

aghalarp, 2017-12-18:
Please do work for this task in a branch called issue-40.

The updated data model can be found here: https://open-power-quality.gitbooks.io/open-power-quality-manual/content/datamodel/description.html

aghalarp, 2018-01-19:
This has been completed by issue #24, which has been merged to master now.

Closed 2018-01-19.

Thread 42 (2017-12-18):

Fix timestamp calculations in raw waveform calculations.

anthonyjchriste, 2017-12-18:
Please do work for this task in a branch called issue-042.

Currently timestamp calculations assume that sampling frequency and timestamps are in the same time base (i.e. Hz and seconds). However, the timestamps are actually milliseconds which means that our timestamps should be generated using mHz. Currently, ITIC and THD calculations make use of this and may be reporting incorrect start and stop times.

- [x] Fix issue
- [x] Update on previously collected data to fix any errors

anthonyjchriste, 2017-12-19:
It turns out that THD and ITIC plugins currently do not need to generate a list of timestamps for each sample since no plotting it currently taking place in any of the plugins. This issue has only affected the plots for the storm report.

Closed 2017-12-19.

Thread 45 (2018-01-02):

Configure oplog for purely reactive data source

anthonyjchriste, 2018-01-02:
Please do work for this task in a branch called issue-045.

The current Mongo database is not setup to provide reactive updates via its oplog. Mongo should be configured so that it creates and writes to an oplog. This oplog will then provide reactive data updates to OPQView, eliminating the need to constantly poll the DB.

philipmjohnson, 2018-03-30:
Duplicate of #92, which provides more detail.

Closed 2018-03-30.

Thread 51 (2018-01-11):

Figure out long term data storage policy for measurements.

anthonyjchriste, 2018-01-11:
Please do work for this task in a branch called issue-051.

sergey-negrashov, 2018-01-12:
Added daemon for storage data and expiring it after 24 hours. Need to add a filter for long term data retention.

sergey-negrashov, 2018-01-17:
issue-51 branch contains the migrated makai

sergey-negrashov, 2018-01-18:
We are up and running with the new measurement schema

Closed 2018-01-18.

Thread 57 (2018-01-18):

Update OPQView Installation guidelines

philipmjohnson, 2018-01-18:
Please do work for this task in MASTER branch.

Edit the OPQView [installation section](https://open-power-quality.gitbooks.io/open-power-quality-manual/content/view/installation.html) to explain to developers how to bring up the system. This should extend the current section with:

* Describing the presence and location of fixtures and snapshots. (Let's use those terms.)
* Describing how to update the settings.development.json file to specify fixtures and snapshots.
* Describing how to enable/disable integrity checking on startup.

Any other comments that a novice developer needs to get started.

Closed 2018-03-30.

Thread 59 (2018-01-22):

Difference between event_start_timestamp_ms and event_end_timestamp_ms is incorrect

anthonyjchriste, 2018-01-22:
Please do work for this task in a branch called issue-059.

In the "box_events" collection, the difference between the start and end timestamps are always 150. This means I can not use these fields to calculate the duration of an event and can only do so by loading all the files and counting the samples. This takes forever.

Please fix the event_end_timestamp_ms so that is represents the time of the last sample of the waveform. If can, please update all box_events in collection.

sergey-negrashov, 2018-01-26:
fixed in 60af55f

Closed 2018-01-26.

Thread 61 (2018-01-25):

Create react hello world OPQView

philipmjohnson, 2018-01-25:
Please do work for this task in a branch called issue-61 that is branched off of the react-reimplementation branch.

Create a react-based OPQView that shows the total number of Trend documents. There should be no Blaze in this codebase.

Use Pup for inspiration on how to set up the global layout, page, component structure.

Use Semantic-UI react for the UI framework.

Closed 2018-02-01.

Thread 62 (2018-01-26):

OPQBox V3

sergey-negrashov, 2018-01-26:
Please do work for this task in a branch called issue-62.
This is a task list for OPQBox3:
**Prelude:** We need to evaluate a replacement for RPi Zero W, and pick a stable KiCad version for this design.

- [x] Evaluate C.H.I.P. Pro SBC. **Vendor contacted.**
- [x] Pick a KiCAD version for development.  **We will be using KiCAD 4.0.***
- [ ] Find a new vendor for SBC. (on board WiFi; see Serge for other specs.)

**Schematics:** We need to create and commit the OPQ KiCAD libraries containing OPQBox3 component decals. Next we will migrate the schematics form Pads Schematic Tool to KiCAD.

- [x] Create/Import component decals.
- [x] Migrate schematics to KiCAD.
- [x] Schematic Design Review.

**Layout:** We need to create and commit the OPQ KiCAD libraries containing OPQBox3 component footprints. Next we need to pick an enclosure to fit the new design. Finally we will migrate the layout form Pads Schematic Tool to KiCAD.

- [x] Import the minimal feature size for vias and traces for Seeedstudio service into layout tool.
- [x] Pick a UL listed enclosure.
- [x] Layout High Voltage section.
- [x] High Voltage Design Review.
- [x] Layout Low Voltage.
- [x] Low Voltage Design Review.

**Final Review:** We will perform the final review of the PCB and Schematics and perform DFM.

- [x] Final Review for Schematics
- [x] Final Review for Layout
- [x] Final Review for Mechanical
- [x] Design for Manufacture checks.
- [x] Have Garmire take a look

**Documentation:** We will update the documentation for the new design.
- [x] Update Gitbook Documentation

**Manufacture** We will generate Manufacturing files and ship the PCBs for pilot assembly.

- [x] Gerber generation
- [x] Drill File generation
- [x] Component location and footprint

sergey-negrashov, 2018-01-26:
I contacted sales regarding CHIP Pro evauation:
https://getchip.com/pages/chippro

Closed 2018-05-29.

Thread 66 (2018-02-12):

Re-implement makai reader

evan-hataishi, 2018-02-12:
- [x] Create cmake file
- [x] Implement class to subscribe to boxes
- [x] Read/print box measurements
- [ ] Create data structure to store uptime/downtime

philipmjohnson, 2018-02-12:
Evan: Please provide a description for this issue with an outline of the steps you need to take to accomplish this task. Thanks!

Closed 2018-02-22.

Thread 67 (2018-02-21):

Implement BoxManager Component

philipmjohnson, 2018-02-21:
Please do work for this task in a branch called issue-67.

A user must be able to manage an OPQ Box. This involves:

 * View existing boxes tied to their account
 * Register new boxes to their account
 * Edit Box label (so user doesn't have to keep track of serial numbers)
 * Edit Box location (zip code, so we have an approximate location on each device, while still providing a degree of privacy)
 * Edit Device permissions
 * View basic device statistics (device uptime, most recent heartbeat)
  * Manage its location
  * Manage its nickname
  * Manage whether it is online or offline
  * Manage whether its data is public or private.  Public means the data appears on the landing page and in all other user's pages.  Private means only owners can see the box and/or its data, and only after logging in.

philipmjohnson, 2018-03-30:
I'm going to close this for now.  We have basic box and user management via the settings file.  Use of MAC address authentication is deferred for this milestone.

Closed 2018-03-30.

Thread 69 (2018-02-21):

Implement BoxMap Component

philipmjohnson, 2018-02-21:
Please do work for this task in a branch called issue-69.

Upon logging into OPQView, users will have a link in their Navbar to a page called "Box Map".  This page contains a single component called BoxMap. The component subscribes to the OPQBox collection, from which it obtains the latest location data for all of the boxes owned by this user.

The component then uses a React-based Mapping facility ([react-leaflet](https://react-leaflet.js.org/)?) to display the latest location of each box.

Some design issues:

*Location representation*:  We want to be flexible regarding the way location data is specified. By default, we currently specify location with a zip code.  However, for the [Agile Power Monitoring Project](http://openpowerquality.org/projects/agile-power-monitoring.html), we will want to specify boxes with much greater precision so that the map can show the locations of boxes within buildings on campus. So, the Box Map component should be able to handle either zip code or lat/long coordinates. We will need to update the OPQBox data model to specify how lat/long data can be provided as an alternative representation for location.

*Location lookup*: It appears to be unnecessary to build in a lat-long finder.  Users can be directed to any of a number of public websites (for example, [https://www.latlong.net/](https://www.latlong.net/)) to obtain the lat/long coordinates for a particular location.

*Box Data*: It would be nice to provide a little bit of data about the box.  Minimally, the marker associated with the box can provide as a pop-up the box's name, description, and the nickname associated with the last location.  It could also specify its health status (up, down, unplugged). For more detail, the user should go to another component.

aghalarp, 2018-04-04:
[React-Leaflet](https://react-leaflet.js.org/) looks like the way to go for this. Well maintained and good documentation.

aghalarp, 2018-04-04:
The other issue is location lookup. This can be taken care of with a geocoding/geosearching plugin - and fortunately for us, there is a plethora of leaflet plugins available for this. This one seems like a particularly solid choice: [Leaflet-Geosearch](https://github.com/smeijer/leaflet-geosearch)

Testing out the demo app, the geosearching capabilities seem quite versatile, as it can retrieve lat-lng data for just a single zipcode, as well as accurate lat-long for full addresses (which we don't need for now, but still good to know!).

philipmjohnson, 2018-04-04:
Built-in location lookup is probably not necessary.  Please see my edited issue description.

anthonyjchriste, 2018-04-04:
Here's an open source list of every zip code and its lat/lngs https://gist.github.com/erichurst/7882666. I say we import it into mongo, index the zipcode, and have instant lookups in mongo as it will basically be one big hash table.

I can do that if anyone is interested.

philipmjohnson, 2018-04-04:
For converting a US zip code to lat/long for use by the map library, I like the idea of a mongo collection. Super simple.

For providing fine-grained lat/long data (building-level), I like the idea of an external public website.

philipmjohnson, 2018-05-16:
Future work on this component will be done as part of #118.

philipmjohnson, 2018-05-31:
Great work on this component, David!  Here are some enhancement requests for better integration with the system:

1. Yes, please go ahead and add an optional initialBox prop to the Measurements and Events components to indicate the box to display. That will make your button on the page more helpful.

2. Please remove the button that takes the user to the editBox page from the BoxMap component. The reason is that only admins can edit box info, and I definitely want users to see the BoxMap component. (Making it conditionally appear when the user is the admin role complicates the interface and doesn't add enough benefit.)

3. Most importantly, please switch from using the Measurement collection to the Trend collection for obtaining current voltage, frequency, and THD data. I know that the UI will be a little less cool as a result, but I expect that the BoxMap component will be very popular and I am very concerned about the additional load on both clients and servers from this amount of data.  Consider what happens when there are 500 deployed boxes and the component is thus requesting and processing Measurement data from all of those boxes.  I very much doubt the component (or even the server) could handle that. Furthermore, there's really no use case where a regular user needs to know real-time PQ information for every single box simultaneously. A more reasonable scenario is the desire to know real-time info for a single box, and we have the Live Measurement component to provide that. By switching from Measurements to Trends, the component should be able to scale to lots of boxes and remain responsive without any usability impact.

I will try to do a code walkthough in the next few days and if I have any comments, I will add them here. This feedback is just based on UI review.  Note these are very minor corrections; overall you did an amazing job!

philipmjohnson, 2018-05-31:
Upon further reflection, the simplest and most efficient solution is for BoxMap to subscribe to the SystemStats collection. This will send update exactly one document about every 10 seconds, and the box_trend_stats field will provide the most recent Trend document for each box.  What's great about this solution is that the load on the client is basically constant regardless of the number of boxes, and we can move the latency up and down by adjusting the cron job underlying SystemStats.

philipmjohnson, 2018-06-01:
As I documented the System Stats collection in the data model chapter (https://openpowerquality.org/docs/cloud-datamodel.html#system-stats), I realized that it doesn't yet provide the right kind of information for BoxMap. I suggest you go ahead and fix that as part of issue-69.  I suggest you simply edit [System Stats Collection](https://github.com/openpowerquality/opq/blob/master/view/app/imports/api/system-stats/SystemStatsCollection.js) to add a new field to the document called, say, "latest_box_trends", which would be an array of the most recent Trend document associated with each defined Box.

Then you can subscribe to the System Stats collection and get the most recent min, max, or average voltage (or frequency, or THD). It will only update once a minute, but that seems reasonable.

If you really wanted to make sure the numbers change every 10 seconds, then you could provide a field called "latest_box_measurement", which is just like the above, only it has an array of the most recent Measurement documents, not Trend documents.  The overhead is no different.

philipmjohnson, 2018-06-01:
I was about the delete the ZipCode collection from the view api/ directory and decided to do a search to see if anyone was using it. It appears that it's used in BoxMap.  I think it would be good to take it out.  If the users want to associate locations with zip codes, they can just define a region. But I don't see any purpose in calculating zip codes based on lat/long values for OPQ View.  I think this is an opportunity to make the code more simple without any negative user impact.

aghalarp, 2018-06-01:
Thanks for the feedback! I do have a question/thought regarding Regions:

Would there be any benefit in defining an enumeration of allowed ‘region types’, and then adding a ‘regionType’ field to the Region collection? This seems like it would be a potentially useful addition, as it would allow us to query a subset of Region documents based on a type, be it ’state’, ‘city’, ‘zipcode’, ‘building’, perhaps even ‘power grid’ or ‘substation’. Since Regions are just an abstract representation of a set of Locations, we now have a very versatile way to organize our Locations. Being able to query on a region type would then allow us to aggregate our OPQBox data in a new way, essentially giving us the ability to group boxes by a certain type of location granularity. I can see this being useful in OPQView, and my gut feeling is that it could also be potentially useful for analytics/research in OPQMauka/Makai. More data the merrier, right?

In terms of usefulness for OPQView, and more specifically the Box Map component, what this means is that we can allow the user to change the ‘Box Location Granularity’ (one way to put it), and the box markers will change positions on the map based on the selected Region Type.

What would be the benefit of re-positioning boxes on the map? It’s related to the Leaflet marker clustering plugin (https://github.com/Leaflet/Leaflet.markercluster).
Since clusters calculate the average live box data value of all child markers contained within it, by clustering all boxes into their respective regions (be it state, zipcode, substation, building, etc.), we can have a wide variety of ways to organize and monitor box data. I think it could be another interesting way to interact with the Box Map.

The code is basically already implemented on master. See the ‘Data Display’ button on the top-right corner of the map, and change the ‘Box Location Granularity’ from ‘Exact Location’ to ‘Region’. The ‘Exact Location’ option positions boxes by their location coordinates, while the ‘Region’ option positions boxes based on their region coordinates. And that brings me to the one caveat - in order for this to be useful, we would need to also associate a lat-lng coordinate with a region. Currently, this works because all Regions just happened to be zip code representations, and we just happened to have a handy ZipCode collection available that maps every US zipcode to its respective lat-lng coordinate.

At the end of the day, it might just not be worth the trouble for you guys. It all just depends on how valuable you all think having a ‘regionType’ field might be. Thoughts?

philipmjohnson, 2018-06-02:
David: Glad to see you're back on board, even if it's only temporary!  Your work is bringing up lots of useful things to discuss.

###  Region representation

If I understand you correctly, your idea is to provide alternative "partitionings" for a given geographic area. So, for example, we could partition the island of Oahu by zip code.  Or,  by city.  Or, by ahupua'a.  Or, by substation. And so forth.  The region type (zipcode, city, ahupuaa, substation) would indicate which kind of partition to use.

I think this is a cool idea in concept, but it adds nontrivial complexity. I think we should hold off until we have more evidence that we can actually take advantage of this kind of representation.

### Simplifying the UI

I'd like to try to simplify the UI.  First, can we get rid of the "Data Display" button in the upper right corner? Instead, I propose that we put all the information either in the display associated with the box or in the popup that appears when you click on a box.  Instead of showing just the voltage, and making the user click a radio button to show frequency or THD instead, why not show all of Voltage, Frequency, and THD in the display of a box?

Second, there are currently two ways to get Box Details: either by clicking the box itself or by clicking on an icon in the "box legend" area.  Let's get rid of the icon approach so there's just one way.

Third, I don't think that showing the average voltage is meaningful for aggregations of boxes. Maybe just show a number indicating the number of boxes in the circle, and then the user can click on it to zoom in and see the actual values associated with individual boxes?

### Parameterizing the UI

Related to the above, as we further develop the processing sophistication of OPQ, we will want to change the data shown with the display of a box.  For example, at some point, we will want to show the "current Incident" associated with a box (if any). So, please design the box display component with the idea that it should be as easy as possible for another developer to come in and change what data is displayed and how it is formatted. Because they definitely will want to do that at some point!

### Testing, Part 1

It would be nice to provide some unit and/or integration tests for your code.  I have just updated the documentation today with additional information about testing in OPQ View. Please take a look:

https://openpowerquality.org/docs/cloud-view.html#quality-assurance

### Testing, Part 2

I recently rewrote some code to make it more amenable to testing.  It brings up some general design issues that I think you will find interesting. First, here's the original code:

https://github.com/openpowerquality/opq/blob/master/view/app/imports/api/trends/TrendsCollection.methods.js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

As I note in the comment, this code was unnecessarily hard to understand, debug, and test. To improve it, I moved the code into the Trends class definition and refactored it into a set of smaller and simpler methods, each of which became amenable to unit testing.  The new implementation is here:

https://github.com/openpowerquality/opq/blob/master/view/app/imports/api/trends/TrendsCollection.js#L84-L161

The associated unit tests are here:

https://github.com/openpowerquality/opq/blob/master/view/app/imports/api/trends/TrendsCollection.test.js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

And the associated integration test is here:

https://github.com/openpowerquality/opq/blob/master/view/app/imports/api/trends/TrendsCollection.methods.app-test.js

It turns out that by refactoring the original monolithic Meteor Method into a set of class methods (and by judicious use of underscore), I was able to reduce the number of lines of code almost by half. (To be fair, the original nested loop implementation is a bit faster, but at this point I prefer the gains in readability and reduction in code size.)

So, the morals of this particular story are:

  * OPQ now has good support for unit testing and integration testing.  Try to take advantage if possible.
  * Try to keep Method Methods short and uncomplicated. Move complex processing to the class implementation because you can then refactor into multiple methods and also create unit tests to verify (and document!) the workings of the sub-methods.

### Trends, not Measurements

The more I think about it, the more I like the idea of SystemStats containing just recent Trends, not Measurements. It lowers processing overhead without any disadvantage to the user.

aghalarp, 2018-06-02:
**Region Representation**
'Partitioning' is a good term for it. My initial thought process was more simple: I wasn't sure how useful having a single 'regionSlug' string field would be unless we could also have a way of indicating what kind/type of region this document was representing. I do understand now that the Region collection is just a many-to-many relation to the Locations collection - it's very useful in that regard. If we ever decide to expand on the Region collection in the future, perhaps consider adding a 'type' field. But I agree with you in regards to adding nontrivial complexity - hold off until we have a stronger need for this.

**Simplifying the UI**
I pretty much agree with your assessment here. I should mention that the initial reasoning behind only displaying one box measurement type at a time (voltage, frequency, thd), was that I was thinking ahead about adding heatmap overlays, or other kinds of data-driven map overlays. I remember chatting with Anthony or Serge about this a long time ago, and how we could use measurements/trends to generate a live heatmap of our box data. There are all sorts of interesting plugins within the Leaflet ecosystem - and I was hoping to start exploring these once I finished working on the Box Map component.

**Parameterizing the UI**
This is a great idea - but just to clarify on your terminology, when you say the 'display of the box', are you speaking of the box marker and its label (currently containing the box name and selected measurement?). If so, I should be able to easily refactor my code to make this configurable.

**Testing**
I know you've been busy setting up the testing framework for OPQView and I definitely want to contribute here, so thanks for the rundown. I'll try to emulate your examples as I begin to write my own unit tests.

philipmjohnson, 2018-06-03:
Just noticed that if I run OPQ View with `meteor npm run start` (without connecting to the public database) I get the following in my shell console:

```
Exception from sub box_map_measurements id XvGWXyxupXtvkcQPE TypeError: Cannot read property 'timestamp_ms' of undefined
I20180603-09:14:42.253(-10)?     at Subscription._handler (imports/api/measurements/MeasurementsCollection.js:61:24)
```

And the following in my browser console:

```
errorClass
details
:
undefined
error
:
"Zipcode not found."
errorType
:
"Meteor.Error"
isClientSafe
:
true
message
:
"[Zipcode not found.]"
reason
:
undefined
stack
:
"Error: [Zipcode not found.]↵    at Connection._livedata_result (http://localhost:3000/packages/ddp-client.js?hash=a547928b29e722e419948bbc25e954f2c268a1c3:1963:25)↵    at Connection.onMessage (http://localhost:3000/packages/ddp-client.js?hash=a547928b29e722e419948bbc25e954f2c268a1c3:2157:14)↵    at http://localhost:3000/packages/socket-stream-client.js?hash=55bf4fc2eb00d41c79827f8ec3b3949bbec01ce1:261:13↵    at Array.forEach (<anonymous>)↵    at ClientStream.forEachCallback (http://localhost:3000/packages/socket-stream-client.js?hash=55bf4fc2eb00d41c79827f8ec3b3949bbec01ce1:355:33)↵    at SockJS.socket.onmessage (http://localhost:3000/packages/socket-stream-client.js?hash=55bf4fc2eb00d41c79827f8ec3b3949bbec01ce1:260:18)↵    at SockJS.REventTarget.dispatchEvent (http://localhost:3000/packages/socket-stream-client.js?hash=55bf4fc2eb00d41c79827f8ec3b3949bbec01ce1:645:22)↵    at SockJS._dispatchMessage (http://localhost:3000/packages/socket-stream-client.js?hash=55bf4fc2eb00d41c79827f8ec3b3949bbec01ce1:1824:10)↵    at SockJS._didMessage (http://localhost:3000/packages/socket-stream-client.js?hash=55bf4fc2eb00d41c79827f8ec3b3949bbec01ce1:1890:16)↵    at WebSocket.that.ws.onmessage (http://localhost:3000/packages/socket-stream-client.js?hash=55bf4fc2eb00d41c79827f8ec3b3949bbec01ce1:2048:15)"
__proto__
:
Error
```

Please be sure that the BoxMap component behaves "reasonably" when run in standard development mode.

aghalarp, 2018-06-03:
Good catch - I've been solely relying on the public database during development and I overlooked this. For the ZipCodes collection, it looks like we'll be getting rid of that altogether - but what is your recommended/preferred approach here in general, for components that might rely on collections only available on Emilia - such as the Live Data component? Should we output an error message in the UI, or just allow the component to 'run' without any input data (such as measurements)?

philipmjohnson, 2018-06-03:
The component should try to do something reasonable in the event that data it wants is not available. In the case of the boxmap component and missing measurement data, it can show the location of all known boxes on the map, but if measurement (actually Trend) data is not available, then it could show something like "Frequency: N/A" in the interface.

In many cases, the UI should not interpret the lack of data as an error. That said, I can think of certain cases in which missing data should be interpreted as an error!  For example, say you retrieve the location slug for a box, and then can't find that slug in the Locations collection when you go looking for the lat/long coordinates. That should trigger an error, because it indicates an integrity problem in the database.  But that should almost never happen.

aghalarp, 2018-06-11:
**General Changes**
- Switched from Measurements to SystemStats
    - The SystemStats collection now has a ‘latest_box_trends’ that contains the latest trend document for each OpqBox
- Removed the Data Display button from the map
- Removed EditBox button link from Box Legend
- Can now only filter boxes by Regions (removed filter by Location since it did not really serve any purpose)
- Removed all instances of the ZipCode collection being used by the BoxMap component.
    - Did not yet delete the ZipCode collection itself, wanted to leave this to you.
- Added an ‘initialBoxIds’ prop to the Live Data and Event Inspector components. The two buttons on the box legend will now link to these two components with the initial box pre-selected. Linking to another component with props wasn’t completely trivial and required me to have a better understanding of how React-Router works. See [issue-146](https://github.com/openpowerquality/opq/issues/146) for implementation details/discussion.
- The BoxMap component should run more reasonably when data is not available (ie. not connected to Emilia).

**Parameterizing the UI**
- I put a good amount of thought into how to best design this so a future developer can easily make changes to the map without having to invest a lot of time into figuring out the inner-workings of Leaflet and the marker-cluster plugin that we are using.
- There are two components to be aware of: the BoxMap component itself, and the OpqBoxLeafletMarkerManager component (I’m bad at naming things!) - which is a child component of the BoxMap. The purpose of this latter component is to encapsulate all the code related to the creation, management, and customization of box markers on the map.
- I realized that there are 4 aspects of the map markers that future developers might be interested in customizing:
    - The box marker label display
    - The box marker popup contents
    - The inner cluster label
    - The side cluster label
- To make it as easy as possible to customize these, the OpqBoxLeafletMarkerManager component accepts a set of callback props for their creation. See the below image for details.
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
- By using these callbacks, it should be pretty trivial to customize the contents of any of these labels. For example, this is the callback that we define (and pass to the markerClusterLabelFunc prop) to display the box count in each cluster (it’s quite simple!):
```
createClusterBoxCountLabel(clusterBoxIds) {
    const boxCount = clusterBoxIds.length;
    return `<div style='font-size: 26px;'><b>${boxCount}</b></div>`;
}
```
- When you run the BoxMap on branch issue-69, I’ve included code to demonstrate these four callbacks in action. They do not all have to be used, of course - I just wanted to demonstrate usage for your code review.
- In the future, if we wanted to allow the the user to change the contents of ANY of these labels on demand, all you would have to do is pass the selected callback to the OpqBoxLeafletMarkerManager props.
- FYI: All of these label contents will change reactively, should they contain reactive content.

philipmjohnson, 2018-06-14:
Bravo! Just took a quick skim through the code and it looks great!  The only, totally minor thing I can see at first glance is the lack of jsdoc-style comments for each function and method.  Eventually, I want to use something like [esdoc](https://esdoc.org/) to generate code-level documentation for view.  When or if the fancy strikes you, you could do a documentation pass, but there's no hurry and the code is pretty easy to understand.

I am intrigued by a couple of things I saw, such as Lodash.flowRight, so you've piqued my interest in some language constructs I hadn't seen before. Well done!

philipmjohnson, 2018-06-23:
Just noticed that the BoxMap component "clips" the Admin dropdown menu from the NavBar:

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

Note that I can still select the "hidden" items in the dropdown by clicking in the appropriate place in the boxmap...

aghalarp, 2018-06-23:
I've pushed a fix to master; it was just a z-index conflict between the dropdown menu and the Leaflet map.

Closed 2018-06-23.

Thread 70 (2018-02-21):

Implement SystemStats Component

philipmjohnson, 2018-02-21:
Please do work for this task in a branch called issue-70.

This component provides descriptive statistics, including:
 * Total number of OPQBoxes registered to this server.
* Total number of events.
* Total number of registered users

Note that there should be 3 significant digits per number. Use "K" for thousands, "M" for millions. So 14567 becomes 14.6K and 1234567 becomes 1.23M.

The current one is too big and is perhaps not responsive:

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

Closed 2018-03-21.

Thread 71 (2018-02-21):

Implement EventsTimeline Component

philipmjohnson, 2018-02-21:
Please do work for this task in a branch called issue-71.

This component provides information on events. I think the best representation for this is some sort of zoomable timeline. There are plenty of javascript timeline packages; make sure to find one that is currently maintained and under active development. We need to be able to characterize events as local or global, their intensity, their duration, and their importance. And what is actionable about them.

Closed 2018-04-04.

Thread 74 (2018-02-21):

Implement LandingPage Component

philipmjohnson, 2018-02-21:
Please do work for this task in a branch called issue-74.

Holds all the components for the Landing page.

Closed 2018-03-29.

Thread 75 (2018-02-21):

Implement EventDetail Component

philipmjohnson, 2018-02-21:
Please do work for this task in a branch called issue-75.

This component provides details about a specific event. For reference purposes, here is an event detail from the current UI:

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

Some things that could be improved:

  * Start time/End time formatting
  * Provide device nickname, not just ID.

philipmjohnson, 2018-05-10:
Serge wants CSV. So give it to him.

Event inspector can have a button that user must push to get the waveform.

Thread 76 (2018-02-21):

Implement live data monitoring

philipmjohnson, 2018-02-21:
Please do work for this task in a branch called issue-76.

Upon logging in, the user will have a link added to their navbar called Live Data.  Clicking this link takes them to a page called LiveDataManager, which contains two components: LiveTrendDataManager, and LiveMeasurementDataManager.

### LiveTrendDataManager

The LiveTrendDataManager component subscribes to the OPQBox collection, so it knows the boxes that are owned by this user.

The LiveTrendDataManager component presents a form to the user that enables them to set up live monitoring of the Trend data stream.  The form displays each of the boxes owned by the user, and checkboxes that enable the user to indicate whether they want to monitor frequency, and/or voltage, and/or THD for each box. (They can specify none of these, in which case the box will not be monitored).

The form also enables the user to specify the "window": the time interval for live Trend monitoring. The window has the following options:
  * 1 hour
  * 1 day
  * 1 week

When the form is submitted, the result is to render a component called LiveTrendDataDisplay, passing parameters into its withTracker HOC that parameterize the Trend subscriptions appropriately .

LiveTrendDataDisplay uses [react timeseries charts](http://software.es.net/react-timeseries-charts/#/) to display the Trend data.

Since Trend data comes with max and min values for each one minute interval, the visualization should include the average, max, and min values, updated automatically each minute.  Given appropriate subscriptions, this should happen automatically.

From the Live Trend Data page, it should also be possible to access the raw Measurement stream for a box. Note that this is a high overhead operation, since Measurements are generated six times a second. So, clicking a button associated with a box on this page

### LiveMeasurementDataManager

Measurement data is generated six times a second, so it is very high overhead to transmit this data to a client and display it.  Nevertheless, it should be possible to specify a single box for Live Measurement Data display. Upon submission of this form, a component called LiveMeasurementDataDisplay will be rendered, its withTracker HOC being passed about which box to be displayed, which will be passed into the subscription call.  Only 5 seconds of data are displayed at a time (30 data points).

See the [react timeseries real-time example](http://software.es.net/react-timeseries-charts/#/example/realtime) for one way to display this data.

### Reference

For reference purposes, here is the old monitor:

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

Closed 2018-04-24.

Thread 77 (2018-02-21):

Implement BoxTrends Component

philipmjohnson, 2018-02-21:
Please do work for this task in a branch called issue-77.

Implement a visualization of Box data over a period of time.

Here is an example from the current UI:

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

Some opportunities for improvement:

  * Allow the user to specify the start day and the end day for the trend.
  * Instead of having separate graphs for min voltage, max voltage, etc., try to combine everything in a single visualization.  Have "measurement" checkboxes so that the user can hide uninteresting trend lines.
  * Provide "box" checkboxes so that a user can show trends for more than one box at a time.

  * Stretch goal: have the system figure out interesting combinations of box checkboxes, measurement checkboxes, and start/end dates.  And provide a means to display them.

philipmjohnson, 2018-03-20:
Current stuff to work on:

* Allow user to specify a time interval in terms of a start day and end day.
* Call this Daily Trends.
* Display results for multiple boxes on same chart.
* Also display summary results similar to the above screenshot.
* Display THD as an option along with frequency and voltage.
* Request a new snapshot from Anthony/Serge with THD data.
* Research the chart package that makes the above easiest to implement.

philipmjohnson, 2018-03-29:
Feedback:
* List boxes in alphabetical order.
* When no measure is selected, a line is still displayed.
* Really need the threshold lines.
* Need a legend for each line.
* Fix the dates at the bottom.
* Figure out a more compact way to display box min/max/ave.
* Y axis values for frequency looked messed up.

Thread 78 (2018-02-22):

Implement Health microservice

philipmjohnson, 2018-02-22:
Please do work for this task in a branch called issue-78.

- [x] Review and correct the [specification](https://open-power-quality.gitbooks.io/open-power-quality-manual/content/health/description.html#overview). Specify how the makai and mauka services will be monitored.
- [x] Implement the command line parser to get the -config and -log values.
- [x] Implement box health and logging to text file.
- [x] Implement mauka health and logging to text file.
- [x] Implement makai health and logging to text file.
- [x] Implement view health and logging to text file.
- [x] Implement mongodb health and logging to text file.
- [x] Implement health of health and logging to text file.
- [x] Implement insertion of health info into mongodb health collection.

philipmjohnson, 2018-04-10:
Two changes to current implementation:

(1) Insert a document and write to the log file every time you check a service or box.
(2) Set the TTL on the collection to be one hour. (3600 seconds). Find out from Anthony how we initialize the collections when we install a Mongo DB from scratch.

Closed 2019-02-27.

Thread 85 (2018-03-19):

Add all event types to simulator.

anthonyjchriste, 2018-03-19:
Please do work for this task in a branch called issue-XXX.

Currently, only voltage based events can be reliably created using the OPQ simulator. Also provide facilities for

- [ ] Frequency
- [ ] THD
- [ ] Transients

philipmjohnson, 2018-04-06:
Moving this back to backlog; the simulator is on the back-burner until we have a pressing need for it again.

Thread 86 (2018-03-19):

Simulate 100's to 1000's of OPQ boxes

anthonyjchriste, 2018-03-19:
Please do work for this task in a branch called issue-86.

Currently, the simulator only simulates a "Box 0". Update the simulator so that it can simulate 100's to 1000's of devices.

Thread 87 (2018-03-20):

Implement SystemHealth component

philipmjohnson, 2018-03-20:
Please do work for this task in a branch called issue-87.

Provides data on the health of all OPQ components. Uses the Health collection (see the [Health microservice specification](https://open-power-quality.gitbooks.io/open-power-quality-manual/content/health/description.html#analytics)).

Here's what it currently looks like on emilia. It should be visualized more compactly.

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

Closed 2018-04-22.

Thread 88 (2018-03-21):

Disable bottle server in pify when connected to internet

anthonyjchriste, 2018-03-21:
Please do work for this task in a branch called issue-88.

If we allow OPQ boxes to connect to the UHM network using MAC address passthrough, once the devices are connected to the network, anyone would be able to access the bottle web server which could be a potential security risk. We should find ways to:

- [x] Disable bottle when network is connected
- [x] Re-enable bottle when no network is detected

Closed 2018-04-04.

Thread 90 (2018-03-29):

Implement OPQBox edit page

philipmjohnson, 2018-03-29:
Please do work for this task in a branch called issue-90.'

Create the ability to modify meta data for the boxes that you own (or in the case of Admins, all boxes).

First,  add an Edit button to the bottom of each BoxCard that takes you to an edit page for that box.

The edit page displays a form that shows most of the fields (not the boxId, you can't change that).  But you can edit the name, description, calibration, add/subtract/modify existing locations. etc.

Note that location data is a little complicated, because the form should enable you to both edit existing location data and add new location data.  Also, the representation of location data is likely to change in the near future (i.e. we will add latitude/longitude as an alternative to zip codes).

Because OPQView does not enable the [insecure package](https://atmospherejs.com/meteor/insecure), you will have to define a Meteor method to do this.  If you get confused, see Philip.  Check out the Meteor tutorials on Methods.

Closed 2018-04-11.

Thread 93 (2018-04-04):

Implement Alert Manager

philipmjohnson, 2018-04-04:
Please do work for this task in a branch called issue-93.

Not all events are equal.  We need a way for a user to specify the events that they are interested in.

Upon logging in, the user will find a new link in their nav bar called "Alert Manager".  This takes them to a page that enables them to configure "Alerts". An alert is a user-configurable representation for a set of Events that are of interest to a user.  Each alert has a name, and its configuration can be based on at least the following:

* location
* threshold values for frequency, voltage, THD
* frequency of occurrence of events within a duration
* length of occurrence of events
* some combination of the above

Alerts should be able to represent [ITIC values](http://www.powerqualityworld.com/2011/04/itic-power-acceptability-curve.html). It would be nice provide shrink-wrapped Alert configurations for all ITIC values that users can enable out of the box.

For now, specification of Alerts can be done in the settings.development.json file as an extension to the userProfiles field.

Later, when a user interface for managing User profiles is implemented, editing of alert information can be provided there.

Thread 98 (2018-04-13):

Implement location and region in the data model

philipmjohnson, 2018-04-13:
Please do work for this task in a branch called issue-97.

The goal of this issue is to implement two new entities in the data model: location and region.

### Locations

Locations are first-class entities in the data model. There is a location collection. Initially, only admins can define locations, and they are defined and managed via the settings.development.json file. Locations have:

  *  lat/long coordinates,
  * a “slug” (a unique, human-friendly string identifier)
  * a string description.

For example:
```
{ slug: ‘Kailua-PMJ’, coordinates: [-157.751399,  21.409958], description: ‘House in Kailua’ }
```
Note that the coordinates array must list longitude first, then latitude. See [this StackOverflow Question](https://stackoverflow.com/questions/15274834/how-to-store-geospatial-information-in-mongodb) for more details. Mongo has great support for [GeoSpatial queries](https://docs.mongodb.com/manual/geospatial-queries/), so this will be fun to have.

Location slugs should be considered *permanent* once defined.  Since these slugs have the potential to appear in other documents throughout the database, you will have to guarantee that the location does not appear anywhere else in the database in order to delete it.

Likewise, you cannot change the coordinate values willy-nilly.  Only change them if they incorrectly specify the intended location.

### Regions

“Regions” represent aggregations of Locations. A region consists of:
  *  a “slug” (also unique)
  * a list of location slugs that define the region.

This can be represented by a collection called region whose documents have two fields: regionSlug and locationSlug. For example, to represent a region called “96734" with three Locations:

```
{ regionSlug: “96734”, locationSlug: “Kailua-PMJ” }
{ regionSlug: “96734”, locationSlug: “Kailua-DJ” }
{ regionSlug: “96734”, locationSlug: “Kailua-KK” }
```

The advantage of this "relational" representation is that it supports many-to-many relationships:

  * a single region can be related to multiple locations (as in the example above), and

  * a single location can be related to multiple regions (the location “Kailua-PMJ” could be related to the regions “96734", “Oahu”, and “Hawaii”.)

Region and location slugs together constitute a single namespace (i.e. you can’t have two locations or two regions both called “96734”, nor can you have a location called “96734" and a region also called “96734”).

Unlike locations, users can feel free to manipulate region definitions, as they are only used to facilitate UI queries.

### Implications for OPQBox entities

OPQBox documents have an optional location field that, if supplied, is filled with a location slug. So, Box 5 might have a location field with value “Kailua-PMJ”. This represents its current location. Note that if a Box does not have a location field, its usefulness to end-users is compromised since it will "invisible" to any location-based analyses.

OPQBox documents also have an optional field called location_start_time_ms which contains a timestamp in UTC millisecond format. The user can set this value to indicate the time at which the box started sending data from its current location.

Finally, OPQBox documents have an optional field called location_archive. This holds an array of objects, where each object has a field "location" and a field "location_start_time_ms". The purpose of this field is to maintain a historical record of prior locations associated with this box.

OPQBoxes can only be associated directly with a location. They can be indirectly associated with a region, if a region encompasses the location associated with an OPQBox.

### Implications for Trend and Event entities

Trend documents have a new field called location that is filled with the slug indicating the location from which that data originated. Likewise, event documents have a locations field that is filled with an array of location slugs indicating one or more locations associated with that event.

Trends and Events are only implicitly associated with regions.

### Implications for UI components

UI components can be rewritten to take a location and/or region instead of (or in addition to) a boxID. This means that the Box Trends component on the landing page can become a Location Trends component, which is almost identical except that instead of users specifying one or more boxes, they specify one or more locations or regions. The Meteor Method just does a query to the Trend collection specifying the location field rather than the boxID field, and everything else is exactly the same. But, crucially, the resulting trend line for (say) “Kailua-PMJ” can seamlessly represent data collected by 1, 2, or 10 OPQBoxes.

When a region is specified, it is up to the UI component to decide whether to display separate visualizations for each location in the region, or perform some sort of aggregation over the data from the locations.  The choice depends upon the nature of the component and what serves the understanding of the data the best.

philipmjohnson, 2018-04-15:
Things to do:

- [x]] Implement Location and Region collections
- [ ] Implement definition of locations and regions in settings.development.json
- [ ] Convert OPQBox entity to use location slug.
- [ ] Update data model in documentation to explain locations and regions.

Closed 2018-04-15.

Thread 100 (2018-04-14):

Use Case: Weather-related power outage

philipmjohnson, 2018-04-14:
Here is a real-world use case that our UI does not yet handle.

On Friday, April 13, 2018, from about 8pm to 10pm, the windward side of Oahu experienced severe thunderstorms.  At some point during that time, there was a power outage of approximately 5 seconds duration in Kailua.

On Saturday morning, I wanted to assess the impact of this outage on my OPQ data.  Here are the questions I wanted to answer:

  1. Is my OPQBox functioning correctly now?
  2. What happened to my OPQBox during that five second power outage?
  3. Can I determine from my data the exact time interval of the power outage?
  3. Were there any power anomalies around the time of the outage with respect to frequency, voltage, and/or THD?
  4. Were these anomalies severe enough that I could have experienced appliance failure?
  5. Was the power outage local to my house, or grid-wide?  If non-local, what parts of the grid were affected?

After answering these questions, I would like to be able to add an annotation with a narrative that explains the presence of severe weather, the time duration, and perhaps its impact on my location.

I think that if we can improve our UI to the point that it can answer these questions, along with the ability to add an annotation, then we have a pretty nice real-world example of how to use OPQ and why it can be useful.

Thread 101 (2018-04-14):

Twitter Feed for Alerts

philipmjohnson, 2018-04-14:
Please do work for this task in a branch called issue-101.

In thinking about how to most easily provide the public with a sense for what OPQ detects, it occurred to me that a Twitter feed would be a simple, low-cost solution for folks who want to monitor public data without having to always visit the website to see what's new.

I have just created a twitter account called [opquality](https://twitter.com/opquality) (openpowerquality is too many characters. See me for the password. It's connected to the opq@hawaii.edu account.

Implementation of the Twitter feed needs to wait until we have implemented Alerts.  There's way too many events currently generated to push them all to Twitter.

Example Tweet: "Significant voltage sag to 95V observed in Hawaii Kai, HI on 3/21/18 at 2:41pm. For details, see http://emilia.ics.hawaii.edu/alerts/56789.

We could implement this inside OPQView, or else as a stand-alone service.

Need some way to specify that a location and/or alert can be made public via the Twitter feed.

Thread 103 (2018-04-15):

Update emilia's mongo to support new location representation

philipmjohnson, 2018-04-15:
Please do work for this task in a branch called issue-103.

Update emilia's Mongo database to associate location slugs with Trend and Event data.

Update all existing data to provide a location slug, and change processing to associate the location slug for all future data.

anthonyjchriste, 2018-04-18:
I can do that as soon as @sergey-negrashov starts saving the new location slugs in the DB. That way, when we convert all the exisiting data, there is no gap between existing data and new data where the slug doesn't exists.

I have a couple of questions:
1) In the context of existing data, it seems that we should only add a slug when "legacy location" data (i.e. the "locations" field in "opq_boxes" is known correct? By that, I mean, we have trends and events associated with time ranges that don't have a legacy location associated with them. It seems to me that it would be academically dishonest to associate a location slug with a document when we don't really have any data supporting that that document came from a particular location.

2) Are we removing the "locations" field from "opq_boxes", or will we simply store location slugs and their start times here moving forward? It seems to me that it would be nice to have a history of the boxes location over time without having to query trends or events for that information.

3) Where is the proper place to store the zipcode field? Should that maybe be added to the locations collection?

philipmjohnson, 2018-04-18:
Here are my thoughts:

First, the new data model for OPQ_Boxes has a location_archive field:

https://openpowerquality.netlify.com/docs/datamodel.html#opqboxes

This is where we can store legacy location information.

Second, yes, we are removing the locations field. Instead, we'll represent the current location via two fields: location and location_start_time_ms.  Then, we'll use the location_archive field for legacy location data.  This seems much faster and better than the old way of looking at the last element of an array to find the current location.  Here's the location data model description:

https://openpowerquality.netlify.com/docs/datamodel.html#locations

Third, I am proposing that we no longer explicitly represent zip codes.  They are kind of artificial. Instead, I am proposing that all location definitions must have an array containing [longitude, latitude]. If you want zip codes, you can either create a "region" manually, or use some crazy mongo plugin to map from [longitude, latitude] to zip codes.  I think we can use the "region" entity to do zip codes, towns, neighborhoods, anything we like.

Here's the region data model description:

https://openpowerquality.netlify.com/docs/datamodel.html#regions

philipmjohnson, 2018-05-10:
1. Mongo will be updated with historical info at the same time that oplogs are put online.
2. Locations are not associated with Measurements, but only with Trends, Anomalies, etc.
3. Access the DB to find the current location of the OPQ Box each minute when you create the Trend.
4. Add Locations to Anomalies.
5. Where the heck is Watanabe Hall.
6. Philip: fix the bug in unplugged.

philipmjohnson, 2018-05-31:
There remains some old measurements, events, and trends with old location representation. But who cares. We're done.

Closed 2018-05-31.

Thread 105 (2018-04-17):

Convert site page and gitbook to docusaurus

philipmjohnson, 2018-04-17:
Please do work for this task in a repository called docusaurus.

The current public face of opq has several problems:

  * Documentation is split between openpowerquality.github.io and openpowerquality.gitbook.io
  * GitBook has gone to a new version which is poorly documented and bug-ridden.
  * GitBook cannot format LaTeX math any more.

To solve these problems, convert both sites to a unified site using [docusaurus](http://docusaurus.io).

The revised site is at: http://openpowerquality.netlify.com.  Here's what remains to be done to complete the conversion:

- [x] Get OK from Kaila and Tony to appear on home page (Philip)
- [ ] Write first draft of Makai software services chapter (design-level doc) (Serge)
- [ ] Write first draft of Makai deployment chapter (Serge)
- [x] Write first draft of Health deployment chapter (Evan)
- [x] Switch openpowerquality.org to point to netlify. (Philip)

For instructions on how to add documentation to this site, see [the documentation chapter](https://openpowerquality.netlify.com/docs/developerguide-docusaurus.html).

Less critical, can be deferred until summer:

- [ ] Revise Why care about PQ? page (Philip)
- [ ] Revise A beginners guide to PQ (Philip)
- [ ] Create cool logos for Mauka and Makai for landing page.
- [x] Add search function using Algolia
- [ ] Use React Semantic UI for landing and team page layout.
- [ ] Figure out how to integrate dOxygen and other kinds of code-level docs on site.

philipmjohnson, 2018-04-24:
Good enough for now.

Closed 2018-04-24.

Thread 111 (2018-04-20):

Install 12 OPQ Boxes on campus

philipmjohnson, 2018-04-20:
As part of the [Agile Power Monitoring Project](http://localhost:3000/docs/agile-power-monitoring.html), we must manufacture and install approximately one dozen OPQ Boxes across campus.

philipmjohnson, 2018-04-24:
Replaced by #117.

Closed 2018-04-24.

Thread 112 (2018-04-20):

Transition AcquisitionBroker from REP to a PULL/PUB pair

sergey-negrashov, 2018-04-20:
# This is a proposal for breaking change for Mauka and Health.

There is a mismanagement issue in Makais AcquisitionBroker. Currently the event request mechanism relies on the REQ/REP 0MQ socket pair. It expects the protobufed _opq::proto::RequestDataMessage_ type as an input and replies with the event number generated for this request. The process is shown below:
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
This methodology works, as long as the requestie will bother to receive the event number from AcquisitionBroker. However if the requestie neglects to receive the reply, the internal 0MQ state machine stalls, queueing all future events. There is no fine-grained timeout mechanism in the 0MQ instead, it requres the socket to be reopened as shown in the following issue:
https://github.com/zeromq/pyzmq/issues/132
In order to overcome this limitation, I propose that the AcquisitionBroker provides an additional endpoint for broadcasting that a new event took place. Furthermore the event request endpoint needs to be changed to a pull socket, which would keep the 0MQ state machine moving even with the misbehaving client. Proposed communication strategy is outlined below:

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

Please do work for this task in a branch called issue-112.

sergey-negrashov, 2018-05-10:
Deployed and tested

Closed 2018-05-10.

Thread 115 (2018-04-21):

Provide command line switch to disable logfile

philipmjohnson, 2018-04-21:
Please do work for this task in a branch called issue-115.

Once we are confident in Health, we should be able to turn off the logfile so that we're not using up disk space unnecessarily.

Provide a command line switch to disable logging, and document its availability in the deployment documentation.

philipmjohnson, 2018-05-18:
close

Closed 2018-05-18.

Thread 116 (2018-04-24):

Fix broken Edit Box Page

philipmjohnson, 2018-04-24:
Please do work for this task in a branch called issue-116.

The deployed OPQ View system has a broken edit box button, since it is not yet updated to use the new Location representation:

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

Closed 2018-05-17.

Thread 117 (2018-04-24):

Increase number of UP boxes to at least 6 on emilia

philipmjohnson, 2018-04-24:
(This work will probably be done directly in the master branch.)

Deploy additional OPQ Boxes. This means:

* Get at least three additional OPQ Boxes ready for deployment.
* Communicate with Dan Port (dport@hawaii.edu) and Miles Topping (mtopping@hawaii.edu) to establish locations for new boxes. They are awaiting contact from a student to arrange delivery and setup.
* Edit opq/view/config/settings.development.json to define: (1) location entities for the new boxes, (2) the boxes (id, calibration_constant, location, etc.) and (3) users (dport@hawaii.edu and mtopping@hawaii.edu).
* Redeploy view with new settings.development.json to define these boxes on emilia.
* Update health's config file with new box IDs.
* Plug in boxes and verify that they are sending data.

philipmjohnson, 2018-04-28:
We have approval to put an OPQ box in the basement of hamilton in the LIS space. As you enter the commons area, to the left of the 3F classroom is a hallway, and on the other side of the hallway there is a bookshelf on top of which is a charging station next to some outlets. We can use an outlet.  We need to put a sign on top explaining a little bit about what this is and maybe pointing them to the OPQ.org website for more details.  I think there is a poster with READ in large caps over the bookshelf as well.

anthonyjchriste, 2018-05-08:
6 devices up with number 7 on its way. If we could get device 4 to become active, it'd be a beautiful thing.

Closed 2018-05-08.

Thread 118 (2018-04-24):

Implement Location-based BoxMap component

philipmjohnson, 2018-04-24:
Please do work for this task in a branch called issue-118.

Implement a map-based component that shows the current location of all defined OPQBoxes based upon their location slug, which provides their latitude and longitude.

There is a preliminary version of of this component available in branch [issue-69](https://github.com/openpowerquality/opq/tree/issue-69).  Unfortunately, David A has stopped working on this component so we need to take over from him.

I recommend that you:

* Create a new branch called issue-118 off of master.
* Merge branch issue-69 into your new branch.
* Resolve any merge errors (hopefully there won't be any).
* Finish the BoxMap component.

philipmjohnson, 2018-05-31:
David A has continued to work in branch issue-69, so I'll close this issue and we can continue to track progress in issue-69.

Closed 2018-05-31.

Thread 121 (2018-04-30):

Design Incident and Phenomena data model to support PQ classification

philipmjohnson, 2018-04-30:
Please do work for this task in a branch called issue-121.

In [A beginners guide to power quality](https://openpowerquality.org/docs/intro-power-quality.html), a variety of PQ types are identified.  Investigate the creation of classification schemes for:

- Blackout
- Transient
- Over voltage
- Under voltage
- EMI
- RFI
- instantaneous
- momentary
- temporary
- swell
- prohibited region
- no interruption region
- no damage region

philipmjohnson, 2018-04-30:
It's useful to do a google search for "power quality problem classification". For example, here's one article among several:

https://ieeexplore.ieee.org/document/5136965/

anthonyjchriste, 2018-05-01:
Thanks, that's a great search term.

anthonyjchriste, 2018-05-02:
After starting to delve into this a bit more, I'm of the opinion that our current data model for events may need to be updated. Events, as currently designed, are centered around triggering. That is, triggering sees something interesting, creates an "event" which in turn goes out and attempts to receive data which then creates "box_events".

This model doesn't provide a clear way for adding PQ classifications ex-post-facto once Mauka receives the raw waveform and starts performing higher level analysis. What Mauka does currently with THD and ITIC is it adds those values to fields within box_events, but I'm not convinced this is the best approach moving forward. It feels really icky.

I think we might be in need of a new collection, something like classified_[issues|events], where each document is a single classification rather than trying to aggregate all the PQ information into a single box_event.

Thoughts?

philipmjohnson, 2018-05-03:
I agree, but I would take it even a little further.  How about this:

1. There is a new entity called "Anomaly" held in a collection called "anomalies"

2. Anomalies have these fields:
  * events: an array of Events associated with this anomaly.
  * type:  a string indicating the type of this anomaly
  * data: an object containing keys and values with additional information about this anomaly.

3. The event entity no longer has a "type" or "description" field.

4. The box_event entity no longer has "itic" or "thd" fields. (These become an Anomaly "type")

Basically, we remove all fields associated with "interpretation" of PQ data out of the event and box_event entities.  All they do is represent raw data.  All interpretation is now found in the Anomaly entity.  Anomalies are created by Mauka or Makai or whoever wants to look at events and box_events.

Note that an Anomaly can represent a periodic event and/or a problem that is found by looking at multiple events. For example, let's say that there's a voltage sag that occurs every day at noon, or every time the insolation drops by a specified amount in a very short period of time, or something.   The associated Mauka plugin could detect this, and then there would be a single Anomaly that represents this reoccurring event ("Voltage Sag At Noon") which incrementally augments its events field as new occurrences of voltage sags fitting that classification happen.

How does this sound?

anthonyjchriste, 2018-05-04:
I think it's a step in the correct direction. I'm not entirely sure I'm on board yet with an Anomaly representing more than one event. It would be nice to have a simple document that simply classifies every PQ issue we know how to classify as we see them. I think I would at least like to start building anomalies this way and then can maybe build them up to work with multiple events after we have them working with single PQ events.

philipmjohnson, 2018-05-05:
I totally agree to start with "simple" Anomalies with a one-to-one correspondence with Events, but not sure why you want to have two different collections, one for "Simple Anomalies" and one for "Complex Anomalies".  It seems to me the only difference is whether the Events field takes a single Event or a list of Events.  What am I missing?

Looking at it again, I would replace the Events field by a "join table collection", which is a collection with two fields: AnomalyID and EventID.  That way, you can have fast bi-directional queries, i.e. you can easily look up all of the Events associated with an Anomaly, as well as all of the Anomalies associated with a given Event. Not sure why I didn't design it that way from the beginning.

Finally, now that I am looking at related work, I am somewhat doubtful that we will break any new ground through one-to-one Event to Anomaly classifications.  There are lots of very expensive PQ analyzers that do that already. For thesis-level innovation, I suspect the fertile ground is in classifications that are built off of multiple events.

But, we have to crawl before we can walk. If you have a proposal for an alternative representation, or I am misunderstanding you, please reply!

anthonyjchriste, 2018-05-09:
The branch should be issue-121 not issue-120.

philipmjohnson, 2018-05-09:
Whoops! Fixed.

philipmjohnson, 2018-06-05:
We're now thinking in terms of Incidents and Phenomena:

https://openpowerquality.org/docs/intro-information-architecture.html

Closed 2018-06-11.

Thread 125 (2018-05-09):

Implement improved Measurement entity design

philipmjohnson, 2018-05-09:
Please do work for this task in a branch called issue-125.

Currently, the Measurement document provides instantaneous voltage, frequency, and THD. We get those data points 6 times per second in order to not "miss" anything interesting. If the data indicates an event occurred, we go out and get the waveform.

There are three problems as I see it with this approach: (1) we have to argue that 6/sec sampling is "good enough" to see everything of interest, (2) if we could reduce the sampling rate, we could increase the scalability of the system; and (3) there is no representation for detected transients.

Here's a proposal for an improved Measurement design to address these concerns:

1. Measurements arrive once per second, not 6/second.
2. Voltage and Frequency values are reported as the "maximal deviant" from nominal value during the last second.  So, if nominal is 120, and voltage reached 125, then 125 would be reported. If there was both a surge and a sag in the last second, then whichever one was greater would be reported.
3. There is a field that reports whether or not a transient was observed. Serge will have to weigh in on what that field looks like.

The advantage of this design is that we can both reduce the sampling rate of boxes substantially while also getting rid of the need to argue that "6/second is fast enough". Since we will go get the waveform anyway, we don't need detailed information about the last second; we just need to know about "deviations" sufficient to decide whether or not to trigger. Finally, this design addresses the need we need to report on transients, which we aren't doing yet.

philipmjohnson, 2018-05-15:
It occurs to me that we might want to create a new collection (called, say, "Measures"), rather than just update in place the Measurements collection.  That way we don't have a single collection with two kinds of semantically different documents in it.  It also will make it more obvious when we update dependent analyses because they'll refer to a new collection.  What do you think?

Thread 127 (2018-05-09):

Fix bug in Measurement document insertion

philipmjohnson, 2018-05-09:
Please do work for this task in a branch called issue-127.

Currently, live data for boxes is broken and today's count for Measurement data is zero. This appears to be because the timestamps for new Measurements are a day or so off.

The rest of us believe this is a bug in Makai. 😸

sergey-negrashov, 2018-05-10:
After some digging I narrowed down this issue to the mongo insertion for measurements. Instead of inserting every measurement separately, I now batch in windows of 1 second. This seemed to have resolved the issue.

philipmjohnson, 2018-05-10:
Excellent!  I wonder if the Rust people can be easily notified that their Mongo driver falls apart under load?

Closed 2018-05-10.

Thread 128 (2018-05-09):

Design and document test procedures for OPQBox software

philipmjohnson, 2018-05-09:
Currently, we do not have a formal mechanism in place to verify that after changes to the OPQ Box software, it is still able to send Measurement documents with the correct values to the cloud.

We need to:

* Determine where we can get access to an AC waveform generator.
* What procedures should be followed to verify that a revision to OPQ  Box software has not introduced any regressions with respect to the detection of voltage, frequency, THD, and Transient events.

Thread 130 (2018-05-15):

Implement the LocationManager page

philipmjohnson, 2018-05-15:
Please do work for this task in a branch called issue-130.

Implement the ability for Admins to define new Location entities  in OPQ View.  This involves the following steps:

1. Install OPQ View using the [OPQ View installation instructions](https://openpowerquality.org/docs/cloud-view.html)

3. Edit ui/pages/ManageLocationPage.jsx to implement the component. Follow the implementation of the [ManageBoxPage](https://github.com/openpowerquality/opq/blob/master/view/app/imports/ui/pages/ManageBoxPage.jsx).

4. Implement a React component to list all of the current Locations in a table. Display that component in the LocationManager page.

5. Once you've implemented this component, have your code reviewed.

6. Now implement a React component to display a form that enables an admin user to create a new Location object.   See [settings.development.json](https://github.com/openpowerquality/opq/blob/master/view/config/settings.development.json) for the current representation of a Location object.  There are only three fields: coordinates, slug, and description.

7. Once you have implemented the form UI, but before implementing its actual behavior, have your code reviewed.

8. Implement a validated meteor method to perform the location definition when the user clicks the submit button. For details, see the [Meteor Guide chapter on Methods](https://guide.meteor.com/methods.html).

9. Make sure that slugs are unique. If the user tries to define a location with a slug that already exists, the validated method should fail.

10. Once your form works correctly, you should see your table of Locations update immediately after successfully creating a new location.

11. For bonus points, it would be cool to be able to specify the coordinates of the new location by dropping a pin on a map displayed inside the form.

Closed 2018-09-12.

Thread 131 (2018-05-15):

Implement a User Management Page

philipmjohnson, 2018-05-15:
Please do work for this task in a branch called issue-131.

Implement the ability to define new Users via the Admin interface in OPQ View.  This involves the following steps:

1. Install OPQ View using the [OPQ View installation instructions](https://openpowerquality.org/docs/cloud-view.html)

2. Set up your local version to use a [DB Snapshot](https://openpowerquality.org/docs/cloud-view.html#use-snapshot-db-optional).

3. Implement a new page called "UserManager". It should appear in the navbar only for Admin users.  Follow the implementation of the [Admin Page](https://github.com/openpowerquality/opq/blob/master/view/app/imports/ui/pages/Admin.jsx).

4. Implement a React component to list all of the current Users in a table. Display that component in the UserManager page.

5. Once you've implemented this component, have your code reviewed.

6. Now implement a React component to display a form that enables an admin user to create a new User.   See [settings.development.json](https://github.com/openpowerquality/opq/blob/master/view/config/settings.development.json) for the current representation of a Location object.

7. Once you have implemented the form UI, but before implementing its actual behavior, have your code reviewed.

8. Implement a validated meteor method to perform the user definition when the admin clicks the submit button. For details, see the [Meteor Guide chapter on Methods](https://guide.meteor.com/methods.html).

9. Make sure that usernames are unique. If the user tries to define a user with a username that already exists, the validated method should fail.

10. Provide a multiple checkbox controller for all currently defined box IDs.

10. Once your form works correctly, you should see your table of Users update immediately after successfully creating a new user.

Thread 135 (2018-05-16):

Implement a Mauka plugin that classifies IEEE 1159 Voltage Events

anthonyjchriste, 2018-05-16:
Please perform work for this task in branch issue-135.

This task involves creating a new plugin that classifies events according to IEEE 1159.

1. Read through the OPQ Mauka Developer Guide:https://openpowerquality.org/docs/cloud-mauka.html#development and prepare your development environment.

2. Familiarize yourself with the [numpy](http://www.numpy.org/) and [scipy](https://www.scipy.org/) libraries.

3. Create a new plugin at opq/mauka/Ieee1159Plugin.py

4. Subscribe to the "VrmsWaveform" topic.

5. When the plugin receives data, go through the high fidelity Vrms waveform and classify the following event types:
 * Instantaneous dip
 * Momentary dip
 * Temporary dip
 * Instantaneous swell
 * Momentary swell
 * Temporary swell
 * Overvoltage
 * Undervoltage
 * Interruption

6. When classified events are found, create a new anomaly document for each event and store it to the anomalies collection. You may need to modify opq/mauka/mongo.py to add new event types and new collections types.

7. Test your code on OPQ Sim by deploying successfully deploying Mauka to OPQ Sim, generating voltage events on OPQ Sim, and monitoring the expected Mauka messages.

7. Have your code reviewed before merging into master.

philipmjohnson, 2018-06-22:
Note that it's IEEE 1159, not IEEE 1156.  Please update any references in the code appropriately. Sorry for the typo.

Closed 2018-07-15.

Thread 136 (2018-05-16):

Implement a Mauka plugin to classify brownouts

anthonyjchriste, 2018-05-16:
Please perform work for this task in branch issue-136.

This task involves creating a new plugin that classifies [brownouts](https://openpowerquality.org/docs/intro-power-quality.html).

1. Read through the OPQ Mauka Developer Guide:https://openpowerquality.org/docs/cloud-mauka.html#development and prepare your development environment.

2. Familiarize yourself with the [numpy](http://www.numpy.org/) and [scipy](https://www.scipy.org/) libraries.

3. Create a new plugin at opq/mauka/plugins/BrownoutPlugin.py

4. Subscribe to the "VrmsWaveform" topic.

5. When the plugin receives data, go through the high fidelity Vrms waveform and attempt to classify a brownout. Let's start with a definition of a sustained (> 2min) voltage drop (> 20 volts), but these values should be configurable in the mauka configuration.

6. When classified events are found, create a new anomaly document for each event and store it to the anomalies collection. You may need to modify opq/mauka/mongo.py to add new event types and new collections types.

7. Test your code on OPQ Sim by deploying successfully deploying Mauka to OPQ Sim, generating voltage events on OPQ Sim, and monitoring the expected Mauka messages.

7. Have your code reviewed before merging into master.

Thread 138 (2018-05-16):

OPQBox calibration utility

sergey-negrashov, 2018-05-16:
Please do work for this task in a branch called issue-138.

Develop OPQBox calibration utility to calibrate against the Fluke multi-meter. The task list is as follows:
- [x] Read 10 cycles from the kernel driver
- [x] Compute the rms
- [x] Divide the rms by true voltage value supplied by the user to obtain the calibration constant.
- [ ] Documentation

* Interfacing with the opq kernel driver is described in the following section of the documentation:
https://openpowerquality.org/docs/box-software-design.html#kernel-driver
* Following C++ code performs the data transfer from the opq driver to the userland:
https://github.com/openpowerquality/opq/blob/issue-144/box/Software/Triggering/lib/opqdata.hpp#L47

Closed 2018-09-26.

Thread 144 (2018-05-29):

OPQBox software stack V3

philipmjohnson, 2018-05-29:
Please do work for this task in a branch called issue-144.

This will be a rewrite of the triggering software from C++ to rust with emphasis on extendability, and testing. The task list is as follows:
- [x] Familiarize yourself with Rust programming language.
- [x] Create a rust structure responsible for reading data from the kernel driver and placing it into the queue for processing.
- [x] Define a loadable plugin interface.
- [x] Create a plugin manager.
- [x] Create a monad for passing a *Measurement* protobuf object and raw data across the loaded plugins.
- [x] Create a ZMQ socket for transfering the *Measurement* object to makai.
- [x] Create an in-memory data store for storing raw data.
- [ ] Create the command interpreter for the three commands defined in the protocol.
- [x] Logging.
- [ ] Unit test.
- [ ] Documentation.

* An example of a plugin interface in makai:
https://github.com/openpowerquality/opq/blob/master/makai/TriggeringService/opqapi/src/makaiplugin/mod.rs
* Loading a plugin in makai:
https://github.com/openpowerquality/opq/blob/master/makai/TriggeringService/makai/src/plugin_manager.rs
* Example of makai plugin:
https://github.com/openpowerquality/opq/blob/master/makai/TriggeringService/plugins/print/src/lib.rs
* New protocol is found here:
https://github.com/openpowerquality/opq/blob/issue-144/protocol/opqbox3.proto
* Interfacing with the opq kernel driver is described in the following section of the documentation:
https://openpowerquality.org/docs/box-software-design.html#kernel-driver
* Following C++ code performs the data transfer from the opq driver to the userland:
https://github.com/openpowerquality/opq/blob/issue-144/box/Software/Triggering/lib/opqdata.hpp#L47

Closed 2018-12-05.

Thread 145 (2018-05-30):

Fix locations in box_events

sergey-negrashov, 2018-05-30:
Please do work for this task in a branch called issue-145.

Switch locations to the new data model.

Closed 2018-05-30.

Thread 146 (2018-06-01):

Refactor the Live Data and Event Inspector components to accept an 'initialBoxes' prop

aghalarp, 2018-06-01:
Please do work for this task in a branch called issue-146.

The Event Inspector and Live Data components should both be refactored to accept a single prop (initialBoxes) that indicates the initial OPQBoxes to load upon mounting.

We initially discussed naming this prop 'initialBox', but it occurred to me that both of these components are actually designed to work with multiple OPQBoxes, and so it might make more sense to create an 'initialBoxes' array prop instead. This way, we can pass in one or more box ids, depending on the needs of the parent component.

aghalarp, 2018-06-11:
These two components now accept an ‘initialBoxIds’ array prop that, as the name implies, contains the box_ids that the component should initialize with upon mounting. I went ahead and pushed these changes as part of branch issue-69, as it was easier to test these changes with the BoxMap component.

As far as I understand, there are two ways that we could have implemented this with React-Router:
1. By including the boxIds as a query param as part of the URL
2. By using React-Router’s location.state object

I went with the latter choice, as if we wanted to include the boxIds in the URL, then we would have to start thinking about other cases such as, what to do when the user selects additional boxIds? Update the URL again with the currently selected boxIds? It seemed like the wrong way to go.

React-Router’s [Location](https://reacttraining.com/react-router/web/api/location) object describes where the app currently is. It can be accessed by wrapping the [withRouter()](https://reacttraining.com/react-router/web/api/withRouter) HOC around any given component.

Subsequently, React Router’s [Link](https://reacttraining.com/react-router/web/api/Link) component can be used to provide… links to other parts of the app. By providing an object to its ’to’ prop, we can not only link to a different page, but also pass in a state object for that location. This state object is not actually passed directly to the target component - rather, it simply lives as part of the Location component's state. The idea is that, once we redirect to our target page, we can access this Locations component and retrieve whatever we want from the Location.state object (which, again, we can access by wrapping the withRouter() HOC around whichever component we’re interested in).

Now because I’ve been brainwashed into believing that HOCs are super cool, I decided to use a HOC for handling this, and created the brilliantly named ‘withRouterLocationStateAsProps’ HOC. What this HOC does is rather simple: It accepts a list of strings which represent the keys in the Location.state object that we’re interested in - and if present, will retrieve and pass them as props to the wrapped component. Subsequently, within our target component, we can access the value as a regular old prop. It’s easy to work with, I think - as we don’t have to really tinker with the Location.state object within our components, and simply work with props instead.

Closed 2018-06-21.

Thread 147 (2018-06-05):

Implement a plugin that detects IEEE 1159 Frequency Variations

anthonyjchriste, 2018-06-05:
Please do work for this task in a branch called issue-147.

Implement a Mauka plugin that detects, classifies, and stores frequency variation incidents.

Frequency variations should be classified as +/- 0.10hz as specified in page 7 of the IEEE standard.

The new plugin should subscribe to the high fidelity frequency array created produced by the MakaiEventPlugin.

dickensc, 2018-09-11:
Thousands of incidents for single event, furthermore, at the moment the fitting method is very computationally expensive.

Revisit to lower sensitivity and join multiple events and improve performance.

Closed 2018-10-14.

Thread 153 (2018-06-21):

Detect power outages and classify as an Incident

philipmjohnson, 2018-06-21:
Please do work for this task in a branch called issue-153.

Currently, we do not have a representation for power outages.  One challenge is that there is no way for the cloud to distinguish between someone unplugging an OPQ box and the power going out.

Proposed approach:

Makai or Mauka monitors the measurement stream.  If a box stops sending data and the `unplugged` field in the corresponding OpqBox document is not true, then a power outage event (incident?) is automatically generated.

This implies the following:

1.  Users need to set unplugged to true prior to unplugging their OPQ boxes in order to avoid generating a spurious power outage event.

2.  Users will definitely forget to do (1), so there needs to be a way for users to tell the system that a power outage Incident was a false positive and to delete it.

3. If a box is sending data and the unplugged field is true, then we need the system to remind the user (admin?) to fix it.

philipmjohnson, 2018-09-05:
The power went out early this morning (9/5/18) in Kailua for maybe an hour? So there should be a data lapse from the Kailua box. See if you can generate an incident for it.

Closed 2018-12-05.

Thread 157 (2018-07-03):

Implement transient detection and classification.

anthonyjchriste, 2018-07-03:
Please do work for this task in a branch called issue-157.

Implement a Mauka plugin at opq/mauka/plugins/transient_plugin.py that detects and classifies transients in accordance to the IEEE 1159 standard.

Transients can be described as either nanosecond, microsecond, or millisecond impulsive transients or as low/medium/high frequency oscillatory transients. Transients are further characterized on page 20 of the standard with the following classifications:

Unipolar
Bipolar
Oscillatory
Arcing
Multiple Zero Crossing
Periodic Notching
PF Cap Switching
Energy

1. Create transient detection classifcation plugin
2. Edit opq/mauka/mongo.py with new incident types to support the above classifications.
3. Write unit tests to assess and test against all possible classifications.
4. Document the plugin in docusaurus.
5. Ensure code changes pass all static analysis checks.
6. Check in with Anthony before merging to master.

Closed 2019-02-01.

Thread 161 (2018-08-02):

Integrated, or integrate with, energy monitoring (feature request)

ptr727, 2018-08-02:
It would be fantastic if you could collaborate with the open energy monitoring community at Open Energy Monitor, and incorporate power quality and energy monitoring in a single hardware solution, that can be mounted in or near the panel, and monitor both supply legs.

Please see this thread where I asked for the same:
https://community.openenergymonitor.org/t/power-quality-monitor/8124

To take it further, think of an open source version of products like https://sense.com/ that is an A/D and math and AI and ML. I imagine the unit in my panel collecting data, doing some compression or FFT or sampling or thresholding, and sending it to AWS or Azure, where we can do all sorts of interesting things with the data.

philipmjohnson, 2018-08-02:
This is an interesting idea!  To avoid duplication of discussion, let's close this issue and use the thread you started on the OEM side (https://community.openenergymonitor.org/t/power-quality-monitor/8124). I've replied over there.

Closed 2018-08-02.

Thread 162 (2018-08-04):

Determine why Health is reporting that Makai is going up and down

philipmjohnson, 2018-08-04:
Please do work for this task in a branch called issue-161.

Either the Health Module does not appear to be set up correctly, or Makai is going up and down:

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

We need to look into this and figure out why it's happening.

anthonyjchriste, 2018-08-06:
The logs show Makai but slack and this issue say Mauka. Please confirm which you are seeing issues with.

philipmjohnson, 2018-08-06:
Whoops fixed.

philipmjohnson, 2018-09-06:
Evan redeployed Health on 9/4/18, and so far it appears that Health is correctly reporting Makai to be up all the time.

The way Health checks makai is as follows:  Health publishes an event to Makai, and then asks Makai to retrieve an event. We think it was going up and down because right after getting the event from Makai, Health tries to get the event from Mongo, and it's not there.  If that occurs, Health writes Down with "" (now will say down with Mongo).

So, if the problem reappears, we suggest that the thread should sleep for a couple of seconds before querying Mongo for the event.

Closed 2018-09-06.

Thread 163 (2018-08-07):

Design documentation

ptr727, 2018-08-07:
Hi, could you please produce, post, or point me to your design documentation?
E.g. design reasoning, component selection reasoning, component value calculation, etc.

Something like this:
https://www.switchcraft.org/project-blog/2016/12/11/designing-a-voltage-sensing-pcb

Thank you

philipmjohnson, 2018-08-07:
The hardware design documentation is available here:

https://openpowerquality.org/docs/box-hardware-design.html

davidrb, 2018-08-07:
You can also find schematics for the PCB here https://github.com/openpowerquality/opq/blob/master/box/Schematics/v3/opqbox3.pdf.

ptr727, 2018-08-07:
Thank you

Closed 2018-08-07.

Thread 164 (2018-08-13):

Improve THD plugin performance

anthonyjchriste, 2018-08-13:
Please do work for this task in a branch called issue-164.

Currently, the THD plugin is very slow. We use a recommended window size of 200 ms, but our step size is one sample. We should step at 200ms as well which should greatly improve performance.

Closed 2018-09-12.

Thread 177 (2018-11-27):

Box Deployment Miscellaneous

sergey-negrashov, 2018-11-27:
- Order 20x fuses: [here](https://www.mouser.com/ProductDetail/Bel-Fuse/RSTA-1-BULK?qs=Mr%252bgrRYddfq9DW4ONamD4w%3D%3D)
- Research and order 9 enclosures: [here](https://www.hammfg.com/electronics/small-case/plastic)
- Order 20x raspberry pi header : [here](https://www.adafruit.com/product/2822)

Closed 2019-03-07.

Thread 181 (2018-11-27):

Switch makai to a new protocol

sergey-negrashov, 2018-11-27:
Please do work for this task in a branch called issue-181.

Switch the makai capture to a new protocol.

Closed 2018-11-28.

Thread 182 (2018-12-03):

UH Metering API

anthonyjchriste, 2018-12-03:
Please do work for this task in a branch called issue-182.

Interface with UH's API to access ground truth from OoEM meters.

- [x] Successfully connect to the internal UH endpoint with basic authentication
- [x] Map out and document OPQ relevant UH HTTP endpoints and queries
- [x] Create abstractions for querying voltage, frequency, THD, events (and others?) by time range and meter ID
- [x] Design data abstractions for UH data via protobuf
- [x] Setup internal HTTP or ZMQ endpoint for requesting serialized data in Mauka or Makai

Closed 2019-01-03.

Thread 196 (2019-01-23):

Update View to Meteor 1.8

aghalarp, 2019-01-23:
Please do work for this task in a branch called issue-196.

Update View to Meteor 1.8

aghalarp, 2019-01-23:
We've updated from Meteor 1.6.1.1 to 1.8.0.2

Note that Meteor 1.8.0.2 uses Node version 8.11.4, so we’ll need to update View’s Dockerfile with a base Node image matching this new version.

Closed 2019-01-31.

Thread 198 (2019-01-31):

Create a box-config-daemon box service

anthonyjchriste, 2019-01-31:
Please do work for this task in a branch called issue-198.

Currently, the box-config-daemon is started as part of init.rc. Instead, ensure that the box-config-daemon is started using systemd.

philipmjohnson, 2019-02-07:
Hey, can you rename your branch from 198 to issue-198?  Minor thing, but will keep the branch names more consistent.

anthonyjchriste, 2019-02-07:
I'm not seeing any branches named 198. There is a branch named issue-198 already.

anthonyjchriste, 2019-02-07:
Did you mean to refer to branch 168 https://github.com/openpowerquality/opq/tree/168 ?

philipmjohnson, 2019-02-07:
Whoops sorry!

Closed 2019-02-07.

Thread 202 (2019-02-05):

Reimplement Semi F47 Plugin

anthonyjchriste, 2019-02-05:
Please perform work for this task in branch issue-136.

This task involves creating a new plugin that classifies events according to the Semi F47 standard.

    1. Read through the OPQ Mauka Developer Guide:https://openpowerquality.org/docs/cloud-mauka.html#development and prepare your development environment.

    2. Familiarize yourself with the [numpy](http://www.numpy.org/) and [scipy](https://www.scipy.org/) libraries.

    3. Create a new plugin at opq/mauka/plugins/semi_f47_plugin.py that subscribes to RmsWindowedVoltage messages.

    4. Classify and store incidents for classified semi_f47 incidents.

    5. Update enums in mongo.py as needed.

    6. Write unit tests that test all edge cases and classifications for this issue.

    7. Document this plugin in docusaurus.

    8. Ensure all code changes pass the static code analysis checks.

    9. Check in with Anthony before merging into master.

A working definition of the Semi F47 standard can be found at: https://www.pge.com/includes/docs/pdfs/about/news/outagestatus/powerquality/power_quality_bulletin-issue_no.3-volt_sagImm_std-8-10-07.pdf

Thread 206 (2019-02-08):

Create a makai plugin for mongo storage.

sergey-negrashov, 2019-02-08:
Please do work for this task in a branch called issue-206.

Create a new plugin for interfacing with mongo.
Start with the boiler plate and add functionality as needed.
1. Establish a database connection to mongo.
2. Load settings from the TriggeringService.
3. Push measurements into mongo.
4. Push trends into mongo.

philipmjohnson, 2019-02-08:
Updated this task description to indicate that the work should be done in a branch called issue-206.

Closed 2019-02-21.

Thread 207 (2019-02-08):

Final tasks for EPRI Box Delivery

philipmjohnson, 2019-02-08:
(No branch needed for this task.)

## Friday, Feb 8

- [x] Print and attach stickers to boxes.
- [x] Take pictures of boxes (inside and out), post to Slack so Philip can incorporate them into documentation.
- [x] Update [OPQ Box Configuration Instructions](https://openpowerquality.org/docs/userguide-hardware.html#opq-box-configuration) with values appropriate for emilia.
- [ ] Set up both boxes to send data to emila (with location set to CSDL lab).  Let boxes run over weekend.

## Monday, Feb 11
- [ ] Verify that boxes sent data to emilia over weekend
- [ ] Package boxes (with power cord) for sending to EPRI.

philipmjohnson, 2019-02-21:
I'm going to be optimistic and close this issue. Hopefully things are pretty much good to go.

Closed 2019-02-21.

Thread 210 (2019-02-12):

Add ability to read config values from the environemnt for Makai.

anthonyjchriste, 2019-02-12:
Please do work for this task in a branch called issue-210.

The proper way to do networking in docker compose is to pass around env vars. This was explained by David.

"""
So, each docker container is basically its own computer, with its own network. So, mauka right now is connecting to mongodb with the `mongodb://localhost:27017` url string, but actually this doesn’t work, because the Mongo service now lives in its own container (its own ‘computer’ with its own network). `localhost` in Mauka’s container is different than `localhost` in the Mongo container. Each container has its own loopback interface. Makes sense, right?

So Docker-Compose makes life easier for us by providing us a hostname for each service we define in docker-compose.yml. This hostname points to the actual ip address of the docker container that docker manages for us.

So, now we can use the following mongo url to connect to the mongo container `mongodb://mongo:27017`, where `mongo` is the service name we defined in docker-compose.yml for the mongodb service.

So we need Mauka (and every other service) to receive that url string somehow in order to connect to the Mongo docker container. We can either hardcode that value directly into your code, or, the real solution, have each service accept environment variables that allow us to set these values.
"""

Determine which URLs can be used an env vars. Edit Makai to read from environment when signaled from config. This includes ZMQ stuff, so may want to come up with common env vars between Mauka and Makai.

aghalarp, 2019-02-14:
@anthonyjchriste's work setting up env vars for Mauka allowed me experiment and gain a much better understanding of Docker networking. To narrow this down a bit for you, there are three general cases to be concerned about:

**1. Client connection to another container:**
Recall that each docker container has its own isolated network. We will need to be able to set an environment variable for any client-side connections from Makai to a server that lives within **another** container.
Ie. If Makai currently connects to a server listening in the Mauka container, the connecting string `tcp://localhost:1234` wouldn’t work, because that server is listening on Mauka’s network now. With Docker Compose, we essentially turn this into `tcp://mauka:1234`, provided that Makai allows us to set an environment variable for this networking url.

**2. Container hosting a server for other containers to connect to:**
If the Makai container is hosting a server and expects connections from other containers, we need to expose the port that the server is listening on. Assuming that this server is listening on 0.0.0.0 or *, we only require knowledge of the port number so that we can expose it to other containers. In fact, if you do not wish for the port number to be configurable, you don’t need to provide an env var for this.

**3. Container hosting a server for the outside world to connect to:**
Lastly, if the container is hosting a server and expecting connections from the outside world (as opposed to just another container), we need to expose and map the port directly to the host machine. The server should also be listening on 0.0.0.0 or * here as well. Again, if you do not want this port to be configurable, you do not need to provide an env var for it. Just let us know which ports need to be exposed to the outside world. I imagine one case for this is for the port(s) that Makai listens on for OPQ box data.

There’s no immediate rush to implement this, as I should be able to hook up our current docker compose network with Makai even if it is not yet dockerized. But this relies on some trickery and is not an ideal long term solution, especially if we plan on moving off Emilia and onto AWS or some other cloud service.

philipmjohnson, 2019-02-14:
I wonder if these insights should ultimately make it into our Docker Docs as "background info" or something?

Closed 2019-03-06.

Thread 211 (2019-02-12):

Refactor Docker deployment strategy to allow for updating individual images

aghalarp, 2019-02-12:
Please do work for this task in a branch called issue-211.

Our current deployment methods require us to shut down the currently running Docker Compose process in order to deploy an updated Docker Compose instance. This is not ideal. Let's figure out a way to just redeploy and update just the containers we are interested in.

aghalarp, 2019-02-19:
The deployment strategy has been simplified and streamlined even further. In addition, re-deployment will only update and restart the affected services, rather than the entire service stack.

See updated Docker docs: https://openpowerquality.org/docs/deploy-docker.html

Closed 2019-02-19.

Thread 212 (2019-02-13):

Fix failing CI check for View.

anthonyjchriste, 2019-02-13:
Please do work for this task in a branch called issue-212.

CI currently fails with the errors:

/home/runner/opq/view/app/imports/ui/pages/About.jsx
8:1  error  Line 8 exceeds the maximum line length of 120   max-len
10:1  error  Line 10 exceeds the maximum line length of 120  max-len
12:1  error  Line 12 exceeds the maximum line length of 120  max-len
15:1  error  Line 15 exceeds the maximum line length of 120  max-len

Closed 2019-02-13.

Thread 215 (2019-02-21):

Docker Delights

philipmjohnson, 2019-02-21:
(probably no branch needed)

- [x] Change the dockerhub openpowerquality account to an organization.
- [x] Create a “team” called "developers" within the organization consisting of David, Anthony, Serge, Evan, and me (at least).
- [x] Provide access rights for the developers team to all images etc.
- [x] Publish our first set of “official” docker images for all the OPQ Cloud services.
- [x] Deploy the official images to Emilia.
- [x]  Start up a brand new, fresh instance of OPQ Cloud from the “official” published images, taking notes on the steps.
- [x]  Document the steps required to bring up a brand new, fresh instance of OPQ Cloud from the official published instances.

Closed 2019-02-22.

Thread 217 (2019-02-21):

Ensure new health can dynamically handle boxes coming up and going down

anthonyjchriste, 2019-02-21:
Please do work for this task in a branch called issue-217.

The current version of health requires a restart when new boxes are added to show the boxes as "Up". Ensure that the redesign is able to handle new boxes being added without restarting the health service.

philipmjohnson, 2019-04-12:
Makai handles this automagically.

Closed 2019-04-12.

Thread 220 (2019-02-21):

Implement detailed metrics and instrumentation for all Mauka plugins

anthonyjchriste, 2019-02-21:
Please do work for this task in a branch called issue-220.

We can currently calculate the size of different collections and layers with Laha, but we're not storing this data for long term analysis.

Further, we should be able to collect metrics on how often different plugins get called and the amount of data passing from plugin to plugin within Mauka.

Implement metrics collection and analysis with something such a prometheus as a backend and grafana for display.

Data storage metrics for:
- [x] instantaneous measurements layer
- [x] aggregate measurements layers
- [x] detentions layer
- [x] incidents layer
- [x] phenomena layer

Counts for:
- [x] measurements
- [x] trends
- [x] events
- [x] incidents
- [x] phenomena

I also want to collect detailed metrics on plugins
- [x] How many messages does each plugin receive per time window
- [x] How many messages does each plugin forward per time window
- [x] How much data does each plugin receive per message
- [x] How much data does each plugin forward per message

System metrics captured with https://github.com/giampaolo/psutil
- [x] Memory
- [x] Disk
- [x] CPU

Finally
- [ ] Document the new metric collection

philipmjohnson, 2019-02-21:
I think Prometheus and Grafana are way overkill for your current use cases.

I am pretty sure it will be far less trouble to learn a little React and a little less Meteor and just extend View with this functionality.  Plus, this avoids two more technology components, two more Docker containers, etc.

It would be good to spec out all of the metrics needed for your thesis in one place so we have a good perspective on what's needed.  If things get super complicated, then maybe additional tech stack components might be warranted.

anthonyjchriste, 2019-02-21:
Yes, a list of metrics is probably important. I will start with a high-level definition of what I want to collect and iterate from there.

For each layer in the Laha hierarchy, I want to store the total amount of data within that Layer a set interval. Say, once per minute (but this, like everything else in Laha should be configurable).

Data storage metrics for:
- [ ] instantaneous measurements layer
- [ ] aggregate measurements layers
- [ ] detentions layer
- [ ] incidents layer
- [ ] phenomena layer

I already have code that computes these values, but I am not storing them at a specified interval to see how they change over time.

I also want to collect detailed metrics on plugins
- [ ] How many messages does each plugin receive per time window
- [ ] How many messages does each plugin forward per time window
- [ ] How much data does each plugin receive per message
- [ ] How much data does each plugin forward per message

The above metrics will provide insight on data movement not just between plugins, but also between layers that the plugins operate within.

Finally, I want to collect metrics on CPU, memory, and network utilization over time for Mauka.

philipmjohnson, 2019-02-21:
This is a good start.  I don't see any technical reason to gather this data more frequently than once per hour, and once per day is probably good enough. I think a reasonable approach is to create a new Mongo collection called something like "MaukaMetrics" along with a timer-based process that wakes up once a day, computes these values, creates a single document, and inserts it. Some of the document fields might be objects so that they can be extended without impacting the schema.  The counts for plugins is a good example: you don't want to change the schema each time you add a new plugin.

Closed 2019-04-12.

Thread 227 (2019-02-27):

Convert OPQ Cloud services to use JSON configuration files

philipmjohnson, 2019-02-27:
Please do work for this task in a branch called issue-227.

Currently, OPQ View uses a JSON file to specify configuration settings. This is more convenient to manage than environment variables.  Let's use that approach consistently for all OPQ Cloud services.

## Proposed approach

  1. Create a top-level 'config' directory in your service implementation (i.e. opq/mauka/config, opq/makai/config, etc.)

  2. Inside that directory, create a file called mauka.config.json (or makai.config.json, etc).  These hold your "developer" configuration values. You can have one or many config files, whatever makes most sense to you.

  3. Update the service code to obtain all configuration values from this json file, which will generally be made available to the service as the contents of a single env var called <SERVICE>_SETTINGS.

  4. In the openpowerquality/docker repo, create a config/ directory, with subdirectories for each service (view, mauka, makai, health, boxupdater). Put in your config file(s) with "default" settings (which might be empty strings in the case of usernames, hostnames, or passwords).

  5. Update docker-compose scripts and files to provide these config files to services.

  6. Update https://openpowerquality.org/docs/cloud-installation.html#edit-configuration-files with documentation on any *required* edits to the default config files in order to bring up a new OPQ Cloud instance in a new host.

  7. Edit your developer level documentation (i.e. https://openpowerquality.org/docs/cloud-mauka.html) to provide complete documentation of these configuration variables and their appropriate values.

Thread 228 (2019-02-28):

Create a user interface for display of incidents and phenomena

anthonyjchriste, 2019-02-28:
Please do work for this task in a branch called issue-228.

Currently View only displays events which may or may not contain PQ issues. Events are analyzed in Mauka to produce incidents and phenomena. These contain actual classifications of PQ issues and are intended to provide more information about PQ phenomena.

Please add the ability to display, search, and filter incidents to View.

aghalarp, 2019-04-02:
Incidents UI has been completed. Once Phenomena are implemented, it should be relatively straight forward to adapt the IncidentInspector and IncidentViewer components to work with the Phenomena data model.

Closed 2019-04-09.

Thread 229 (2019-02-28):

Ignore "type" field for events in View

anthonyjchriste, 2019-02-28:
Please do work for this task in a branch called issue-229.

Currently, all events are displayed with a type of "VOLTAGE_SAG". This is because View requires the type field to be populated in order to display events.

However, we are no longer performing any classification in events. Makai does not support event types while triggering. Classification is only performed in incidents and higher.

Please remove the display for events that show the event type. Also please allow events to be displayed if the event type field is not populated.

aghalarp, 2019-04-02:
All instances of `Event.type` has been removed from View.

Closed 2019-04-02.

Thread 230 (2019-02-28):

Create a user interface to define triggering thresholds per box

anthonyjchriste, 2019-02-28:
Please do work for this task in a branch called issue-230.

Currently, triggering thresholds are set statically once for all boxes. We want to allow triggering thresholds to be dynamically set from View.

Create an interface for View (or update an existing one) that allows triggering thresholds to be set for individual boxes. These thresholds should then be stored in MongoDB so that Makai can read them when performing triggering.

The current list of required values are the following:
- reference voltage
- percent_voltage_threshold_low
- percent_voltage_threshold_high
- min_voltage_duration_ms
- reference_frequency
- percent_frequency_threshold_low
- percent_frequency_threshold_high
- min_frequency_duration_ms
- percent_thd_threshold_high
- min_thd_duration_ms

Also see #231.

Closed 2019-05-29.

Thread 232 (2019-02-28):

Set private key in makai configuration

anthonyjchriste, 2019-02-28:
Please do work for this task in a branch called issue-XXX.

Currently, the private and public key paths are defined in makai configuration files. Instead of defining the path to the keys, store the key itself directly in the configuration.

Thread 234 (2019-03-01):

Fix broken Edit buttons in View Admin management pages

philipmjohnson, 2019-03-01:
Please do work for this task in a branch called issue-234.

Seems like admin entities (users, opq boxes, regions, locations) cannot be edited because the edit button does not work.  Fix this.

- [x] Location editing fixed
- [x] OPQ Box editing fixed
- [x] User editing fixed
- [x] Region editing fixed

aghalarp, 2019-03-01:
I briefly investigated this a couple days ago. Not sure if this is of any help, but it seems like the root of this problem is that edit urls are being passed as ObjectID objects, rather than their string representations. I believe you can use the `ObjectID.toHexString()` function to just grab the _id as a string, and use that in all the edit urls.

Subsequently, if you need to query Mongo by an actual ObjectID object, you can just just create one with `new Mongo.ObjectID()`. In the case of these edit buttons, we are receiving the _id from the url, so this will probably look like `new Mongo.ObjectID(match.params._id)`.

philipmjohnson, 2019-03-01:
Fixed locations and Users.  OPQ Boxes was actually working from the start. Region management is not even implemented so nothing to "fix".

Closed 2019-03-01.

Thread 235 (2019-03-03):

Specify schemas for collections on system startup

philipmjohnson, 2019-03-03:
Please do work for this task in a branch called issue-234.

As of Mongo 3.6, it's possible to specify schemas for collections:

https://docs.mongodb.com/manual/core/schema-validation/

This seems like a Good Thing for us to add as part of starting up a fresh MongoDB instance: create all the collections, and attach schemas to ensure that the data conforms. Then it will be much easier to know that our Data Model chapter actually conforms to the contents of the database:

https://openpowerquality.org/docs/cloud-datamodel.html

philipmjohnson, 2019-03-06:
Looks like we already have a "database bootstrap script" which ensures that indexes are created.  This might be the place to add collection definitions along with their associated schemas?

anthonyjchriste, 2019-03-06:
It's just a JS file that creates the indexes: https://github.com/openpowerquality/opq/blob/master/util/mongod/ensure_indexes.js

I'm not sure if it's a great place to store the schemas or not.

anthonyjchriste, 2019-03-06:
There is an associated script as well: https://github.com/openpowerquality/opq/blob/master/util/mongod/ensure_indexes.sh

It's currently not integrated with the mongo docker. Should probably somehow be integrated with the mongo docker to be called every time the mongo docker image starts.

philipmjohnson, 2019-03-06:
Interesting.  A couple of thoughts:

* Perhaps we need a top-level directory called "mongodb" in which stuff related to the :mango: service is stored.  Since Mongo is a first class OPQ Cloud service, it seems like it deserves its own top-level directory in opq.

* The ensure-indexes.js file seems to assume that the collections have already been defined?  Perhaps we need to rename this file to "mongodb-init.js", and have it ensure that the collections have been defined, plus ensure that the schemas are attached, plus ensure that indexes are defined?

philipmjohnson, 2019-03-06:
Agree that this "Mongo Initialization Script" needs to be integrated into Docker.

philipmjohnson, 2019-03-22:
Looks like the measurements collection needs an index on its timestamp_ms field.

Thread 239 (2019-03-06):

Figure out how to load config files as environment variables in semaphore

anthonyjchriste, 2019-03-06:
Please do work for this task in a branch called issue-239.

CI tests are currently failing because the tests are trying to load a configuration file from the environment which currently doesn't exists within semaphore.

Update semaphore to load the dev config into the environment before unit tests are ran.

Closed 2019-03-06.

Thread 242 (2019-03-07):

Calibrate lab devices

sergey-negrashov, 2019-03-07:
Calibrate lab devices against the new meter.

sergey-negrashov, 2019-03-13:
All devices calibrated, cal constants propagated to mongo

Closed 2019-03-13.

Thread 247 (2019-03-21):

Implement TTLs on all collections.

anthonyjchriste, 2019-03-21:
Please do work for this task in a branch called issue-247.

Currently, TTL is implemented (but not working) for measurements.

Please implement TTL for all collections as defined by Laha and set in the laha_config mongo collection.

- [x] Measurements
- [x] Trends
- [x] Events / Box Events / Associated GridFS
- [x] Incidents / Associated GridFS
- [x] Phenomena

Closed 2019-05-07.

Thread 252 (2019-04-12):

V4 Box

philipmjohnson, 2019-04-12:
Please do work for this task in a branch called issue-252.

Create the schematics for the V4 box. This one fits without filing. Screen and button as optional features.

Thread 256 (2019-05-07):

Investigate the failure to create new threads in Mauka

anthonyjchriste, 2019-05-07:
Please do work for this task in a branch called issue-256.

Currently, certain Mauka plugins fail after a seemingly random amount of time. Logs indicate that failure is due to failure to create new threads. This must mean there are already too many threads or we're running into memory issues.

- [ ] Determine cause of this issue
- [ ] Find a way to mitigate this issue

anthonyjchriste, 2019-05-16:
This has ceased to be a problem ever since we replaced the mongo health service and freed up a bunch of CPU and memory resources.

Closed 2019-05-16.

Thread 257 (2019-05-16):

Fix bug in Mauka's MakaiEventPlugin

anthonyjchriste, 2019-05-16:
Please do work for this task in a branch called issue-257.

We are currently receiving the following error in Mauka:

```
Exception in thread Thread-8294:
Traceback (most recent call last):
  File "/usr/local/lib/python3.7/threading.py", line 917, in _bootstrap_inner
    self.run()
  File "/usr/local/lib/python3.7/threading.py", line 1166, in run
    self.function(*self.args, **self.kwargs)
  File "/build/mauka/plugins/makai_event_plugin.py", line 282, in acquire_and_produce
    self.down_sample_factor)
  File "/build/mauka/plugins/makai_event_plugin.py", line 238, in acquire_data
    filter_down_sample_factor),
  File "/build/mauka/plugins/makai_event_plugin.py", line 139, in frequency_waveform
    downsample_factor=down_sample_factor)
  File "/build/mauka/plugins/makai_event_plugin.py", line 49, in smooth_waveform
    return signal.decimate(sample, downsample_factor, ftype=dtltis)
  File "/usr/local/lib/python3.7/site-packages/scipy/signal/signaltools.py", line 3485, in decimate
    y = filtfilt(b, a, x, axis=axis)
  File "/usr/local/lib/python3.7/site-packages/scipy/signal/signaltools.py", line 3126, in filtfilt
    ntaps=max(len(a), len(b)))
  File "/usr/local/lib/python3.7/site-packages/scipy/signal/signaltools.py", line 3176, in _validate_pad
    "padlen, which is %d." % edge)
ValueError: The length of the input vector x must be at least padlen, which is 15.

```

Investigate and fix the cause of the error.

anthonyjchriste, 2019-05-16:
After some investigation, it appears that this might actually be caused by Makai. Looking at the DB reveals that the most recent events are storing events of length 0, meaning the files don't actually hold anything and is why the makai_event plugin is freaking out.

anthonyjchriste, 2019-05-16:
The data was from a test box and is not an issue for other boxes.

anthonyjchriste, 2019-05-18:
To further elaborate, development data from a test box accidentally made its way to emilia while Makai was being tested.

Closed 2019-05-16.

Thread 260 (2019-05-18):

Event Inspector Details Page: Waveform toggle does not work

philipmjohnson, 2019-05-18:
Please do work for this task in a branch called issue-260.

In the Event Inspector Details Page:

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

Clicking the Waveform toggle does not work and throws the following error:

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

anthonyjchriste, 2019-05-18:
This is  a result of #257 . I will remove the bad events from the database, though I think this is a perfect example of an anti-phenomena as detailed in #258 .

Thread 264 (2019-07-18):

Fix threshold trigger plugin in Makai to properly trigger on THD

anthonyjchriste, 2019-07-18:
Please do work for this task in a branch called issue-264.

Currently, the triggering plugin in Makai checks the THD threshold against a percent (e.g. is the THD > 5%) however, the values provided by makai are in decimal percent (i.e. .05). Update either the code or the configuration to work with decimal percent values for THD.

Closed 2019-07-18.

Thread 265 (2019-07-19):

Add the ability for Mauka to trigger devices

anthonyjchriste, 2019-07-19:
Please do work for this task in a branch called issue-265.

Currently, only Makai is able to trigger devices for raw data, however it's a goal of Mauka to be able to trigger devices as well for parts of its phenomena analysis.

Add the ability for Mauka to trigger and manage data streams from devices by sending data commands to makai and listening to Makais acquisition endpoint to retrieve the raw data.

anthonyjchriste, 2019-08-29:
So the first half of this has been finished, now we need to propagate the new events to the makai_event_plugin. Since the makai_event_plugin already works with normal events from the DB, I don't want to create a new collection specific to Mauka triggered events (although this metadata is included in the events so that we know it was triggered by Mauka).

This requires that Mauka build it's own event storage since Makai was handling it for its triggers. This brings up an interesting question. How do we handle assigning atomic event_ids from two separate processes?

The cleanest solution is to extend Makai's event_id service so that Mauka can request event_id's from Makai, keeping event_id generation in one place and preventing race conditions.

anthonyjchriste, 2019-08-30:
Event storage is finished. Makai's event_id service has been extended to provide atomic event_ids to Mauka through a ZMQ channel.

Closed 2019-08-30.

Thread 266 (2019-07-26):

Investigate and possibly disable spurious events from health

anthonyjchriste, 2019-07-26:
Please do work for this task in a branch called issue-XXX.

Currently, we are receiving multiple daily events from health for Mongo that appear to be spurious. Check to determine if these are indeed spurious, and if they are, disable them.

Thread 267 (2019-07-31):

Implement ground truth collection from BluePillar API

anthonyjchriste, 2019-07-31:
Please do work for this task in a branch called issue-267.

We've been provided read-only API access to the BluePillar multisite for collecting ground truth from power meters at UH.

Write a new service in opq that collects ground truth data from relevant sensors once per hour and stores this data to the database using the current ground truth schema.

anthonyjchriste, 2019-08-22:
Not happening, but we're scraping the web page still.

Closed 2019-08-22.

Thread 269 (2019-08-29):

Implement threshold optimization plugin.

anthonyjchriste, 2019-08-29:
Please do work for this task in a branch called issue-269.

Implement a Mauka plugin that can dynamically change triggering thresholds based off of expected or predicted events where an signal of interest may occur but may not be seen due to current thresholds for that device.

Thresholds are already dynamically loaded from mongo in Makai, but there isn't currently a way to edit those thresholds that isn't manual. This plugin will allow phenomena to edit these thresholds dynamically.

The plugin should receive a message that specifies a box id and a set of thresholds to modify.

anthonyjchriste, 2019-09-03:
Plugin is implemented and running in production.

Closed 2019-09-03.

Thread 271 (2019-09-20):

Address spurious Incident creation at EPRI

philipmjohnson, 2019-09-20:
Please do work for this task in a branch called issue-267.

Jason Johns reports that "excessive frequency triggering" is occurring. See screen shots:

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

How should we respond?

Thread 273 (2019-10-24):

Improve segmentation of voltage values.

anthonyjchriste, 2019-10-24:
Please do work for this task in a branch called issue-273.

Currently segmentation is performed naively, however there are much better methods for performing change step detection. Implement segmentation for voltage values using the ruptures library (https://github.com/deepcharles/ruptures).

Closed 2019-10-25.

Thread 275 (2019-10-28):

Identify and address issues with IEEE1159 Voltage Plugin

anthonyjchriste, 2019-10-28:
Please do work for this task in a branch called issue-275.

We have not identified Voltage sags or swells in quite some time. Refactor and test the Voltage plugin so that it can reliable detect sags and swells as defined by IEEE1159. This may involve making use of the new segmentation algorithm introduced in the Semi F47 and ITIC plugins.

Closed 2019-11-06.
