openpowerquality/opq/box/Schematics/v2/opqbox2_schematic.pdf

D

6 | 5 | 4 | 3 | 2 | 1

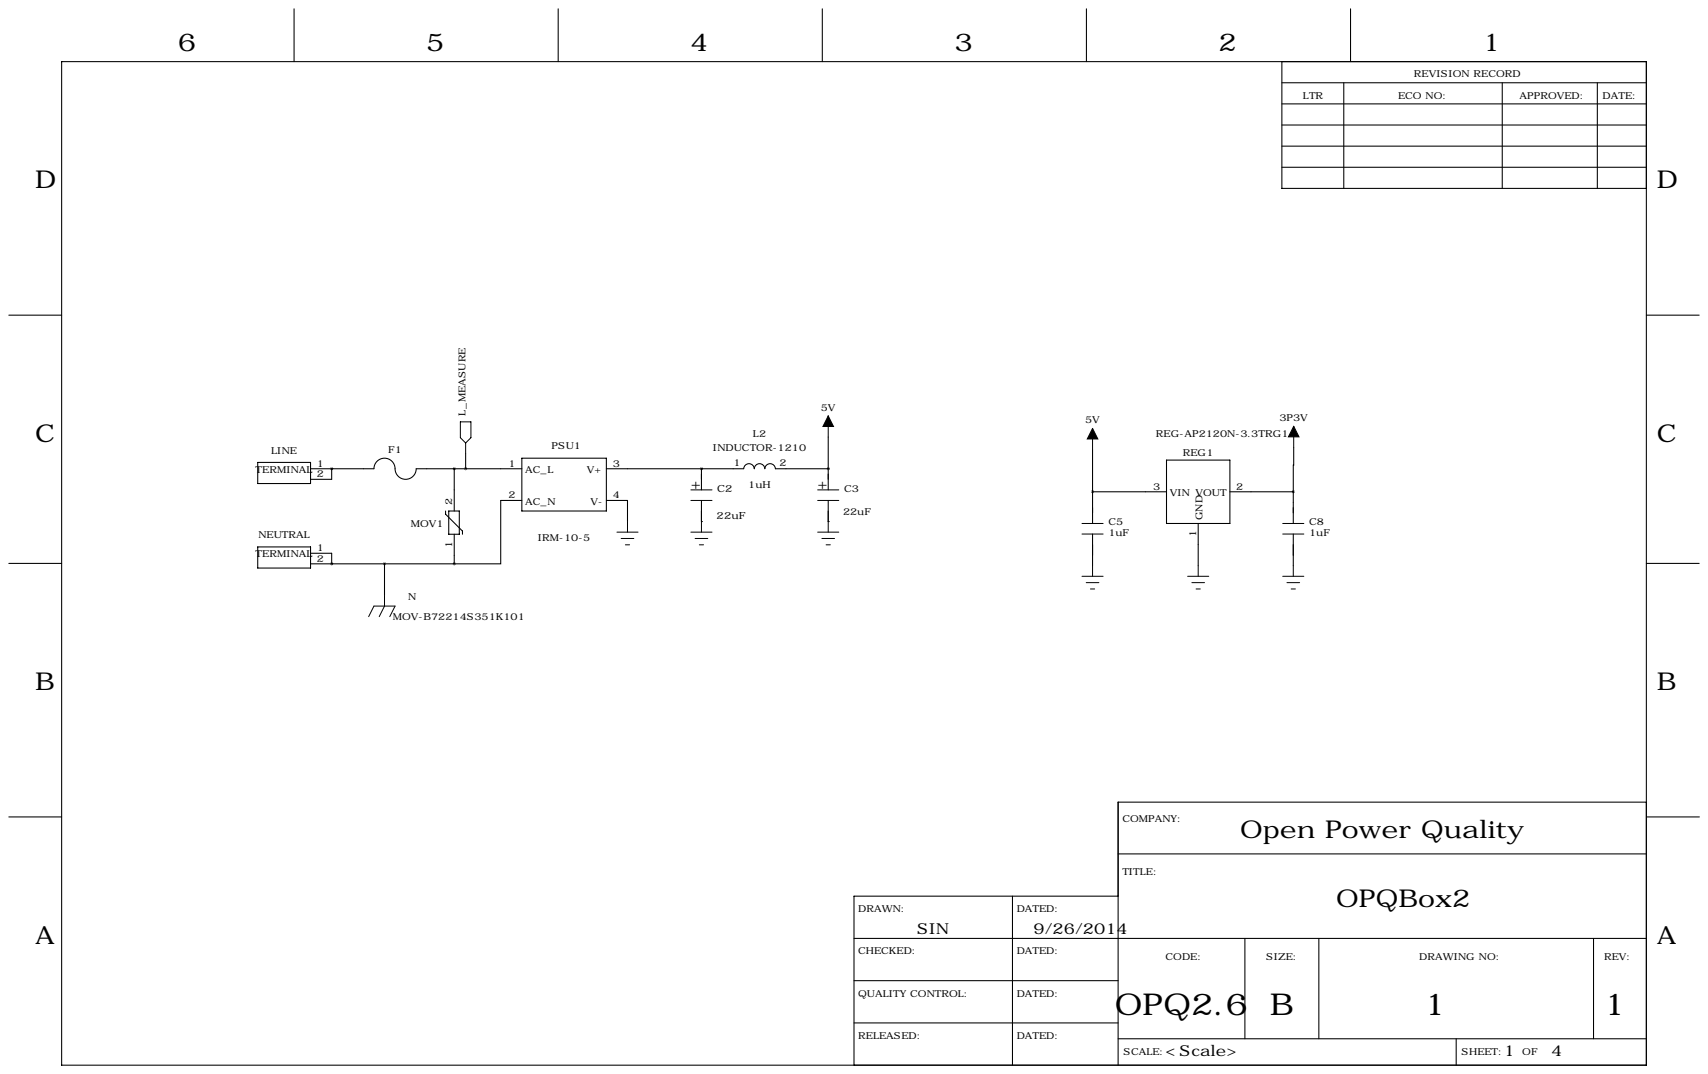
[picture p17: page 1]
OPQBox2; COMPANY:; TITLE:; MOV1; MOV-B72214S351K101; L2 INDUCTOR-1210; LINE; TERMINAL; NEUTRAL; PSU1; IRM-10-5; VIN; VOUT 1 GND; REG1; REG-AP2120N-3.3TRG1; L_MEASURE

REVISION RECORD

LTR | ECO NO: | APPROVED: | DATE:

Open Power Quality

DRAWN: SIN | DATED: 9/26/2014
CHECKED: | DATED: OPQ2.6 | CODE: | SIZE: B | DRAWING NO: 1 | REV: 1

QUALITY CONTROL: | DATED:

RELEASED: | DATED:

<Scale> SCALE: | 1 4 SHEET: OF

D

D

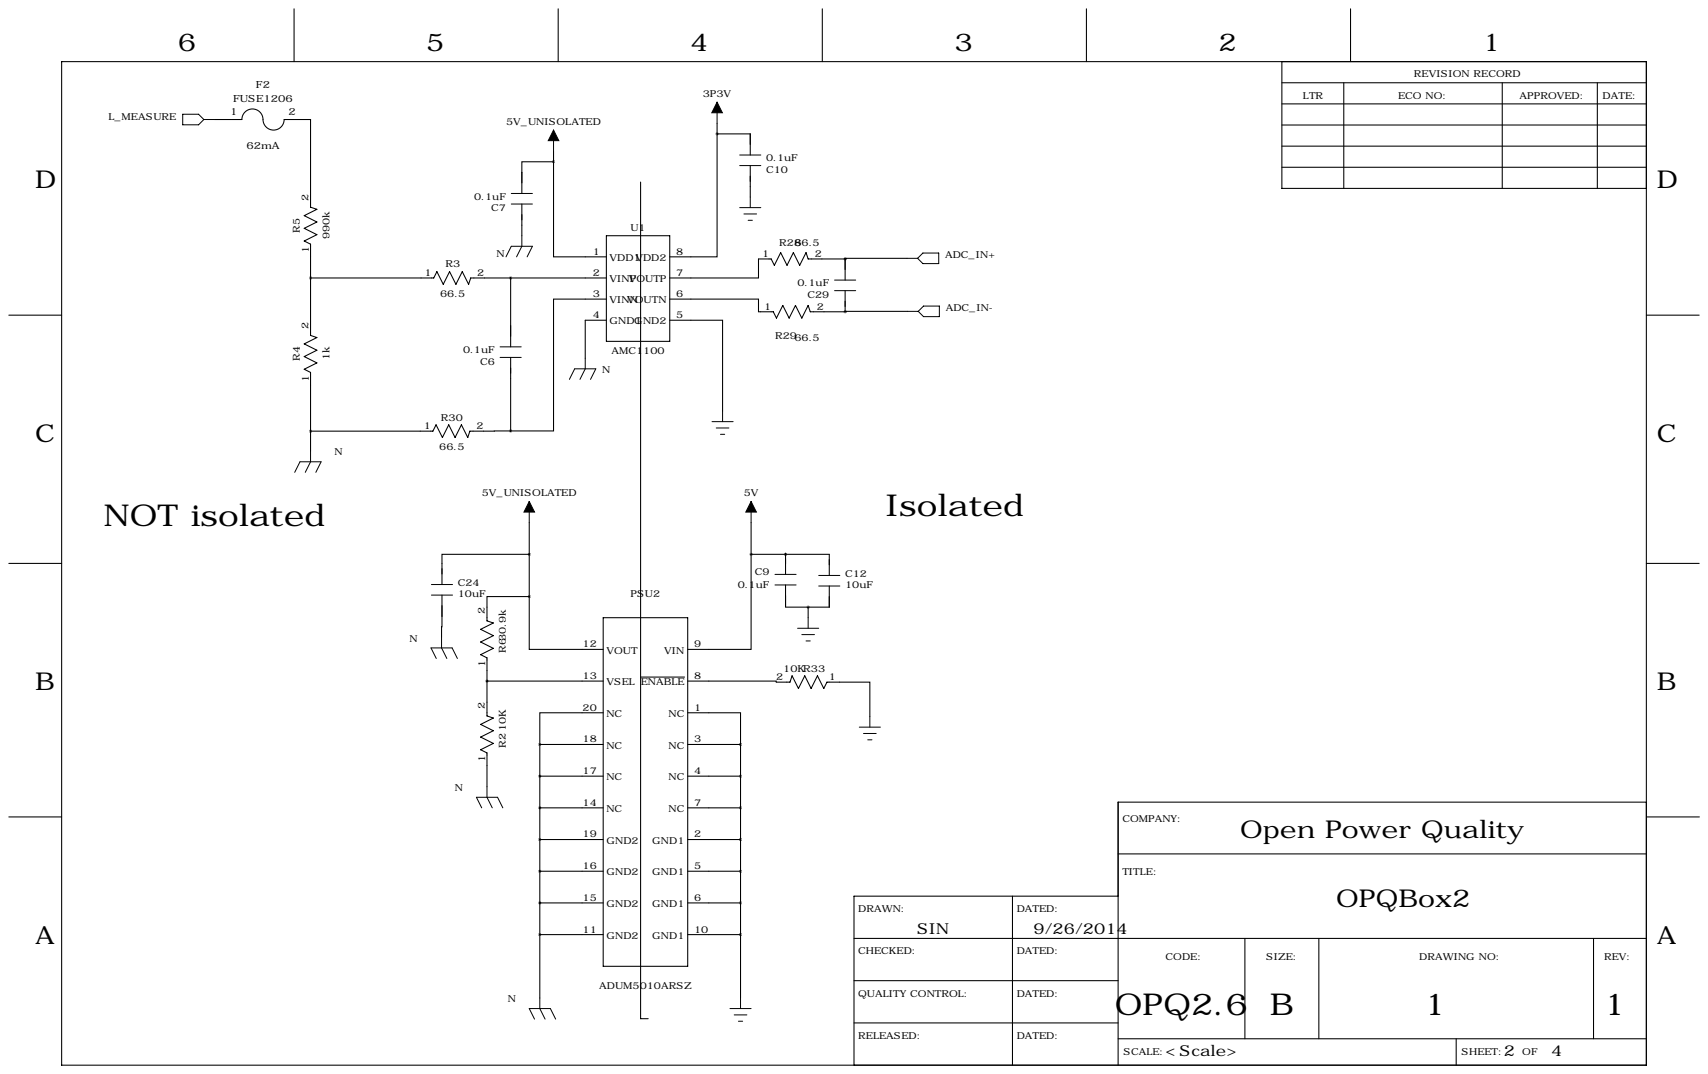
[picture p18: page 2]

3P3V | REVISION RECORD

LTR | ECO NO: | APPROVED: | DATE:

DRAWN: SIN | DATED: 9/26/2014
CHECKED: | DATED: OPQ2.6 B | CODE: | SIZE: | DRAWING NO: 1 | REV: 1

QUALITY CONTROL: | DATED:

D

D

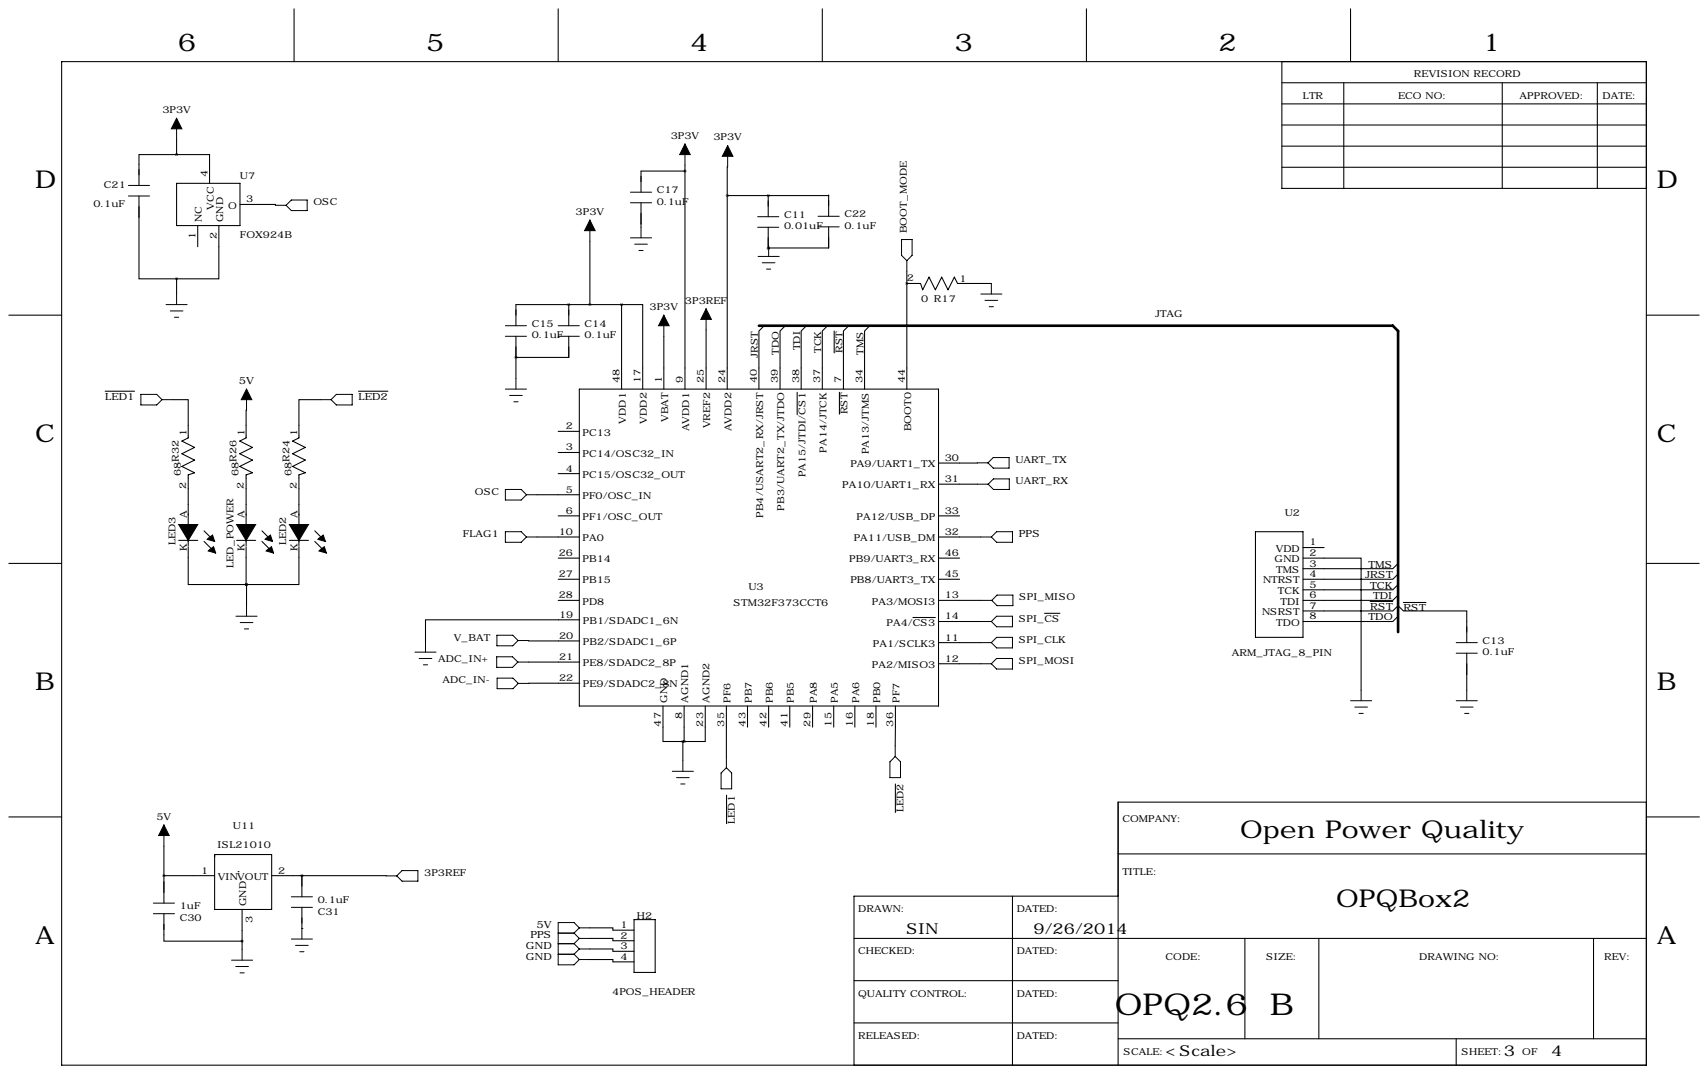
[picture p19: page 3]

3P3V | REVISION RECORD

LTR | ECO NO: | APPROVED: | DATE:

DRAWN: SIN | DATED: 9/26/2014
CHECKED: | DATED: OPQ2.6 | CODE: | SIZE: B | DRAWING NO: | REV:

QUALITY CONTROL: | DATED:

D

D

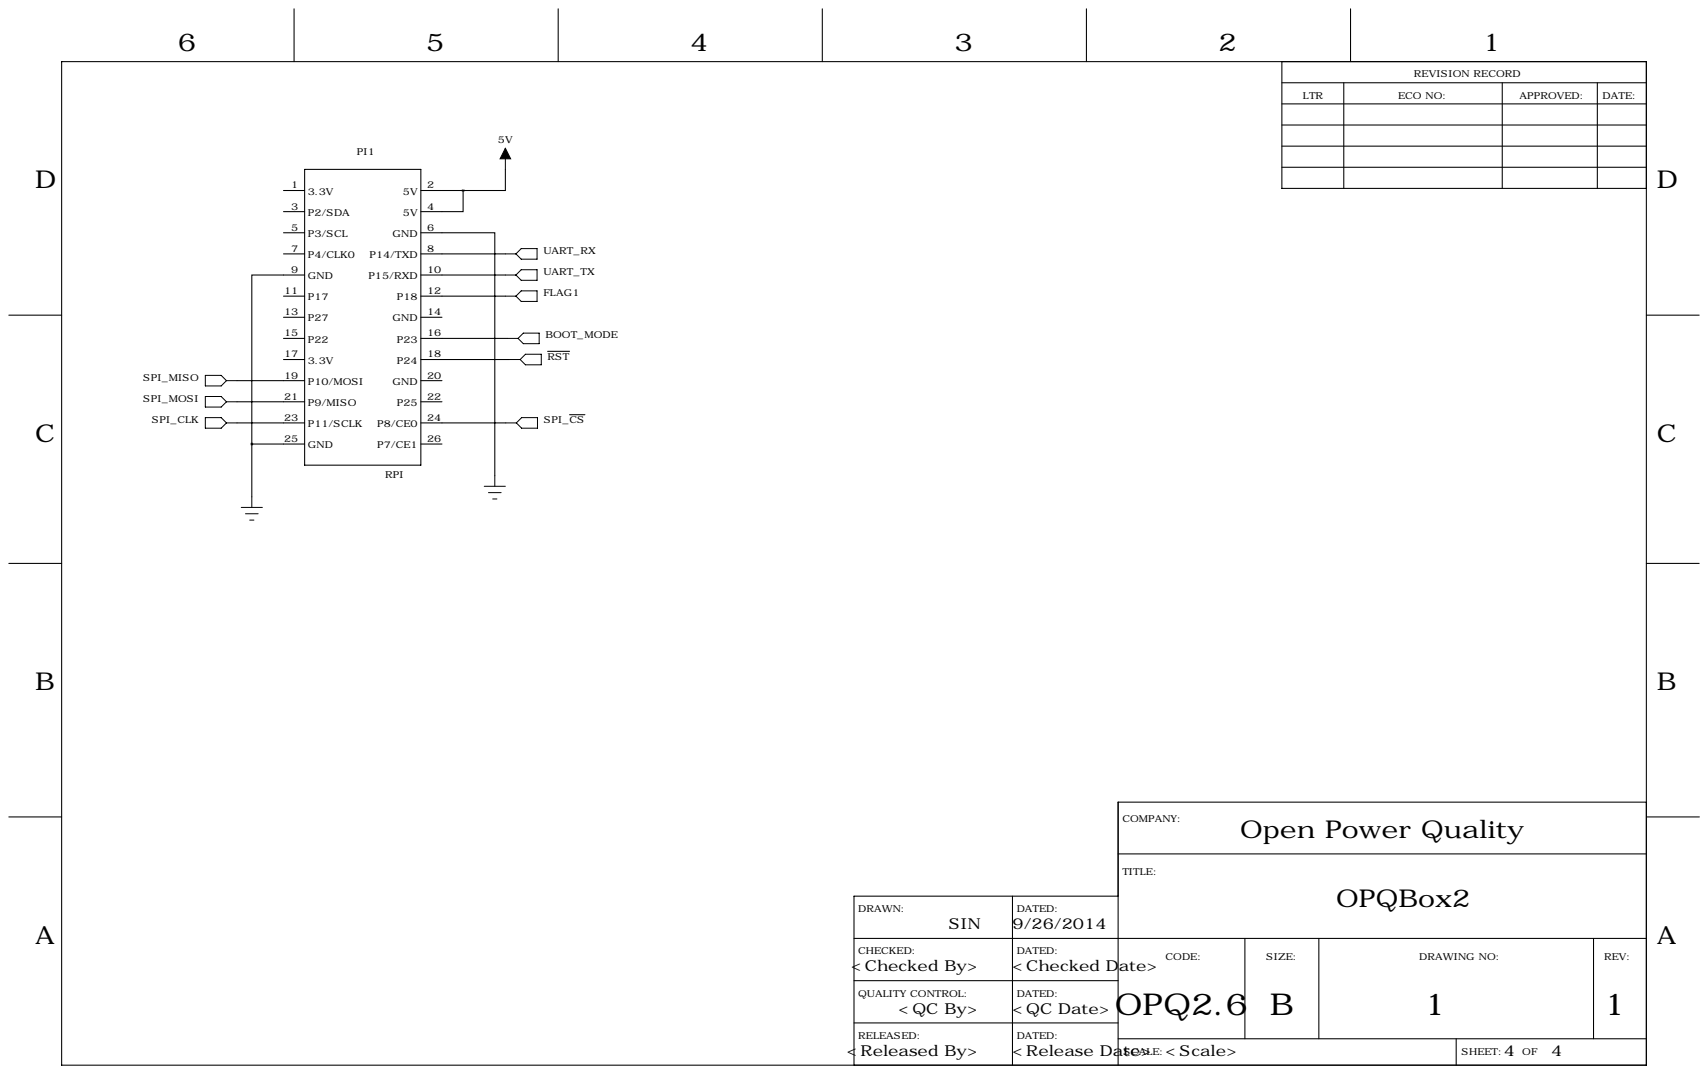
[picture p20: page 4]
<Released By>; <Release Date>; OPQBox2; <Scale>; COMPANY:; TITLE:; P2/SDA; P3/SCL; P4/CLK0; GND; P10/MOSI; P9/MISO; P11/SCLK; 5V 6 GND; P14/TXD 10 P15/RXD; 14 GND; 20 GND; RPI; UART_RX; UART_TX; FLAG1; SPI_CS; SPI_MISO; SPI_MOSI; SPI_CLK; BOOT_MODE; RST

5V | REVISION RECORD

LTR | ECO NO: | APPROVED: | DATE:

Open Power Quality

DRAWN: SIN | DATED: 9/26/2014
CHECKED: <Checked By> | DATED: <Checked Date> OPQ2.6 | CODE: | SIZE: B | DRAWING NO: 1 | REV: 1

QUALITY CONTROL: <QC By> | DATED: <QC Date>
