openpowerquality/opq/(list of files, drawings)

Other design files:
box/Schematics/v2/opqbox2.pcb
