openpowerquality/opq/mauka/plugins/mock.py

#!/usr/bin/env python3

"""
This module allows us to mock and inject any (topic, message) pair into the Mauka system.
"""

import json
import os
import sys
import logging
import time
import typing

import zmq

_logger = logging.getLogger("app")
logging.basicConfig(
    format="[%(levelname)s][%(asctime)s][{} %(filename)s:%(lineno)s - %(funcName)s() ] %(message)s".format(
        os.getpid()))


def produce(broker: str, topic: str, message: str = None, message_bytes=None):
    """
    Produces a message to the provided broker.
    The message can either be a string or bytes, but not both.
    :param broker: The URL of the ZMQ message broker.
    :param topic: The topic of the message.
    :param message:  The message as a string.
    :param message_bytes: The message as bytes.
    """
    _logger.info("Producing %s:%s to %s", topic, message, broker)
    zmq_context = zmq.Context()
    zmq_pub_socket = zmq_context.socket(zmq.PUB)
    zmq_pub_socket.connect(broker)
    time.sleep(0.1)  # We need to sleep while the handshake takes place
    if message is not None:
        zmq_pub_socket.send_multipart((topic.encode(), message.encode()))
    else:
        zmq_pub_socket.send_multipart((topic.encode(), message_bytes))


if __name__ == "__main__":
    def load_config(path: str) -> typing.Dict:
        """Loads a configuration file from the file system

        :param path: Path of configuration file
        :return: Configuration dictionary
        """
        try:
            with open(path, "r") as f:
                return json.load(f)
        except FileNotFoundError:
            _logger.error("usage: ./mock.py config topic message")
            exit(0)

    if len(sys.argv) != 4:
        sys.exit("usage: ./mock.py config topic message")

    config = load_config(sys.argv[1])
    topic = sys.argv[2]
    message = sys.argv[3]
    broker = config["zmq.mauka.plugin.pub.interface"]
    produce(broker, topic, message)
