openpowerquality/opq/mauka/plugins/base_plugin.py

"""
This module provides classes and base functionality for building OPQMauka plugins.
"""
import enum
import json
import multiprocessing
import signal
import threading
import time
import typing

# noinspection PyPackageRequirements
import bson
# noinspection PyPackageRequirements
import bson.objectid
import zmq

import config
import log
import mongo
import protobuf.mauka_pb2
import protobuf.pb_util

# pylint: disable=C0103
logger = log.get_logger(__name__)


def run_plugin(plugin_class, conf: config.MaukaConfig):
    """Runs the given plugin using the given configuration dictionary

    :param plugin_class: Name of the class of the plugin to be ran
    :param conf: Configuration dictionary
    """

    def _run_plugin():
        """Inner function that acts as target to multiprocess constructor"""
        plugin_instance = plugin_class(conf)
        plugin_instance.run_plugin()

    process = multiprocessing.Process(target=_run_plugin)
    process.start()
    return process


class JSONEncoder(json.JSONEncoder):
    """
    This class allows us to serialize items with ObjectIds to JSON
    """

    # https://github.com/PyCQA/pylint/issues/414
    # pylint: disable=E0202
    def default(self, o):
        """If o is an object id, return the string of it, otherwise use the default encoder for this object

        :param o: Object to serialize
        :return: Serialized version of this object
        """
        if isinstance(o, bson.ObjectId):
            return str(o)
        return json.JSONEncoder.default(self, o)


def from_json(json_str: str) -> typing.Dict:
    """Deserialize json into dictionary

    :param json_str: JSON string to deserialize
    :return: Dictionary from json
    """
    return json.loads(json_str)


def to_json(obj: object) -> str:
    """Serializes the given object to json

    :param obj: The object to serialize
    :return: JSON representation of object
    """
    return json.dumps(obj, cls=JSONEncoder)


class PluginState(enum.Enum):
    """
    Enum for specifying plugin state.
    """
    IDLE = "IDLE"
    BUSY = "BUSY"


class MaukaPlugin:
    """
    This is the base MaukaPlugin class that provides easy access to the database and also provides publish/subscribe
    semantics and distributed processing primitives.
    """

    NAME = "MaukaPlugin"

    def __init__(self, conf: config.MaukaConfig, subscriptions: typing.List[str], name: str,
                 exit_event: multiprocessing.Event):
        """ Initializes the base plugin

        :param conf: Configuration dictionary
        :param subscriptions: List of subscriptions this plugin should subscribe to
        :param name: The name of this plugin
        """

        self.config = conf
        """Configuration dictionary"""

        self.subscriptions = subscriptions
        """Plugin subscriptions"""

        self.name = name
        """Plugin name"""

        self.exit_event = exit_event
        """Multiprocessing primitive that when set allows us to easily exit a process or thread"""

        self.mongo_client = self.get_mongo_client()
        """MongoDB OPQ client"""

        self.zmq_context = zmq.Context()
        """ZeroMQ context"""

        # noinspection PyUnresolvedReferences
        # pylint: disable=E1101
        self.zmq_consumer = self.zmq_context.socket(zmq.SUB)
        """ZeroMQ consumer"""

        # noinspection PyUnresolvedReferences
        # pylint: disable=E1101
        self.zmq_producer = self.zmq_context.socket(zmq.PUB)
        """ZeroMQ producer"""

        self.heartbeat_interval_s = float(self.config.get("plugins.base.heartbeatIntervalS"))
        """How often in seconds this plugin should produce a heartbeat"""

        self.on_message_cnt = 0
        """Number of times this plugin has received a message since starting"""

        self.last_received = 0
        """Timestamp since this plugin has last received a message"""

        self.logger = logger
        """Provides access to a single configured logger all plugins can use"""

        self.producer_lock = multiprocessing.Lock()
        """Lock that ensures the base plugin is thread safe while producing messages"""

        self.zmq_consumer.connect(self.config.get("zmq.mauka.plugin.sub.interface"))
        self.zmq_producer.connect(self.config.get("zmq.mauka.plugin.pub.interface"))

        # Every plugin subscribes to itself to allow for plugin control
        self.subscriptions.append(name)

        self.mauka_debug = self.config.get("mauka.debug")

        self.messages_received: int = 0
        self.messages_published: int = 0
        self.bytes_received: int = 0
        self.bytes_published: int = 0

        self.plugin_state: str = PluginState.IDLE.name

        # ZMQ channel for getting incident ids
        self.zmq_incident_id_req_socket = self.zmq_context.socket(zmq.REQ)
        self.zmq_incident_id_req_socket.connect(self.config.get("zmq.incident_id_provider.req.interface"))

    # pylint: disable=E1101
    def request_next_available_incident_id(self) -> typing.Optional[int]:
        """
        Requests the next available incident id from the incident id provider service.
        :return: The next available incident id or None.
        """
        req_id = int(time.time())
        req = protobuf.pb_util.build_incident_id_req(self.name, req_id)
        self.zmq_incident_id_req_socket.send(protobuf.pb_util.serialize_message(req))
        resp: bytes = self.zmq_incident_id_req_socket.recv()
        mauka_message: protobuf.mauka_pb2.MaukaMessage = protobuf.pb_util.deserialize_mauka_message(resp)
        if protobuf.pb_util.is_incident_id_resp(mauka_message):
            if mauka_message.incident_id_resp.resp_id == req_id:
                return mauka_message.incident_id_resp.incident_id
            else:
                self.logger.error("Incident req id %d != incident resp id %d",
                                  req_id,
                                  mauka_message.incident_id_resp.resp_id)
                return None
        else:
            self.logger.error("Received an incorrect message for an incident id response")
            return None

    def update_received(self, bytes_received: int):
        """
        Update received statistics.
        :param bytes_received: Number of bytes received.
        """
        self.messages_received += 1
        self.bytes_received += bytes_received

    def update_published(self, bytes_published: int):
        """
        Update published statistics.
        :param bytes_published: Number of bytes published.
        """
        self.messages_published += 1
        self.bytes_published += bytes_published

    # pylint: disable=R0201
    def get_status(self) -> str:
        """ Return the status of this plugin
        :return: The status of this plugin
        """
        return json.dumps({"messages_received": self.messages_received,
                           "messages_published": self.messages_published,
                           "bytes_received": self.bytes_received,
                           "bytes_published": self.bytes_published})

    def get_mongo_client(self):
        """ Returns an OPQ mongo client

        :return: An OPQ mongo client
        """
        mongo_host = self.config.get("mongo.host")
        mongo_port = self.config.get("mongo.port")
        mongo_db = self.config.get("mongo.db")
        return mongo.OpqMongoClient(mongo_host, mongo_port, mongo_db)

    def start_heartbeat(self):
        """
        This is a recursive function that acts as a heartbeat.

        This function calls itself over-and-over on a timer to produce heartbeat messages. The interval can be
        configured is the configuration file.
        """

        start_after_seconds = 5.0

        def heartbeat():
            """
            Recursively produces a heartbeat message on a timer.
            """
            heartbeat_message = protobuf.pb_util.build_heartbeat(self.name,
                                                                 self.last_received,
                                                                 self.on_message_cnt,
                                                                 self.get_status(),
                                                                 self.plugin_state)
            self.produce("heartbeat", heartbeat_message)
            timer = threading.Timer(self.heartbeat_interval_s, heartbeat)
            timer.start()

        threading.Timer(start_after_seconds, heartbeat).start()

    # pylint: disable=W0613
    # pylint: disable=R0201
    def on_message(self, topic: str, mauka_message: protobuf.mauka_pb2.MaukaMessage):
        """This gets called when a subscriber receives a message from a topic they are subscribed too.

        This should be implemented in all subclasses.

        :param topic: The topic this message is associated with
        :param mauka_message: The message contents
        """
        logger.info("on_message not implemented")

    def produce(self, topic: str, mauka_message: protobuf.mauka_pb2.MaukaMessage):
        """Produces a message with a given topic to the system

        :param topic: The topic to produce this message to
        :param mauka_message: The message to produce
        """
        serialized_mauka_message = protobuf.pb_util.serialize_message(mauka_message)
        with self.producer_lock:
            self.zmq_producer.send_multipart((topic.encode(), serialized_mauka_message))

        self.update_published(len(serialized_mauka_message))

    def is_self_message(self, topic: str) -> bool:
        """Determines if this is a message directed at this plugin. I.e. the topic is the name of the plugin.

        :param topic: Topic of the message
        :return: If this is a self message or not
        """
        return topic == self.name

    def handle_self_message(self, message: str):
        """Handles a self-message

        :param message: The message to handle
        """
        if message == "EXIT":
            self.exit_event.set()

    def set_plugin_state_idle(self):
        """
        Sets the plugin state to IDLE.
        """
        self.plugin_state = PluginState.IDLE.name

    def set_plugin_state_busy(self):
        """
        Sets the plugin state to BUSY.
        """
        self.plugin_state = PluginState.BUSY.name

    def debug(self, msg: str):
        """
        Prints a debug message using this classes logger and formatted the plugin name.
        :param msg: Message to print to debug.
        """
        if self.config.debug_plugin(self.name):
            self.logger.debug("%s\n%s", self.name, msg)

    def run_plugin(self):
        """This is the run loop for this plugin process"""
        logger.info("Starting Mauka plugin: %s", self.name)
        signal.signal(signal.SIGTERM, signal.SIG_IGN)
        signal.signal(signal.SIGINT, signal.SIG_IGN)

        for subscription in self.subscriptions:
            # noinspection PyUnresolvedReferences
            # pylint: disable=E1101
            self.zmq_consumer.setsockopt_string(zmq.SUBSCRIBE, subscription)

        self.start_heartbeat()

        while not self.exit_event.is_set():
            data = self.zmq_consumer.recv_multipart()
            self.set_plugin_state_busy()
            if len(data) != 2:
                logger.error("Malformed data from ZMQ. Data size should = 2, but instead is %s", str(len(data)))
                for data_item in data:
                    logger.error("%s", str(data_item.decode()))
                break

            topic = data[0].decode()
            message = data[1]

            if self.is_self_message(topic):
                logger.info("Receive self message")
                self.handle_self_message(message.decode())
            else:
                # Update statistics
                self.on_message_cnt += 1
                self.last_received = protobuf.pb_util.get_timestamp_ms()
                mauka_message = protobuf.pb_util.deserialize_mauka_message(message)
                self.on_message(topic, mauka_message)
                self.update_received(len(message))

            self.set_plugin_state_idle()

        logger.info("Exiting Mauka plugin: %s", self.name)
