openpowerquality/opq/makai/EventService/src/config.rs

use serde_json::{from_reader, Value};
use std::env;
use std::fs::File;
use std::path::Path;
use uuid::Uuid;

///Representation of the configuration file's required fields.
#[derive(Debug, Serialize, Deserialize, Default)]
pub struct Settings {
    ///zmq endpoint for the acquisition broker.
    pub zmq_data_endpoint: String,
    ///zmq endpoint for event
    pub zmq_event_endpoint: String,
    ///zmq endpoint for event ids
    pub zmq_event_id_endpoint: String,
    ///Mongo endpoint.
    pub mongo_host: String,
    ///Mongo port.
    pub mongo_port: u16,
    ///Makai Instance Identity.
    pub identity: Option<String>,
    ///Plugin specific settings.
    pub plugins: Vec<Value>,
    //TTL cache.
    pub ttl_cache_ttl: u64,
}

impl Settings {
    /// Load the settings file from disk.
    pub fn load_from_file<P: AsRef<Path>>(path: P) -> Result<Settings, String> {
        let file = File::open(path).or(Err("No such file"))?;
        let mut settings: Settings = from_reader(file).unwrap();
        if settings.identity.is_none() {
            settings.identity = Some(Uuid::new_v4().to_string());
        }
        println!(
            "Staring with identity: {}",
            settings.identity.clone().unwrap()
        );
        Ok(settings)
    }

    pub fn load_from_env(env: &str) -> Result<Settings, String> {
        let contents = env::var(env).or(Err("Could not parse config from environment."))?;
        let mut settings: Settings = from_reader(contents.as_bytes()).unwrap();
        if settings.identity.is_none() {
            settings.identity = Some(Uuid::new_v4().to_string());
        }
        println!(
            "Starting with identity: {}",
            settings.identity.clone().unwrap()
        );
        Ok(settings)
    }
}
