openpowerquality/opq/box/Software/kernel/scripts/config.txt

#uncomment to overclock the arm. 700 MHz is the default.
arm_freq=700
enable_uart=1
dtparam=spi=on
dtoverlay=opq
