openpowerquality/opq/util/makai/box_viewer/src/box_response.rs

use zmq;
use protobuf::{parse_from_bytes,ProtobufError};
use crate::proto::opqbox3::{Response, Response_oneof_response};
use crate::config::Settings;
use std::net::SocketAddr;
use std::str::FromStr;
use std::time::{SystemTime};
use std::sync::{Arc, Mutex};
use std::collections::HashMap;

pub struct BoxResponse{
    acq_broker : zmq::Socket,
    ts : Arc<Mutex<HashMap<u32, SystemTime>>>

}

impl BoxResponse {
    pub fn new(config : &Settings, ctx: &zmq::Context, ts : Arc<Mutex<HashMap<u32, SystemTime>>>) -> BoxResponse{
        let rsp = BoxResponse{
            acq_broker: ctx.socket(zmq::SUB).unwrap(),
            ts
        };
        rsp.acq_broker.connect(&config.zmq_data_endpoint).unwrap();
        rsp.acq_broker.set_subscribe(config.identity.clone().unwrap().as_bytes()).unwrap();
        rsp
    }

    pub fn run_loop(&mut self){
        loop{
            let parts = self.acq_broker.recv_multipart(0).unwrap();
            if parts.len() < 2{
                continue;
            }
            let response_result : Result<Response, ProtobufError> = parse_from_bytes(&parts[1]);
            if let Err(_) = response_result {
                continue
            };
            let response = response_result.unwrap();
            if let Response_oneof_response::info_response(info) = &response.response.unwrap() {
                let lock = self.ts.lock().unwrap();
                let sent = lock.get(&(response.box_id as u32)).unwrap();
                print!("Box {} : ", response.box_id);
                let bits : Vec<&str> = info.ip.split("\n").collect();
                for bit in bits {
                    if let Ok(addr) = SocketAddr::from_str(bit) {
                        if !addr.ip().is_loopback() && addr.ip().is_ipv4() && !addr.ip().is_multicast(){
                            print!("{} latency {}us", addr.to_string(), sent.elapsed().unwrap().as_micros())
                        }
                    }
                }
                println!();
            }

        }
    }
}
