openpowerquality/opq/util/makai/store_event/src/error_type.rs

#[derive(Debug, Fail)]
pub enum StoreError {
    #[fail(display = "no such event: {}", id)]
    NoSuchEvent { id: u32 },
    #[fail(display = "Could not create file or directory {}", path)]
    CouldNotCreate { path: String },
}
