openpowerquality/opq/(commit log)

2017-09-06 Initial import for the box and makai
    [BOM.csv, config.txt, opqbox2.dxf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]
2017-09-12 Add heartbeat interval to configuation and add more debug info to catch zmq incorrect length error
    [base.py]
2017-09-14 A couple of fixes to API documentation
2017-09-14 Implement filter form template with customizable fields.
2017-09-14 Implement pub/sub broker in pure python.
    [base.py]
2017-09-14 Rework plugins to provide an exit_event and start pluigins easier
    [FrequencyThresholdPlugin.py, VoltageThresholdPlugin.py, base.py]
2017-09-15 Add kill cli command to stop a plugin that won't stop with normal means
    [manager.py]
2017-09-20 Reorganization of installation material in gitbook.
2017-09-20 Implement filter form validation and add datetime picker widget.
2017-09-20 Attach filter template to event count chart template.
2017-09-20 EventCountChart template can now filter based on given day, through data context.
2017-09-20 Attach an _isRendered ReactiveVar to every rendered template using the aldeed:template-extensions package.
2017-09-21 Make sure acquisition plugin doesn't die when it can't send a req to mauka
    [base.py]
2017-09-25 Add locking to zmq producers to ensure their thread safety. Also cleanup heartbeat code.
2017-09-25 Add extra context information to heartbeats. Also, use logger for heartbeats instead of printing to stdout.
2017-09-26 Move mauka broker into its own namespace
    [broker.py]
2017-09-26 Fixed handling of signals in subprocesses. OpqMauka now completely handles the cleanup up and exit when receiving a SIGINT or SIGTERM.
    [base.py, broker.py, manager.py]
2017-09-28 Add active highlight to currently selected event.
2017-10-09 Working prototype for updater
2017-10-09 mauka: Improved logging for voltage and frequency plugins
2017-10-10 mauka: All print statements have been moved to the logger interface
2017-10-18 mauka: Remove extraneous print statements from event reader
2017-11-01 Implement helper function to transform mongo results into Dygraph's require data format. Additional method for accessing device measurements.
2017-11-15 Add box constants to mauka for analysis which also incudes calibration constants
2017-11-15 Clean up calibration constant code and add direct link to calibration constants collection
2017-11-15 Add calibration routine to base plugin
2017-11-16 Update documentation in broker code
    [broker.py]
2017-12-13 Makai Reader utility will print THD
2017-12-19 Updated the schematics to those submitted for Dec 2017 order.
    [BOM.csv, opqbox2.pcb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]
2018-01-04 Working migration of CalibrationConstants to opq_boxes
2018-01-06 Cachce calibration constants
2018-01-09 Added documentation for OPQBox assembly
2018-01-13 Updated migration script to decimate the measurements collection to a single measurements per device per minute during the migration procress.
2018-01-17 added initial values to the filters
2018-01-17 Got rid of a biquad filter and used average instead
2018-01-18 Calibration_constant field in opq_boxes schema should allow decimals
2018-01-24 Remove print statement
2018-01-29 Update FilterForm template with additional form/widget types
2018-02-07 Fix bug where calibration constant was not being properly loaded in mauka. This in turn was causing issues calculating THD and ITIC as events come in.
2018-02-13 Fix naive distributed event detector to remove all harmonics of 60hz
2018-02-22 Add statistics printing with thread
2018-02-26 Add locks for thread safety
2018-02-27 Updated kernel driver compilation for debian stretch
2018-03-04 enable uart by default
    [config.txt]
2018-03-05 added a 6pc box laser drawing
    [opqbox2.dxf]
2018-03-11 Initial commit
    Removed unnecessary files.
    Made placeholder landing page.
2018-03-12 Added an infinite waveform generator. The parameters of the surrounding class can be updated at runtime and the generator will generate new values based on the current state of the generator. This al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
2018-03-12 Added signed 16bit scaling and connected server to wave generation thread.
2018-03-12 Add initial concept for a 'delayed' filter.
2018-03-13 Currently fixing graph
2018-03-14 Working with json config file states and filters.
2018-03-14 In-order to ensure only waveform samples get sent to stdout, added a verbosity arguments that silences everything else by default.
2018-03-14 Fix thread sleep rate.
2018-03-14 Add debug argument for printing Vrms from sim.
2018-03-14 Add OPQ device FIFO
2018-03-14 Perform sleeping in device fifo
2018-03-14 Make sure filters are reset when state is updated
2018-03-14 Add ability to remove filters from generator
2018-03-20 Created skeletal components for all landing page widgets.
2018-03-20 Looks like this.props.children should be PropTypes.node
2018-03-21 Stop syncedcron from printing a message every 10 seconds.
2018-03-30 handle case when stats collection hasn't been created yet.
2018-03-31 Update System Stats with Today's data, landing page edit
2018-04-01 WIP - http request issues
    [health.py]
2018-04-03 Got pan-zoom working. Probably will switch to timeseries-chart now.
2018-04-03 Add error handling for mauka http request
    [health.py]
2018-04-12 Insert all documents for now
2018-04-19 Prop-state handling working
2018-04-21 Fixed slight insanity of passing recursive types across foreign call interface
    [main.rs]
2018-04-25 Shorten box check interval
    [health.py]
2018-05-01 Added documentation and lots of error checking.
    [config.rs, main.rs]
2018-05-01 Change Mauka's AcquisitionTrigger plugin to utilize a push socket for sending trigger messages to makai.
2018-05-02 Fix event message read
    [health.py]
2018-05-02 Update OPQBox 2 calibration constant
2018-05-10 Fixed issue with batch insert to mongo
    [mongo.rs]
2018-05-10 Fixed instalation files. Edited sample configs to match installation.
2018-05-13 Sorted buttons
2018-05-16 Remove redundant namespace around mongo. Move methods for calibration constants into mongo since they aren't truly constant.
2018-05-17 Add OPQBox version 3
    [BOM.csv, chip_pro.sch, connectors.sch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]
2018-05-19 Add opqbox v3 pdf schematics
2018-05-22 Add test-app framework, clean up api/
2018-05-22 A bit more test-app framework development. Forgot to switch back to issue-139!
2018-05-23 Implement ability to switch box positioning on map based on the box's location coordinates or the box's region; add Region to publications file
2018-05-27 Implement ability to filter boxes by Location or Region in the BoxMap component
2018-05-30 Add button to toggle fullscreen mode on map
2018-05-30 Add a noPadding prop option to the WidgetPanel that will remove the top and bottom padding of the segment that contains the passed in child component
2018-05-30 Use the WidgetPanel's noPadding prop option
2018-05-30 Buttons in the side panel redirects to appropriate page
2018-05-30 Major cleanup of THD plugin. All work is now performed in numpy or scipy to get it as efficient as we can with the current approach. A STFF might end up still being more efficient.
2018-05-30 Change from peak to peak to raw voltage.
2018-05-30 Fix edge case where provided waveform is < window size.
2018-05-31 Add manufacturer files
    [bom.csv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]
2018-05-31 Fix bugs in triggering protocol. This mainly involved adding measurements as protobuffed entities within mauka to enforce types.
    [FrequencyThresholdPlugin.py, VoltageThresholdPlugin.py]
2018-06-05 Box marker labels can now be defined by passing a callback to the 'boxMarkerLabelFunc' prop of the OpqBoxLeafletMarkerManager component
2018-06-06 Implemented integrity checker framework and a checker for Events.
2018-06-06 Cluster labels (inner and side labels) can now be defined by passing a callback to the 'markerClusterLabelFunc' and 'markerClusterSideLabelFunc' props of the OpqBoxLeafletMarkerManager component
2018-06-06 Refactor BoxMap to only filter by Region
2018-06-06 debug statements and removed unnecessary conversion of samples variable to numpy.array
2018-06-06 Remove Data Display button and all related methods for its functionality
2018-06-08 Box marker popups can now be defined by passing a callback to the 'boxMarkerPopupFunc' prop of the OpqBoxLeafletMarkerManager component
2018-06-08 Remove box settings button from box legend
2018-06-08 Utilize Numpy's FFT implementation to find DFT of sampled waveform to find frequency
    Utilize Numpy's FFT implementation to find DFT of sampled waveform to
    find frequency, this is a giving a more precise measurement of the
    frequency than the zero crossing method was.
2018-06-10 Add an 'initialBoxIds' prop to the EventInspector and LiveData components; BoxMap buttons now properly link to the LiveData and EventInspector pages with the appropriate OpqBox selected
2018-06-17 Update frequency variation plugin to create incidents
    Update frequency variation plugin to create incidents.
    Incident start and end timestamps are calculated using box the box
    event start timestamp.
    Incidents “deviation_from_nominal” field is the average frequency
    variation while the incident was occurring.
2018-06-26 After fixing pep8 violations.
    [mock.py]
2018-06-28 Most convention level lints fixed.
    [base_plugin.py, itic_plugin.py, makai_event_plugin.py]
2018-06-28 Merge branch 'master' into issue-147
    # Conflicts:
    # mauka/plugins/__init__.py
    [base.py, mock.py]
2018-07-04 Add Ieee1159 voltage
2018-07-04 fixed some naming mistakes in the unittest file for Ieee1159 voltage incident
2018-07-06 some transfering mistakes fixed
    [ieee1159_voltage_plugin.py]
2018-07-13 Just fixed some typos in comments
    [ieee1159_voltage_plugin.py]
2018-07-20 progress: create filtered and fundamental waveform, cleaned some code for linters
    progress: create filtered and fundamental waveform, cleaned some code
    for linters
2018-07-23 Fix mongo, ieee1159 voltage, and semi_f47 modules to pass linters.
    [ieee1159_voltage_plugin.py, semi_f47_plugin.py]
2018-07-24 Setup authentication and threading
2018-07-25 Fix U1 for real this time
    [opqbox3-B.Cu.gbr, opqbox3-B.Mask.gbr, opqbox3-B.SilkS.gbr, opqbox3-Edge.Cuts.gbr, opqbox3-F.Cu.gbr, opqbox3-F.Mask.gbr, opqbox3-F.SilkS.gbr, opqbox3-Ground_Plane.gbr]
2018-07-26 Implement multiple zero crossing classifier and updated noise floor configuration
    Implement multiple zero crossing classifier and updated noise floor
    configuration so that it is %5 of the nominal waveform’s DC voltage.
    [transient_plugin.py]
2018-08-01 Oscillatory, Arcing, Impulsive, and helper functions
    Oscillatory, Arcing, Impulsive, and helper functions
    [transient_plugin.py]
2018-08-08 Generate gerbers
    [opqbox3-B.Cu.gbr, opqbox3-B.Mask.gbr, opqbox3-B.Paste.gbr, opqbox3-B.SilkS.gbr, opqbox3-Edge.Cuts.gbr, opqbox3-F.Cu.gbr, opqbox3-F.Paste.gbr, opqbox3-F.SilkS.gbr]
2018-08-30 Develop calibration utility
2018-09-06 Fix windowing issues with THD plugin
    [thd_plugin.py]
2018-09-20 Reenable coala dependency. Was having trouble with it a couple days ago. Forgot CI would stop working if it wasn't in the requirements file.
2018-09-25 downsampling and filtering before frequency calculation to improve runtime
2018-09-26 Move calibration utility to new folder and create Makefile
2018-10-04 Improve legibility of x-axis labels on waveform graph
2018-10-10 Update health to not request data from devices, to clean up after itself, and to ignore deployment files in git.
2018-10-10 merged the test fixtures. Bug fixes
    [config.rs, main.rs]
2018-10-11 Implement downloadable waveform data in CSV format; add download button to the UI
2018-10-13 Refactor button links in the BoxMap component to now link to the EventInspector using URL params rather than react-router's location state object
2018-10-22 Fix issue with Health indicating Makai as being down
    [health.py]
2018-10-23 Ensure that any non-health check event messages from Makai are ignored and skipped; recv() is now called until a health check event message is received
    [health.py]
2018-12-08 First commit with UH metering bridge for ground truth.
2019-01-03 Add script to be called from cron once per hour to update ground truth in database.
2019-01-11 Oscillatory classifier test passing and transient sliding window error fixed
    Oscillatory classifier test passing and transient sliding window error fixed
    [transient_plugin.py]
2019-01-16 Fix pylint false positive in new versions of pylint which doesnt detect if numpy functions correctly return something or not.
    [semi_f47_plugin.py]
2019-01-17 Ensure that SSIDs are filtered for duplicates.
2019-01-18 Wire up update button.
2019-01-20 Transient classifier test progress. Found and noted bugs with oscillatory classifier
    [transient_plugin.py]
2019-01-24 passing tests and updated oscillatory classifier to perform incremental F test
    [transient_plugin.py]
2019-01-29 Display current update version in box config daemon.
2019-02-06 minor bug fix in transient plugin noise canceler
    minor bug fix in transient plugin noise canceler
    [transient_plugin.py]
2019-02-08 Boiler plate code for the mongo plugin
2019-02-08 More boiler plate
2019-02-14 Pretty print the debug messages.
2019-02-15 Commit for Il's code sample
2019-02-27 Switch to debian buster slim for rust.
2019-02-28 Remove EventsTimeline from Landing Page.
2019-03-01 Fix Makai http health check
    [health.py]
2019-03-01 Fix the Edit button for Locations and Users.
2019-03-06 Print the command being sent.
2019-03-07 Fix subcomponent recursion limit to a depth of one.
    [status_plugin.py]
2019-03-07 Fix JSON serialization for status plugin.
    [status_plugin.py]
2019-03-07 Fix linting issues. Also ignore pylint F002 as it doesn't play nice with python 3.7
    [status_plugin.py]
2019-03-07 Reduce number of docker layers, switch to stretch-slim for convienince and reduce size of docker context by not sending entirety of opq to daemon.
2019-03-07 Fix path in sample config.
2019-03-12 This is why we are moving to rust. A forgoten mutex is not held and a threadshared datastructure is corrupted in the AB.
2019-03-12 Remove extra character in makai sample config.
2019-03-13 utility to print device triggering stream
2019-03-13 Fix linting errors and logging call.
    [base_plugin.py, system_stats_plugin.py]
2019-03-13 Test not starting the timer.
2019-03-13 Fix issue with subscription and add new configs.
    [base_plugin.py, system_stats_plugin.py]
2019-03-14 We at least know where the issue is, now to figure out why it is.
    [makai_event_plugin.py]
2019-03-14 Use configured mongo client for obtaining the calibration constant.
2019-03-15 Fix calibration constant.
2019-03-18 Make sure calibration constant is properly retrieved.
2019-03-18 Fix summing of collections.
    [system_stats_plugin.py]
2019-03-18 Fix some linting issues.
    [system_stats_plugin.py]
2019-03-21 Add optional title prop to WaveformViewer component
2019-03-21 Display button links to related events and incidents in IncidentViewer's 'Related' menu tab
2019-03-22 Lay groundwork for GC implemented as plugin.
2019-03-25 Add ability to filter by classifications and ieee durations in IncidentInspector component; Add ability to filter on 'ALL' for box ids, classifications, and ieee durations.
2019-03-28 Add button link to IncidentInspector in BoxMap
2019-03-28 Display button links to all derived Incidents from EventOverview component
2019-03-28 Event storage to separate process
    [opqbox3.kicad_pcb]
2019-03-28 Fix sample config.
2019-04-01 Return the timestamp in seconds, not milliseconds.
2019-04-04 Switch to unix timestamp
2019-04-04 Fix bug in makai that doesn't allow it to read laha config on emilia.
    [mongo_ttl.rs]
2019-04-04 Fix ttl addition logic.
    [mongo_ttl.rs]
2019-04-05 Fix stopping mauka from running.
    [laha_gc_plugin.py, semi_f47_plugin.py]
2019-04-09 Fix protobuf creation, add more debugging.
    [system_stats_plugin.py]
2019-04-09 Don't forget to reset the system stats.
    [system_stats_plugin.py]
2019-04-09 Fix query for active device ids.
2019-04-09 MAke sure device ids are filtered.
2019-04-11 Fix mongo insert unwrap
    [main.rs]
2019-04-18 Start fixing linting issues.
    [laha_gc_plugin.py]
2019-04-18 Fix remaining lint errors.
    [system_stats_plugin.py]
2019-04-18 Update urls temporarily to fix docker networking issue
    [main.rs]
2019-04-24 Use current time for mauka health endpoint.
2019-04-24 Wire in the display metrics logic.
2019-04-25 Fix bug creating GC update messages.
    [laha_gc_plugin.py, makai_event_plugin.py]
2019-04-26 Fix bug in THD plugin windowing function.
    [thd_plugin.py]
2019-04-26 Moved brokers to rust with mongo reporting
    [dsp.sch, io.sch, opqbox3.sch, pi.sch, power.sch]
2019-05-07 Small fixes and log
    [main.rs]
2019-05-10 bug fixes and permissions
    [app_to_box.rs, box_to_app.rs, build.rs, config.rs, constants.rs, key_parser.rs, main.rs]
2019-05-15 types from mongo fix in event service
    [build.rs, config.rs, constants.rs, main.rs, mongo_event_storage.rs, mongo_ttl.rs]
2019-05-16 Add TTL values to System Stats on landing page.
2019-05-16 Fix app-tests by handling the case of the TTLs not being available.
2019-05-28 Work towards fixing mongo client.
    [mongo.rs]
2019-06-27 print payload
2019-07-19 Update protobuf generation so that paths are imported correctly for makai's protobuf files.
    [base_plugin.py, trigger_plugin.py]
2019-08-20 Add more error handling
    [auth.rs, conf.rs, main.rs, resources.rs, scrape.rs]
2019-08-21 Fixed timestamp field to match what we previously did.
    [scraper.rs]
2019-08-21 Don't fail immediately when data doesn't make sense.
    [main.rs, resources.rs]
2019-08-22 Add ability to extract samples from Makai's cycle messages.
2019-08-29 Update configs to fix ports.
    [trigger_plugin.py]
2019-08-30 Lay groundwork for ThresholdOptimizationPlugin.
2019-09-02 Fixed lost print statements
2019-09-03 Fix expire_at timestamps for events, measurements, trends
    [mongo_event_storage.rs, mongo_ttl.rs]
2019-09-03 Fix setting plugin name.
    [threshold_optimization_plugin.py]
2019-09-05 Fix type in projection mongo query in laha gc plugin
    [laha_gc_plugin.py]
2019-09-05 Fix logging for ITIC plugin
    [itic_plugin.py]
2019-09-05 Fixes for gc plugin
    [itic_plugin.py, laha_gc_plugin.py]
2019-09-17 Ensure the correct responses are received from Makai.
    [box_optimization_plugin.py, trigger_plugin.py]
2019-09-17 Silence incorrect linting errors for ZMQ members.
    [box_optimization_plugin.py]
2019-10-23 Update trend plots to fix freq and voltage labels and increase horiz spacing between subplots.
2019-10-25 Switch to shapely, remove matplotlib, add tests, lint
2019-10-29 Update report voltage incident plotting.
2019-10-30 Updates for IEEE 1159 voltage. Improve searching of segments for voltage issues.
    [ieee1159_voltage_plugin.py]
2019-10-31 Start testing new voltage algotithms.
2019-11-06 Update unit tests for ieee1159 voltage plugin.
2019-11-07 Test THD function with synthetic power data.
2019-11-13 Bug fixes in event parsing
    [main.rs]
2019-11-13 Wrap the data conversion functions for error handling.
    [makai_event_plugin.py]
2019-11-13 Add lots of error catching. Give those plugins a chance to do something useful already!
    [frequency_variation_plugin.py, ieee1159_voltage_plugin.py, itic_plugin.py, semi_f47_plugin.py]
2019-11-15 pretty print manifest
2019-11-19 Start adding some analysis code for looking at the periodic voltage sags.
2019-11-21 utility to measure latency for devices
2019-12-06 Update ground truth storage
2019-12-08 Ground truth collection a single device and feature at a time
2019-12-10 Update ground truth collection and analysis.
